manojgulati/Harmonic-Analyser/Harmonic Analyser/Project_Report/Power Harmonic Analyser using ADE7880 and KL-34 Processor ver 1.0.pptx

## Power Harmonic Analyser using ADE7880 and KL-34 Processor

Manoj Gulati
SESDP-14
11/17/2014

## Non Intrusive Load Monitoring

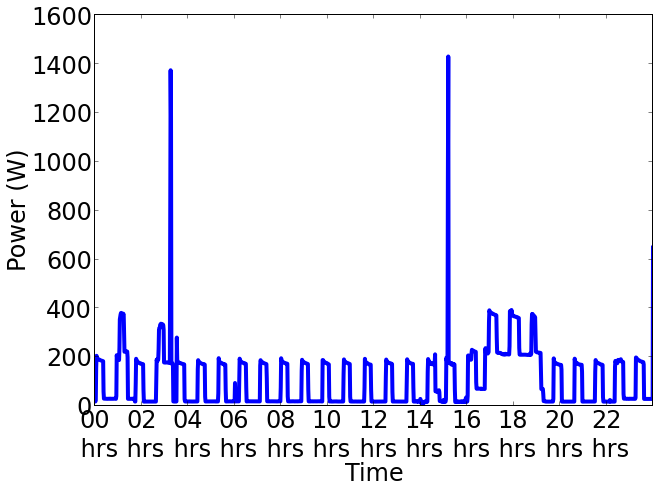
[picture p5: figure]
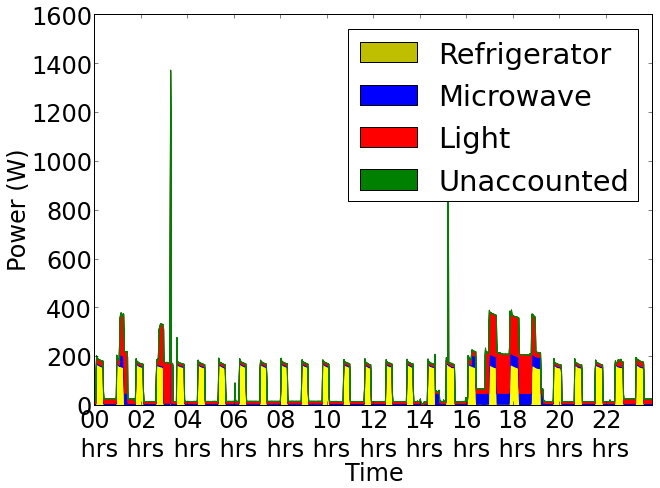
[picture p6: figure]

Image Source- http://energy.iiitd.edu.in

## Challenges with Time Domain

Time varying power consumption [Barker, 2013]

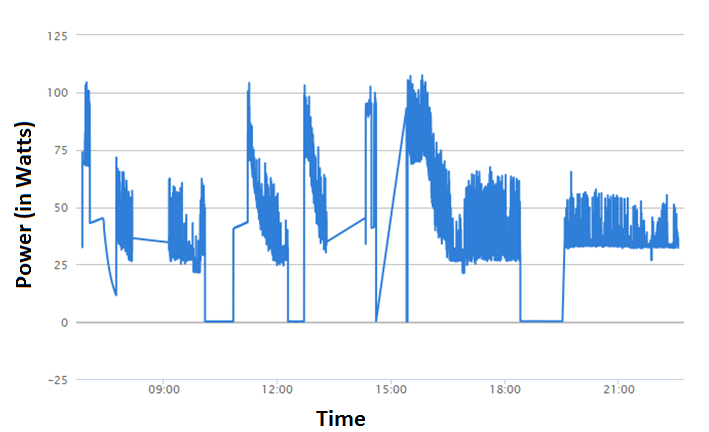
[picture p7: figure]

Figure: Time varying power consumption of a laptop charger.

100 W

Image: Batra, 2013

Notes: Why single point sensing is complex?

Answer to this question lies in this plot. As we know most of the time series modelling approaches are based on a assumption that appliances show time-invariant power consumption.

But in practice most of the present day appliances don’t follow this. Now question comes why ? I will try to answer this in coming slides.

Few more challenges include appliances with similar power signatures and low power appliances which get overlapped and make disaggregation a complex task.

## Slide 4

Time varying power consumption of a laptop charger

100 W

Notes: Why single point sensing is complex?

Answer to this question lies in this plot. As we know most of the time series modelling approaches are based on a assumption that appliances show time-invariant power consumption.

But in practice most of the present day appliances don’t follow this. Now question comes why ? I will try to answer this in coming slides.

Few more challenges include appliances with similar power signatures and low power appliances which get overlapped and make disaggregation a complex task.

## Possible Solution

- Frequency Domain analysis using power line harmonics.

## COTS

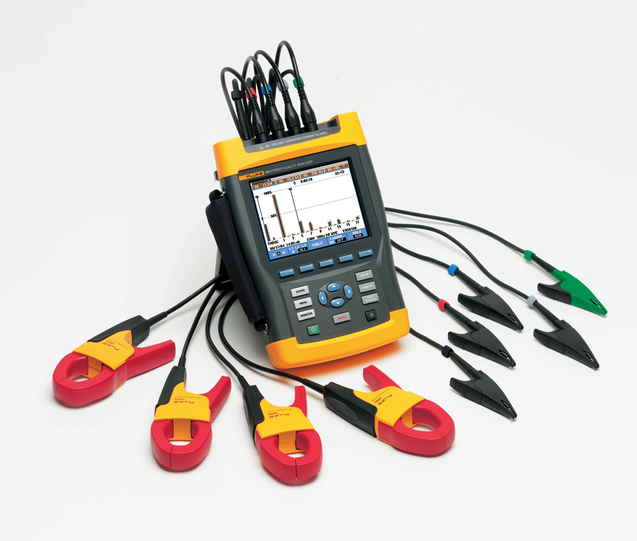
[picture p8: figure]

- Cost around 2 lakhs
- Lack of configurability
- Lack of communication interfaces

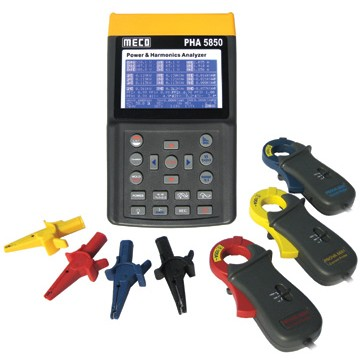
[picture p9: figure]

Challenges with COTS

## Harmonic Analyser

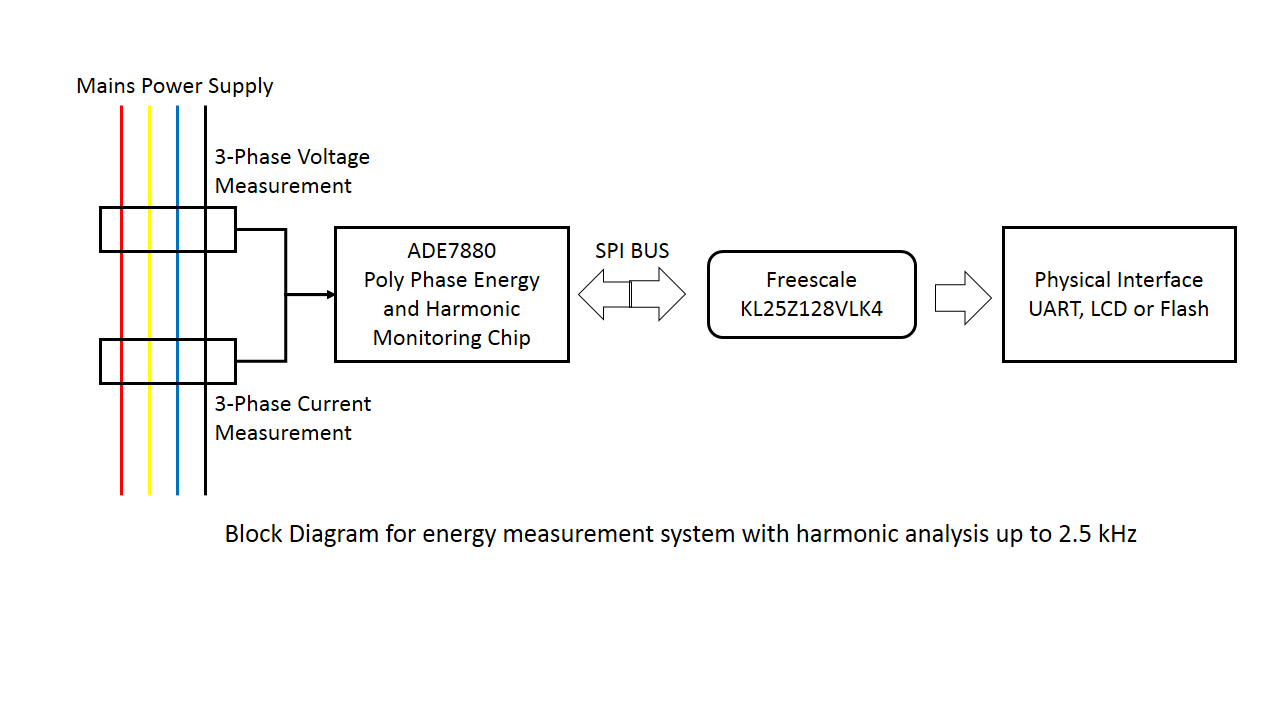
[picture p10: figure]

KL34

## Any Progress??

## Thank You

Manojg.
