manojgulati/Harmonic-Analyser/Harmonic Analyser/Project_Report/Presentation1.pptx

## Slide 2

Mains Power Supply

Serial Flash
(Local Storage)

3-Phase Voltage Measurement

ADE7880
Poly Phase Energy and Harmonic Monitoring Chip

SPI BUS

Serial Communication Interface
UART, RS-485

3-Phase Current Measurement

Freescale MKM34Z128CLL5

Graphic Display

Block Diagram For Energy Measurement System With Harmonic Analysis Up To 2.5 Khz

## Slide 3

VOLTAGE
CONDITIONING

## Slide 4

Block Diagram of proposed energy measurement system with harmonic analysis up to 2.5 kHz

Mains Power Supply

3-Phase Voltage Measurement

Signal Conditioning Circuit

Voltage Conditioning Circuit

Current Conditioning Circuit

3-Phase Current Measurement

Local Storage

Analog Data Acquisition System

Signal Processing and Harmonic Computation System

Controller Circuit

Graphical Display

Communication Interface
