manojgulati/Harmonic-Analyser/Harmonic Analyser/Proposals/Presentation1.pptx

## Slide 2

Mains Power Supply

3-Phase Voltage Measurement

ADE7880
Poly Phase Energy and Harmonic Monitoring Chip

SPI BUS

Physical Interface
UART, LCD or Flash

3-Phase Current Measurement

Freescale MKM34Z128CLL5

Block Diagram for energy measurement system with harmonic analysis up to 2.5 kHz
