manojgulati/Harmonic-Analyser/Harmonic Analyser/Orcad_Capture_SESDP/ver2.10/Project_Layout_Outline.docx

HEADER-3

HEADER-1

LED – CF2

LED – CF3

LED - CF1

I (Phase-A)

I (Phase-N)

I (Phase-C)

I (Phase-B)

Analog Devices

ADE-7880

V (Phase-N)

V (Phase-C)

V (Phase-A)

HEADER-2

V (Phase-B)

Graphic LCD

Freescale

KM-34

100 TQFP

SPI-0 BUS SPI-1 BUS

USB

BUS

FT232-RL

SPI Flash

SW-5

SW-4

SW-3

SW-2

SW-1
