manojgulati/Harmonic-Analyser/Harmonic Analyser/Orcad_Capture_SESDP/ver2.12/HA-EDITEDnet.rep.docx

NET LIST REPORT -- HARMONICS ANALYSER-A.pcb -- Fri Jan 30 11:49:36 2015

*SIG +3.3V

C101.1.U C102.1.U U17.10.U C52.1.U

C73.1.U J81.1.U C74.1.U J83.1.U

C77.1.U C78.1.U C79.1.U C85.1.U

R85.1.U R92.1.U C89.1.U R89.2.U

C96.2.U U17.62.U C99.1.U D1.1.U

D4.2.U D2.2.U J17.3.U D3.2.U

D5.2.U D6.2.U J14.10.S J94.4.U

J25.1.U R12.1.U J95.2.U U17.61.U

L13.1.U LCD1.14.U LCD1.28.U U13.8.U

R13.1.U R14.2.U U12.2.U R15.1.U

R23.1.U R25.2.U U1.26.U R93.1.U

U1.5.U U19.8.U U23.8.U

*SIG /RD

LCD1.5.U U17.6.U

*SIG /WR

LCD1.4.U U17.4.U

*SIG 5V

C95.2.U C92.1.U J13.1.U U12.1.U

K1.5.U D12.1.U

*SIG A0

LCD1.3.U U17.3.U

*SIG AGND

C107.2.U C108.2.U C109.2.U C110.2.U

C87.2.U C55.2.U C53.2.U C56.1.U

C54.1.U R113.1.U C69.2.U C60.2.U

C58.2.U C61.1.U C59.1.U R58.2.U

R59.1.U C70.1.U C64.2.U R71.1.U

C65.1.U C66.2.U C67.1.U R78.1.U

C68.2.U R79.2.U C72.1.U C71.2.U

R80.1.U C75.2.U C76.2.U L17.1.U

C81.2.U C83.2.U C93.2.U C94.2.U

R90.1.U R107.1.U R51.2.U R52.1.U

R70.2.U TP9.1.U TP10.1.U TP7.1.U

TP6.1.U SW1.1.U TP8.1.U U1.25.U

SW1.2.U

*SIG AVDD

R89.1.U J82.1.U C76.1.U C75.1.U

U1.24.U

*SIG CF1

U17.71.U J5.3.U J1.1.U U1.33.U

D10.1.U J6.3.U

*SIG CF2

U17.70.U J6.2.U J5.4.U D7.1.U

J3.1.U U1.34.U

*SIG CF3

U17.69.U J6.1.U J5.5.U J4.1.U

D11.1.U U1.35.U

*SIG CLKIN

U1.27.U R2.1.U Y1.1.U C30.2.U

*SIG CLKOUT

U1.28.U R2.2.U Y1.2.U C29.2.U

*SIG CS1

LCD1.1.U U17.1.U

*SIG D0

LCD1.6.U U17.9.U

*SIG D1

LCD1.7.U U17.12.U

*SIG D2

LCD1.8.U U17.13.U

*SIG D3

LCD1.9.U U17.14.U

*SIG D4
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

C17.1.U LCD1.21.U

*SIG N1983147

C18.1.U LCD1.22.U

*SIG N1983151

C18.2.U C19.2.U C20.2.U C21.2.U

C22.2.U

*SIG N1983167

C20.1.U LCD1.24.U

*SIG N1983179

C19.1.U LCD1.23.U

*SIG N1983183

C21.1.U LCD1.25.U

*SIG N1983207

R14.1.U LCD1.30.U

*SIG N1983211

C22.1.U LCD1.26.U

*SIG N1983241

LCD1.27.U J2.2.U

*SIG N1983309

R16.1.U J2.3.U

*SIG N2275511

R72.2.U C66.1.U R75.1.U

*SIG N2580186

R95.1.U D7.2.U

*SIG N2586115

R96.1.U D10.2.U

*SIG N2613784

R76.1.U R98.2.U

*SIG N2618478

R98.1.U R77.2.U

*SIG N2635561

R100.2.U R78.2.U L10.2.U

*SIG N2636856

R99.1.U R76.2.U

*SIG N2691596

R103.1.U R101.2.U

*SIG N2691672

R105.1.U R106.2.U

*SIG N2691700

R106.1.U R103.2.U

*SIG N2721847

R108.1.U R102.2.U

*SIG N2721891

L15.2.U R107.2.U R109.2.U

*SIG N2721927

R110.1.U R111.2.U

*SIG N2721955

R111.1.U R108.2.U

*SIG N2759148

L16.2.U R113.2.U R115.2.U

*SIG N2759210

R114.1.U R112.2.U

*SIG N2759258

L16.1.U R116.2.U

*SIG N2759290

R116.1.U R117.2.U

*SIG N2759318

R117.1.U R114.2.U

*SIG N3004104

R97.1.U D11.2.U

*SIG N3274451

L10.1.U R99.2.U

*SIG N3328925

L15.1.U R110.2.U

*SIG N3437331

R50.1.U D1.2.U

*SIG N19748480

R86.1.U D9.1.U

*SIG N19749300

R87.1.U D8.1.U

*SIG N19829790

R15.2.U J2.1.U

*SIG N197275034

U17.37.U C103.2.U

*SIG NC

U1.10.U U1.11.U U1.20.U U1.21.U

U1.30.U U1.31.U U1.40.U U1.1.U

*SIG NMI_B

U17.5.U J17.2.U

*SIG PM0

J78.1.U U1.2.U U17.74.U J5.10.U

J6.6.U

*SIG PM1

J79.1.U U1.3.U U17.75.U J5.11.U

J6.7.U

*SIG REF

C83.1.U C81.1.U J98.1.U U1.17.U

*SIG RES

LCD1.2.U U17.2.U

*SIG RESETB

U1.4.U C85.2.U R85.2.U SW1.4.U

SW1.3.U

*SIG RESET_B

J95.4.U U17.56.U TS.3.U R23.2.U

C106.1.U

*SIG RTC_CLKOUT

J95.1.U U17.67.U

*SIG SCK

U1.36.U J5.6.U U17.78.U J6.10.U

*SIG SS_B

J6.9.U U17.77.U J5.9.U U1.39.U

*SIG SWD_CLK

J95.3.U U17.66.U U19.4.U

*SIG SWD_IO

U19.1.U U17.65.U J95.5.U

*SIG VAP

R109.1.U C108.1.U J49.1.U C107.1.U

U1.23.U

*SIG VAP_IN

R102.1.U J99.3.U

*SIG VBP

R115.1.U C110.1.U C109.1.U J54.1.U

U1.22.U

*SIG VBP_IN

R112.1.U J99.2.U

*SIG VCP

R100.1.U C68.1.U C87.1.U J68.1.U

U1.19.U

*SIG VCP_IN

R77.1.U J99.1.U

*SIG VDDA

U17.32.U J90.1.S J93.1.U J90.9.S

J85.1.S J85.9.S

*SIG VDD_FT232

U20.4.U U21.8.U R91.1.U D9.2.U

U20.17.U D8.2.U C90.1.U R94.1.U

C86.1.U

*SIG VN

U1.18.U J37.1.U C93.1.U C94.1.U

R9.2.U

*SIG VN_IN

R101.1.U J99.4.U

*SIG VREF

J90.8.S J85.8.S C105.2.U

*SIG VREFH

J90.6.S J85.6.S C103.1.U

*SIG VREFL

J90.7.S J85.7.S C104.2.U

*SIG ~IRQ0

U1.32.U J96.1.U J5.2.U U17.72.U

J6.4.U

*SIG ~IRQ1

U1.29.U J89.1.U J5.1.U U17.73.U

J6.5.U

*SIG $$$1

J7.1.U K1.1.U

*SIG $$$2

J93.5.U U17.31.U L13.2.U C97.1.U

C98.1.U

*SIG $$$3

J7.2.U K1.3.U

*SIG $$$4

J7.3.U K1.4.U

*SIG $$$5

K1.2.U D12.2.U Q1.C.U

*SIG $$$6

R3.2.U Q1.B.U

*SIG $$$7

R3.1.U U17.50.U

*SIG $$$8

R105.2.U L14.1.U

*SIG $$$9

R9.1.U R90.2.U L14.2.U
