manojgulati/Harmonic-Analyser/Harmonic Analyser/EVAL-ADE7880EBZ_2.PNG

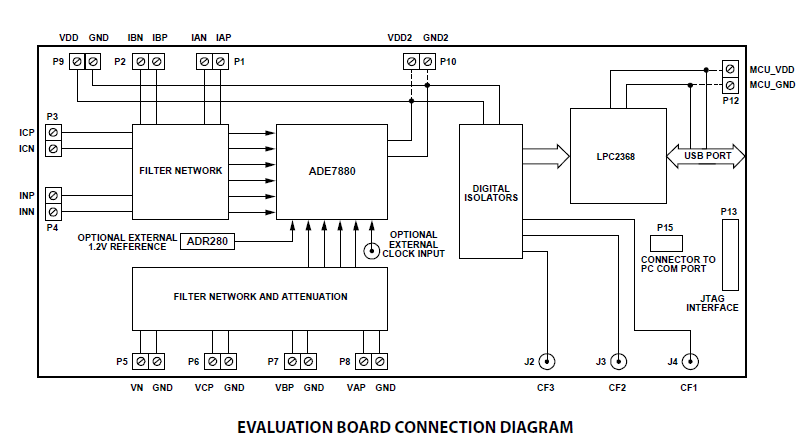
Harmonic Analyser/EVAL-ADE7880EBZ_2.PNG
