manojgulati/Harmonic-Analyser/Harmonic Analyser/Project_Report/Power Harmonic Analyser using ADE7880 and KL-34 Processor ver 1.0.png

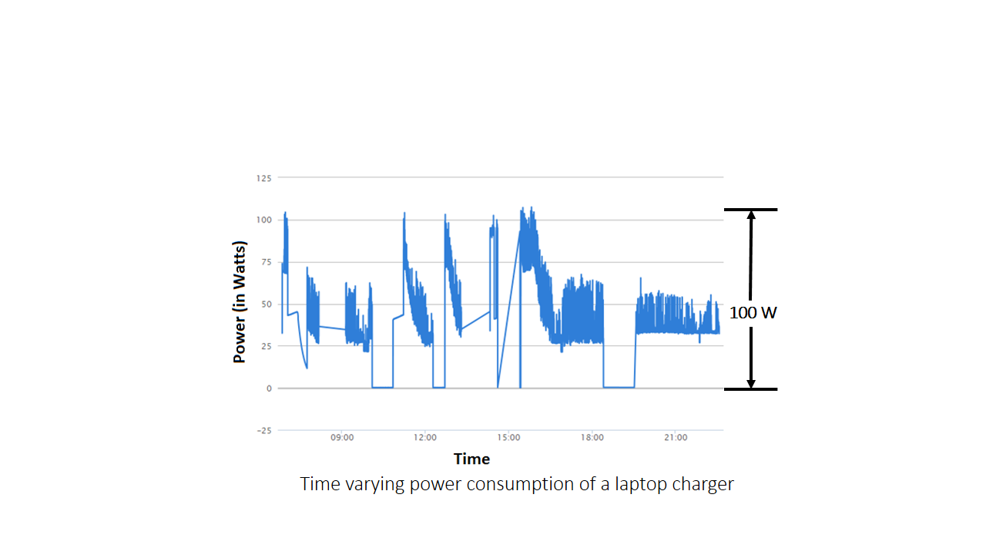
Harmonic Analyser/Project_Report/Power Harmonic Analyser using ADE7880 and KL-34 Processor ver 1.0.png
