manojgulati/Harmonic-Analyser/Harmonic Analyser/Project_Report/Presentation3.jpg

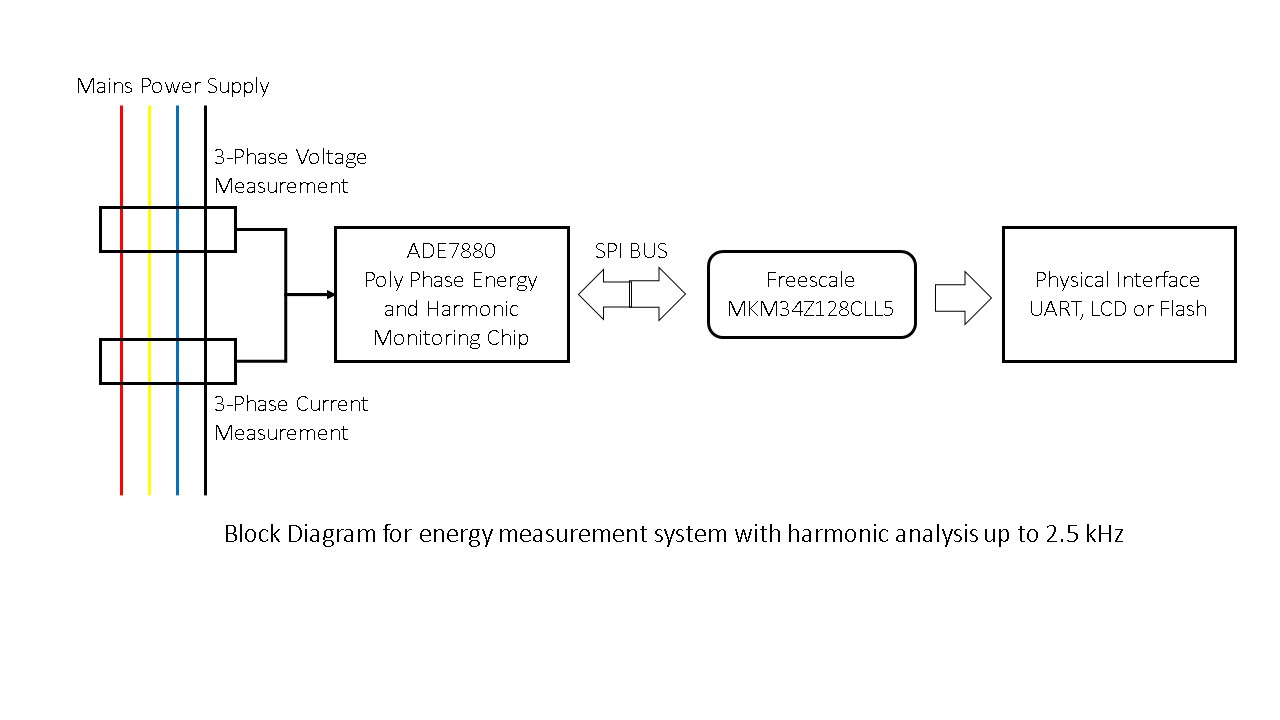
Harmonic Analyser/Project_Report/Presentation3.jpg
