manojgulati/Harmonic-Analyser/Harmonic Analyser/Orcad_Capture_SESDP/ver2.0/PAGE1_SCHEMATIC1_PAGE6.dxf

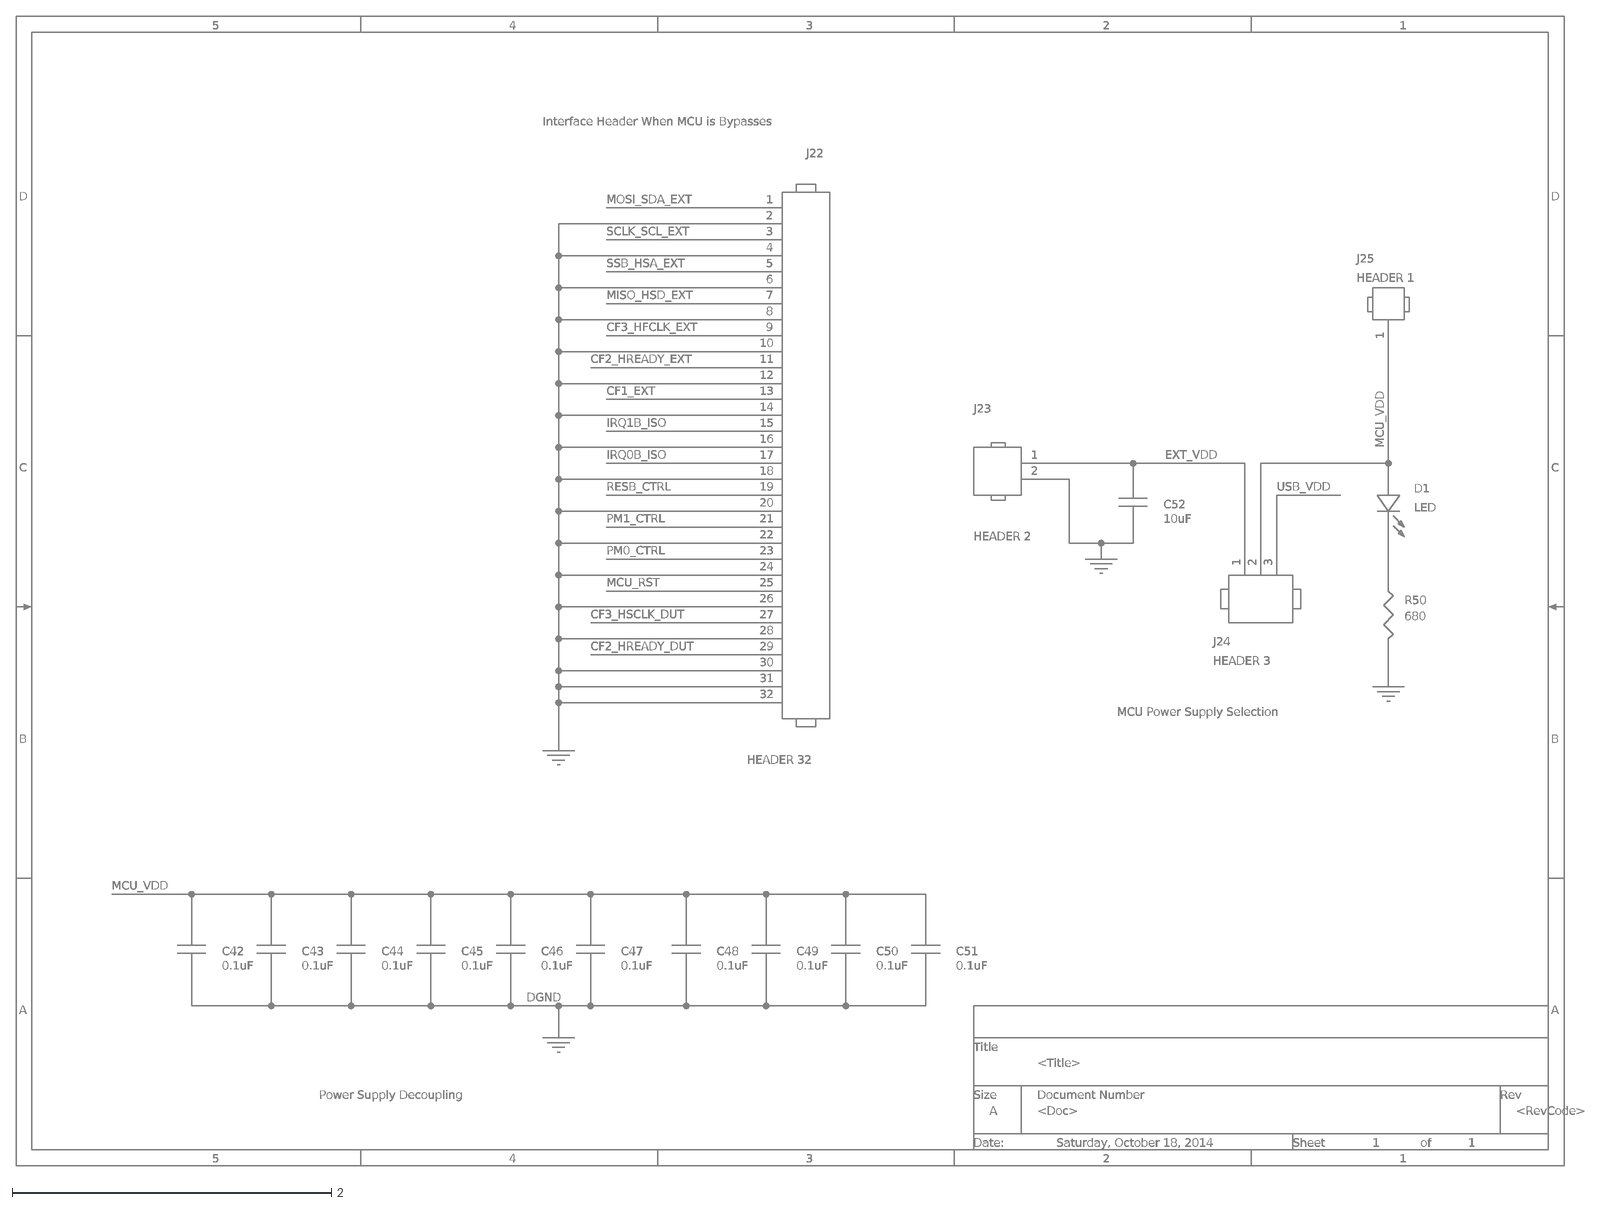
[picture p47: CAD file, 2014-12-17, an earlier design]
Harmonic Analyser/Orcad_Capture_SESDP/ver2.0/PAGE1_SCHEMATIC1_PAGE6.dxf
5
4
3
2
1
D
C
B
A
<Doc>
<RevCode>
<Title>
Saturday, October 18, 2014
Title
Size
Document Number
Rev
Date:
Sheet
of
C42
0.1uF
C44
C52
10uF
C48
C43
C47
D1
LED
J25
HEADER 1
C51
C46
R50
680
J23
HEADER 2
C50
J22
HEADER 32
6
7
8
9
10
11
12
13
14
15
16
17
18
19
20
21
22
23
24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
