manojgulati/Harmonic-Analyser/Harmonic Analyser/Orcad_Capture_SESDP/ver2.1/PAGE1_SCHEMATIC1_PAGE8.dxf

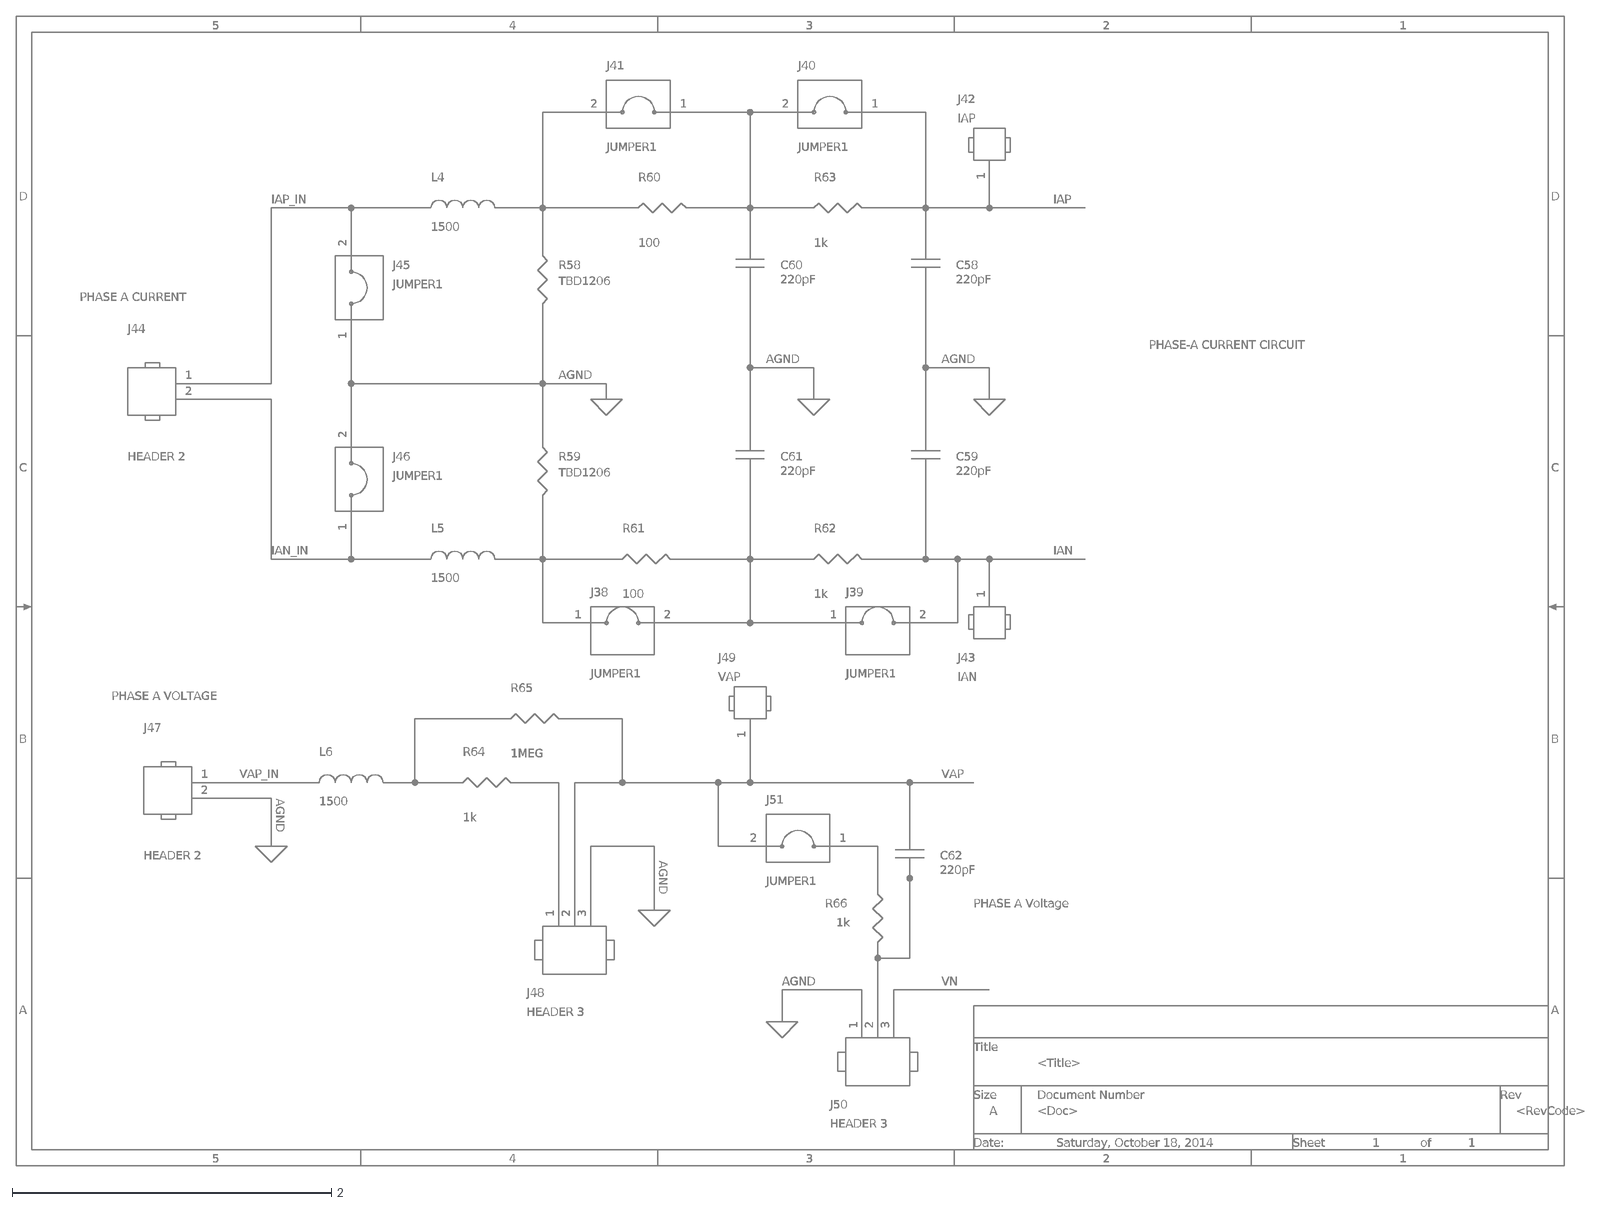
[picture p48: CAD file, 2014-12-17, an earlier design]
Harmonic Analyser/Orcad_Capture_SESDP/ver2.1/PAGE1_SCHEMATIC1_PAGE8.dxf
5
4
3
2
1
D
C
B
A
<Doc>
<RevCode>
<Title>
Saturday, October 18, 2014
Title
Size
Document Number
Rev
Date:
Sheet
of
R60
100
J45
JUMPER1
J47
HEADER 2
C61
220pF
J50
HEADER 3
R61
J46
J42
IAP
L6
1500
R62
1k
J43
IAN
R66
R64
R63
L4
J48
C58
J40
R58
TBD1206
L5
J38
C62
J51
C59
R65
1MEG
J41
R59
J44
J49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
