manojgulati/Harmonic-Analyser/Harmonic Analyser/Orcad_Capture_SESDP/ver2.2/PAGE1_SCHEMATIC1_PAGE10.dxf

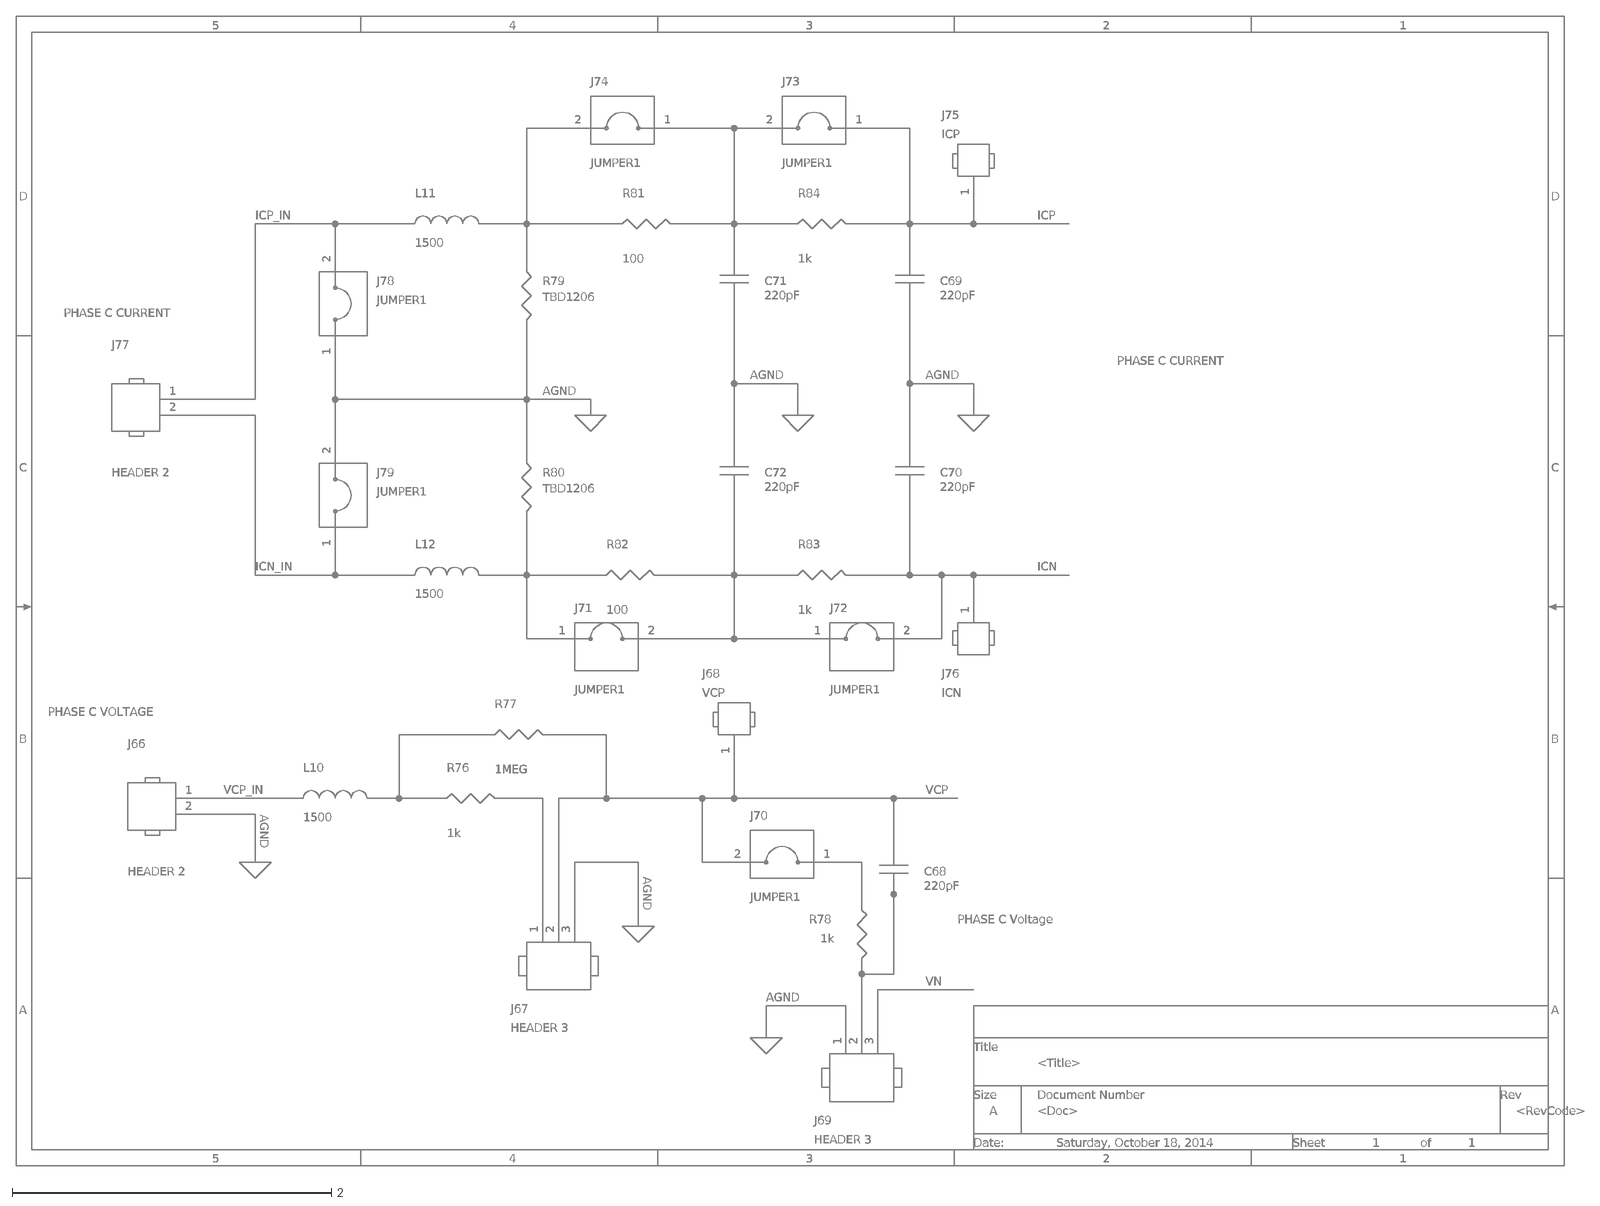
[picture p49: CAD file, 2014-12-17, an earlier design]
Harmonic Analyser/Orcad_Capture_SESDP/ver2.2/PAGE1_SCHEMATIC1_PAGE10.dxf
5
4
3
2
1
D
C
B
A
<Doc>
<RevCode>
<Title>
Saturday, October 18, 2014
Title
Size
Document Number
Rev
Date:
Sheet
of
R77
1MEG
J73
JUMPER1
C69
220pF
R79
TBD1206
L12
1500
J71
J66
HEADER 2
J74
C70
R80
J77
L10
J72
C71
J69
HEADER 3
R81
100
J78
R76
1k
J75
ICP
C72
R82
J79
J67
R78
R83
J76
ICN
C68
R84
J68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
