manojgulati/Harmonic-Analyser/Harmonic Analyser/Orcad_Capture_SESDP/ver1.8/Manoj_SCHEMATIC1_PAGE9.dxf

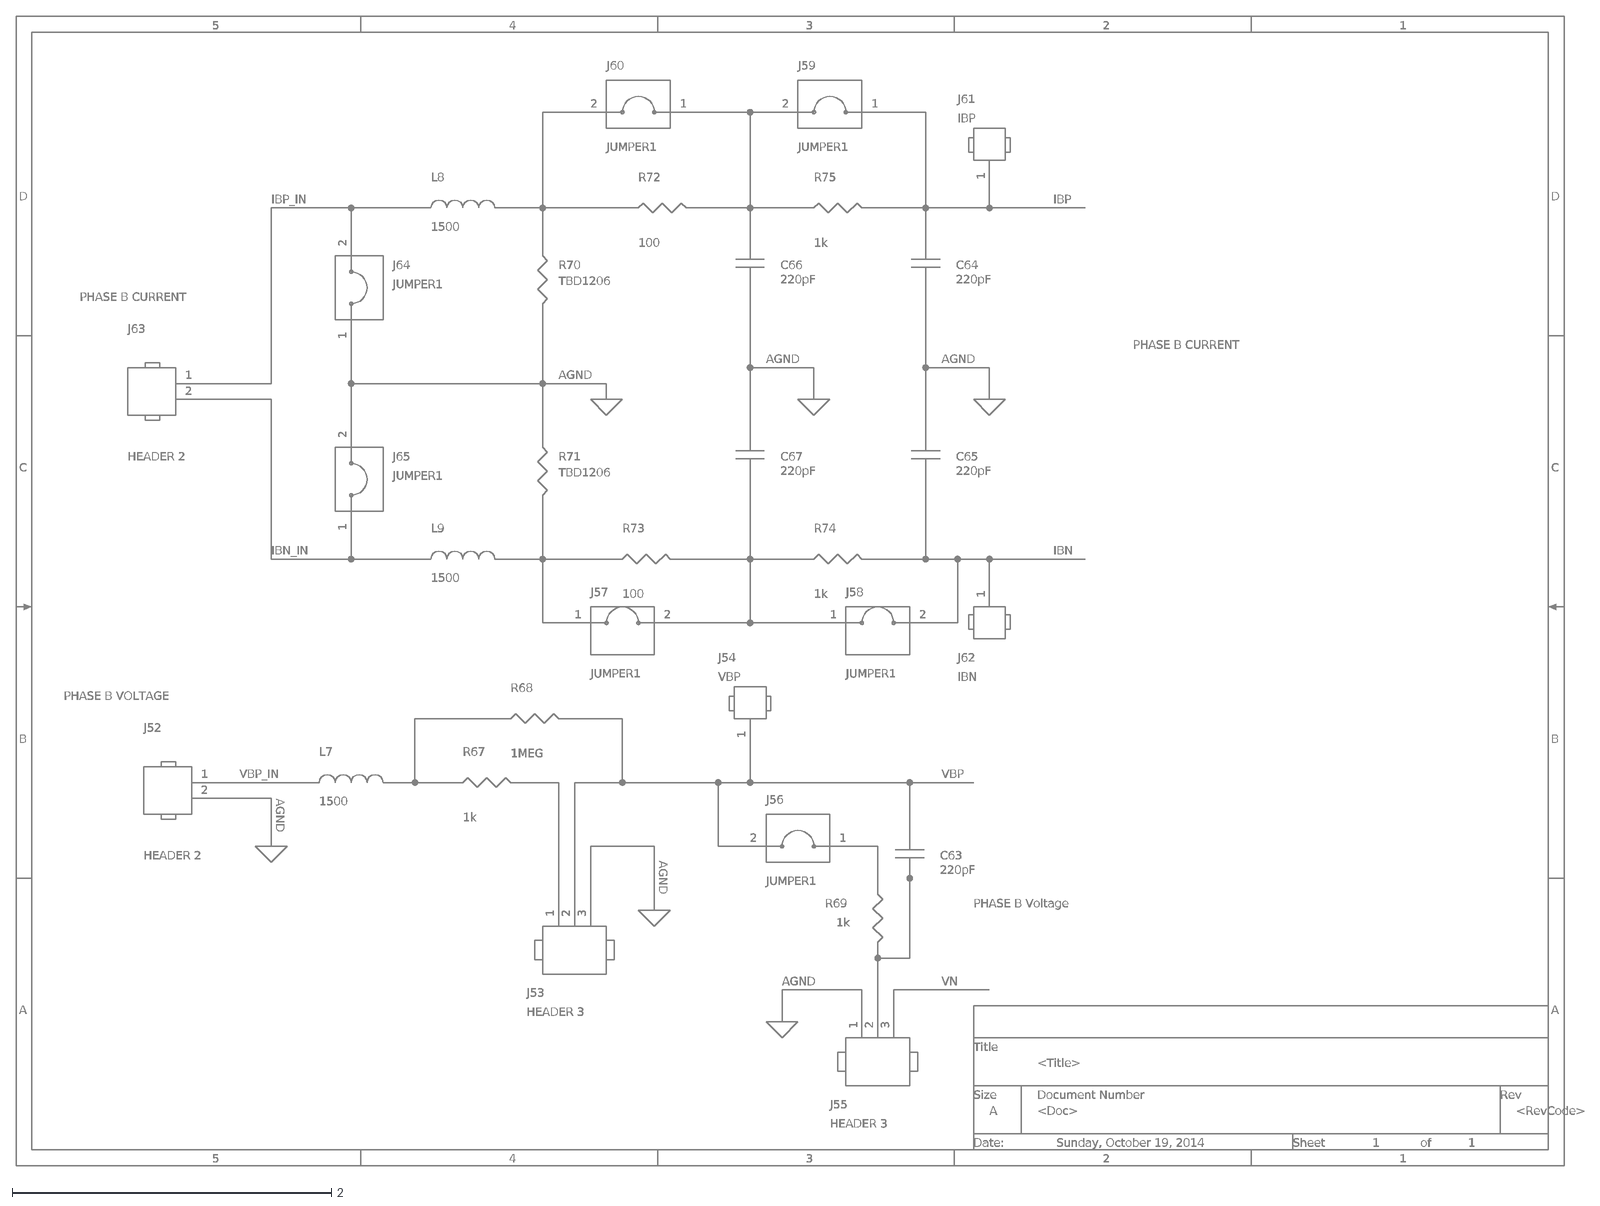
[picture p50: CAD file, 2014-12-17, an earlier design]
Harmonic Analyser/Orcad_Capture_SESDP/ver1.8/Manoj_SCHEMATIC1_PAGE9.dxf
5
4
3
2
1
D
C
B
A
<Doc>
<RevCode>
<Title>
Sunday, October 19, 2014
Title
Size
Document Number
Rev
Date:
Sheet
of
J54
VBP
J56
JUMPER1
J61
IBP
R69
1k
C66
220pF
C63
J57
C65
R67
J53
HEADER 3
C64
L7
1500
C67
R75
J52
HEADER 2
J60
R74
J59
J58
R73
100
R68
1MEG
R72
J65
R71
TBD1206
R70
J64
J63
L9
J55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
