manojgulati/Harmonic-Analyser/Harmonic Analyser/Orcad_Capture_SESDP/ver1.8/Manoj_SCHEMATIC1_PAGE2.dxf

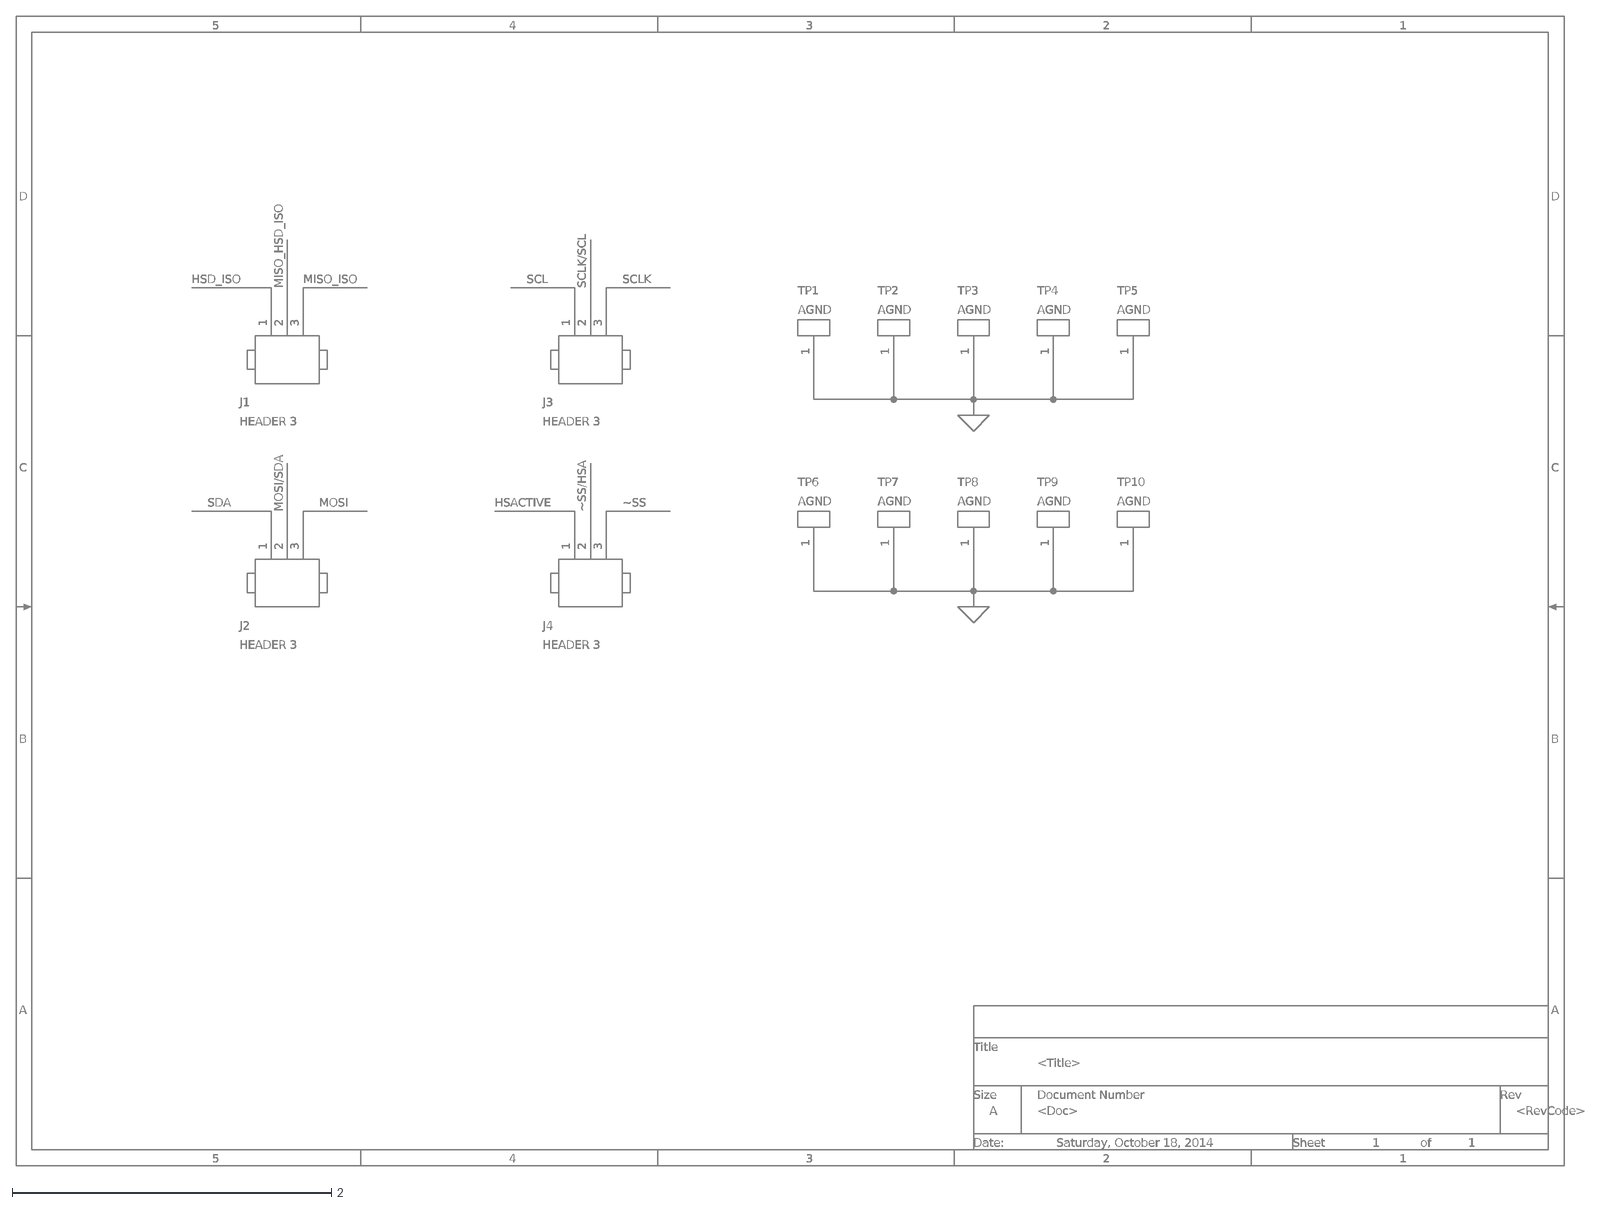
[picture p51: CAD file, 2014-12-17, an earlier design]
Harmonic Analyser/Orcad_Capture_SESDP/ver1.8/Manoj_SCHEMATIC1_PAGE2.dxf
5
4
3
2
1
D
C
B
A
<Doc>
<RevCode>
<Title>
Saturday, October 18, 2014
Title
Size
Document Number
Rev
Date:
Sheet
of
TP1
AGND
TP5
J2
HEADER 3
J3
TP2
TP6
J4
TP7
TP3
TP8
TP9
TP4
J1
TP10
MISO_ISO
MISO_HSD_ISO
HSD_ISO
SCLK
SCLK/SCL
SCL
~SS
~SS/HSA
HSACTIVE
MOSI
MOSI/SDA
SDA
