manojgulati/Harmonic-Analyser/Harmonic Analyser/Orcad_Capture_SESDP/ver2.1/PAGE1_SCHEMATIC1_PAGE1.dxf

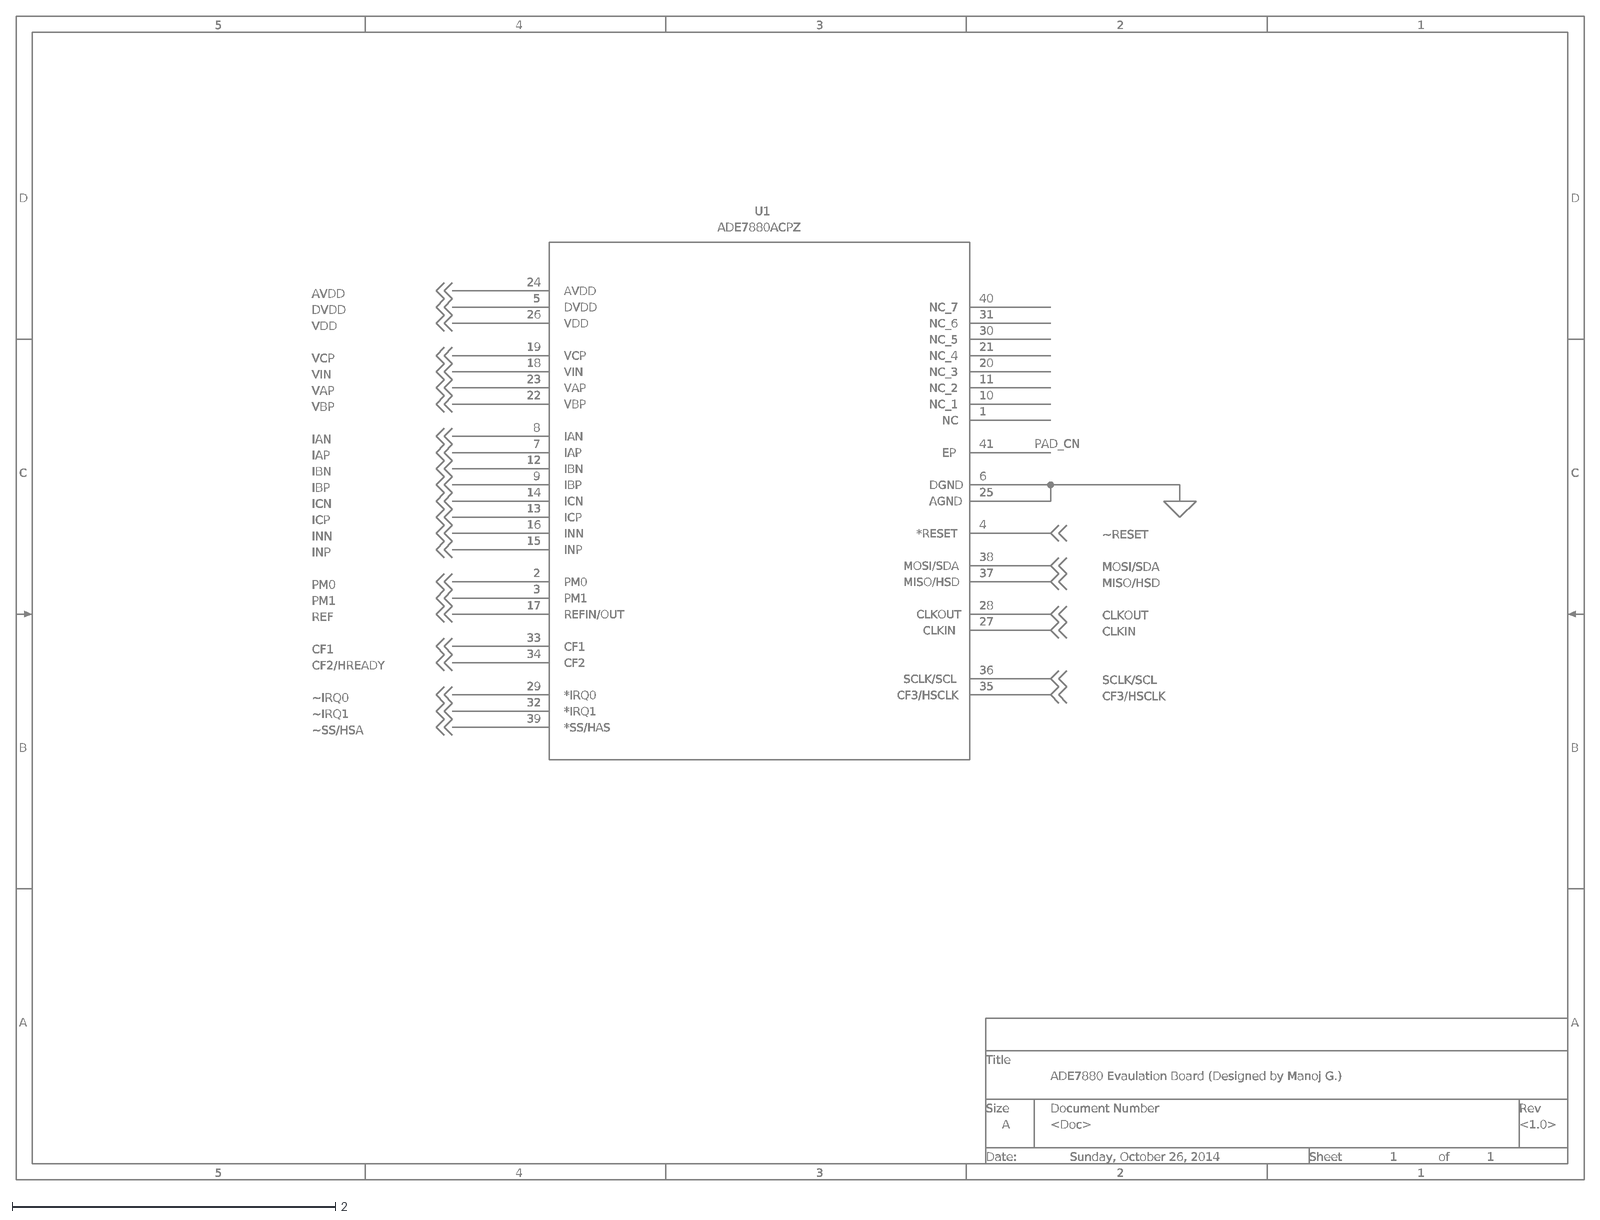
[picture p52: CAD file, 2014-12-17, an earlier design]
Harmonic Analyser/Orcad_Capture_SESDP/ver2.1/PAGE1_SCHEMATIC1_PAGE1.dxf
5
4
3
2
1
D
C
B
A
<Doc>
<1.0>
ADE7880 Evaulation Board (Designed by Manoj G.)
Sunday, October 26, 2014
Title
Size
Document Number
Rev
Date:
Sheet
of
U1
ADE7880ACPZ
NC
PM0
PM1
*RESET
DVDD
DGND
6
IAP
7
IAN
8
IBP
9
NC_1
10
NC_2
11
IBN
12
ICP
13
ICN
14
INP
15
INN
16
REFIN/OUT
17
VIN
18
VCP
19
NC_3
20
NC_4
21
VBP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
