manojgulati/Harmonic-Analyser/Harmonic Analyser/Orcad_Capture_SESDP/ver2.3/PAGE1_SCHEMATIC1_PAGE7.dxf

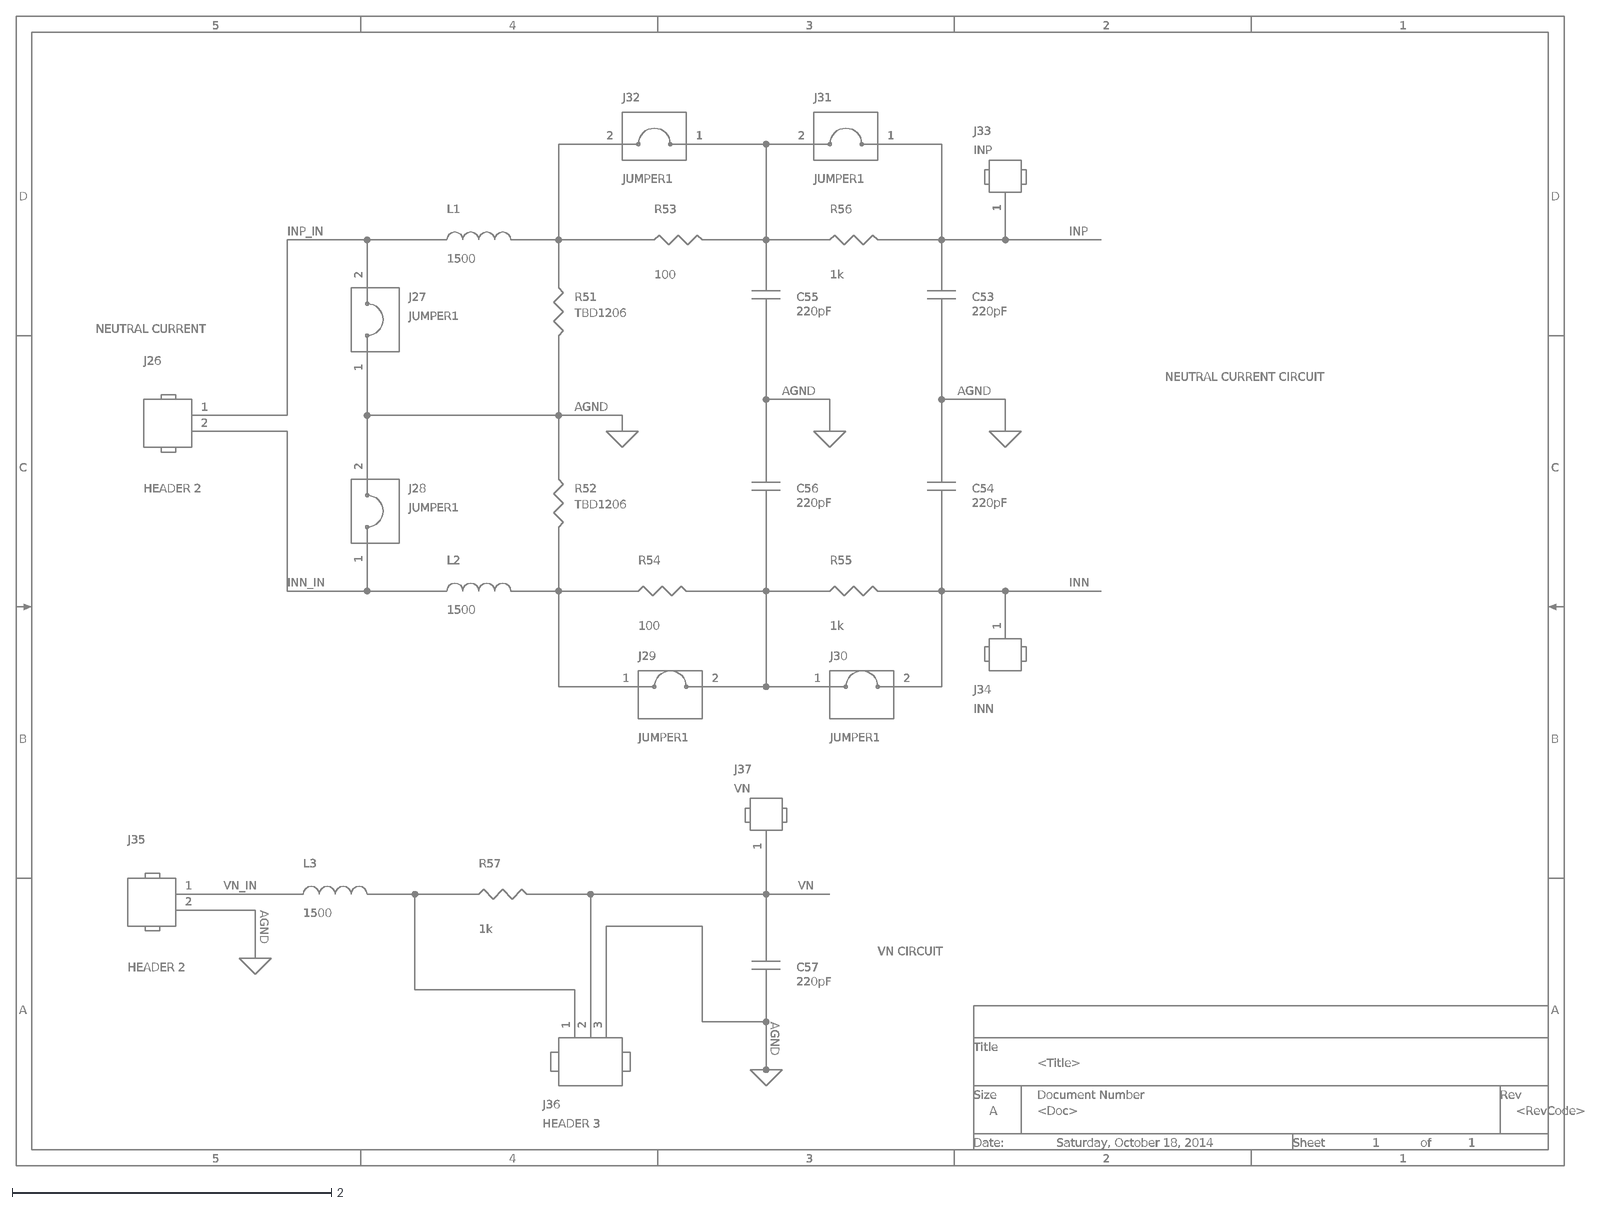
[picture p53: CAD file, 2014-12-17, an earlier design]
Harmonic Analyser/Orcad_Capture_SESDP/ver2.3/PAGE1_SCHEMATIC1_PAGE7.dxf
5
4
3
2
1
D
C
B
A
<Doc>
<RevCode>
<Title>
Saturday, October 18, 2014
Title
Size
Document Number
Rev
Date:
Sheet
of
R54
100
J26
HEADER 2
C53
220pF
J30
JUMPER1
J31
J35
J37
VN
R55
1k
J27
R51
TBD1206
C54
J32
J28
C57
R56
R52
C55
L1
1500
J34
INN
J36
HEADER 3
L2
R53
C56
R57
J29
J33
INP
L3
INP_IN
INN_IN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
