manojgulati/Harmonic-Analyser/Harmonic Analyser/Orcad_Capture_SESDP/ver2.1/PAGE1_SCHEMATIC1_PAGE3.dxf

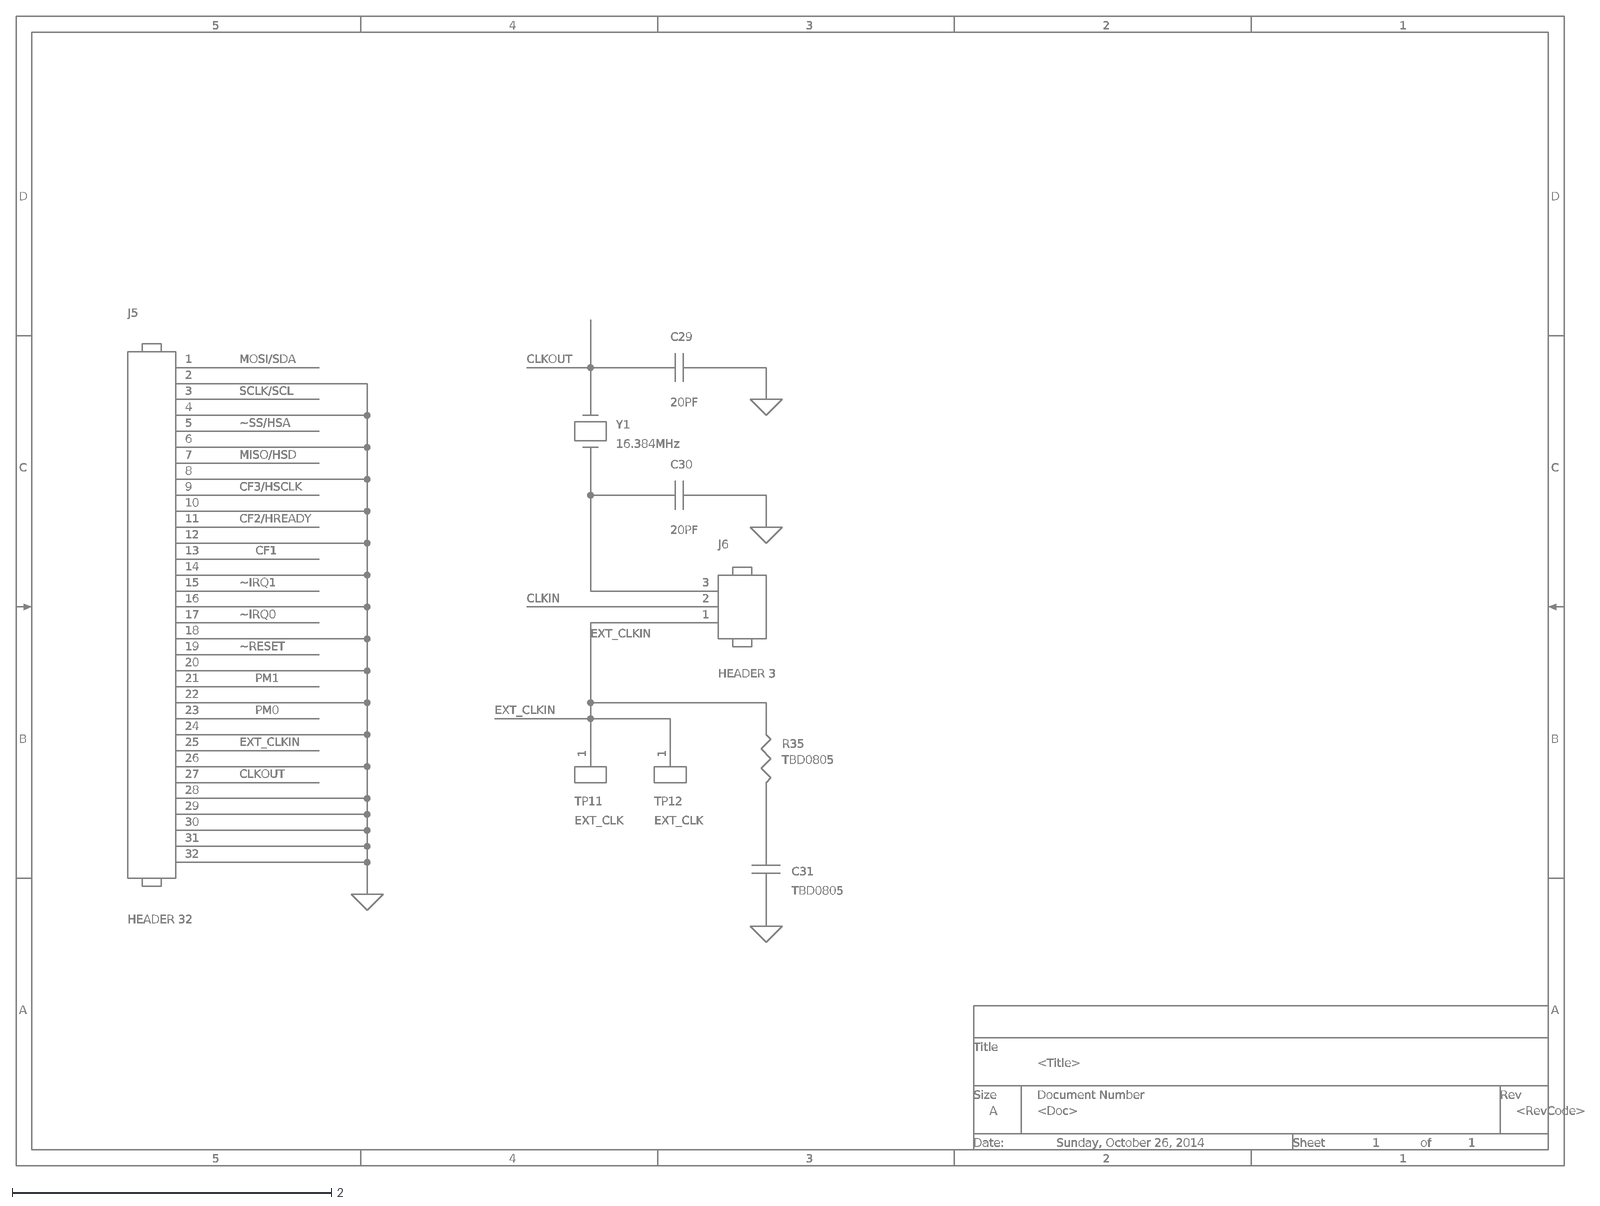
[picture p54: CAD file, 2014-12-17, an earlier design]
Harmonic Analyser/Orcad_Capture_SESDP/ver2.1/PAGE1_SCHEMATIC1_PAGE3.dxf
5
4
3
2
1
D
C
B
A
<Doc>
<RevCode>
<Title>
Sunday, October 26, 2014
Title
Size
Document Number
Rev
Date:
Sheet
of
J5
HEADER 32
6
7
8
9
10
11
12
13
14
15
16
17
18
19
20
21
22
23
24
25
26
27
28
29
30
31
32
TP11
EXT_CLK
C29
20PF
J6
HEADER 3
C31
TBD0805
R35
Y1
16.384MHz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
