manojgulati/Harmonic-Analyser/(list of files, cad)

Other CAD files:
Harmonic Analyser/Orcad_Capture_SESDP/ver2.0/PAGE1_SCHEMATIC1_PAGE9.dxf
Harmonic Analyser/Orcad_Capture_SESDP/ver2.2/PAGE1_SCHEMATIC1_PAGE9.dxf
Harmonic Analyser/Orcad_Capture_SESDP/ver2.3/PAGE1_SCHEMATIC1_PAGE9.dxf
Harmonic Analyser/Orcad_Capture_SESDP/ver1.8/Manoj_SCHEMATIC1_PAGE11.dxf
Harmonic Analyser/Orcad_Capture_SESDP/ver1.8/Manoj_SCHEMATIC1_PAGE3.dxf
Harmonic Analyser/Orcad_Capture_SESDP/ver1.8/Manoj_SCHEMATIC1_PAGE4.dxf
Harmonic Analyser/Orcad_Capture_SESDP/ver1.8/Manoj_SCHEMATIC1_PAGE5.dxf
Harmonic Analyser/Orcad_Capture_SESDP/ver2.0/PAGE1_SCHEMATIC1_PAGE11.dxf
Harmonic Analyser/Orcad_Capture_SESDP/ver2.1/PAGE1_SCHEMATIC1_PAGE11.dxf
Harmonic Analyser/Orcad_Capture_SESDP/ver2.1/PAGE1_SCHEMATIC1_PAGE9.dxf
Harmonic Analyser/Orcad_Capture_SESDP/ver2.2/PAGE1_SCHEMATIC1_PAGE11.dxf
Harmonic Analyser/Orcad_Capture_SESDP/ver2.3/PAGE1_SCHEMATIC1_PAGE11.dxf
