manojgulati/Harmonic-Analyser/Harmonic Analyser/ADE7880 Test Circuit Datasheet.png

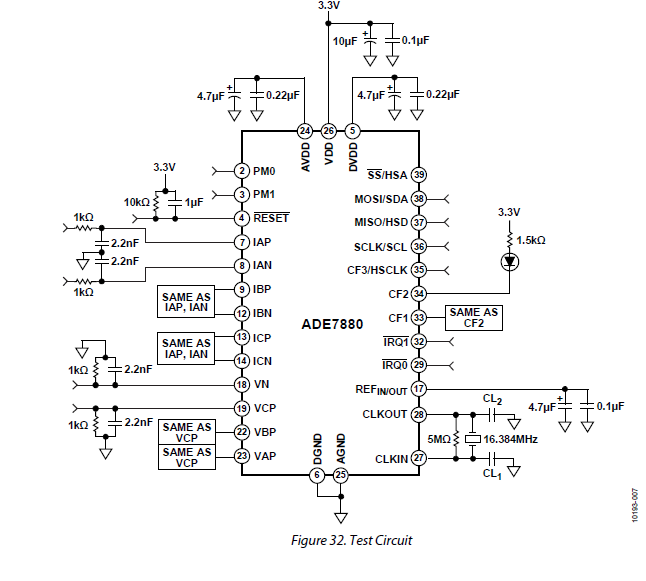
Harmonic Analyser/ADE7880 Test Circuit Datasheet.png
