manojgulati/Harmonic-Analyser/Harmonic Analyser/Orcad_Capture_SESDP/ver2.11/changes made.docx

Harmonic Analyser v2.11

- Extra decoupling capacitors removed (C42 – C51)
- REF in/out pin of ADE7880 decoupled to AGND instead of DGND
- 5Mohm resistor (0805) added between CLKIN and CLKOUT pin of ADE7880
- A pull down resistor of 4.7Kohm (0603) added to RE pin of MAX485
- Package detail of each passive element added
