manojgulati/Harmonic-Analyser/Harmonic Analyser/Project_Report/SCHEMATIC1 _ Split_Design.pdf

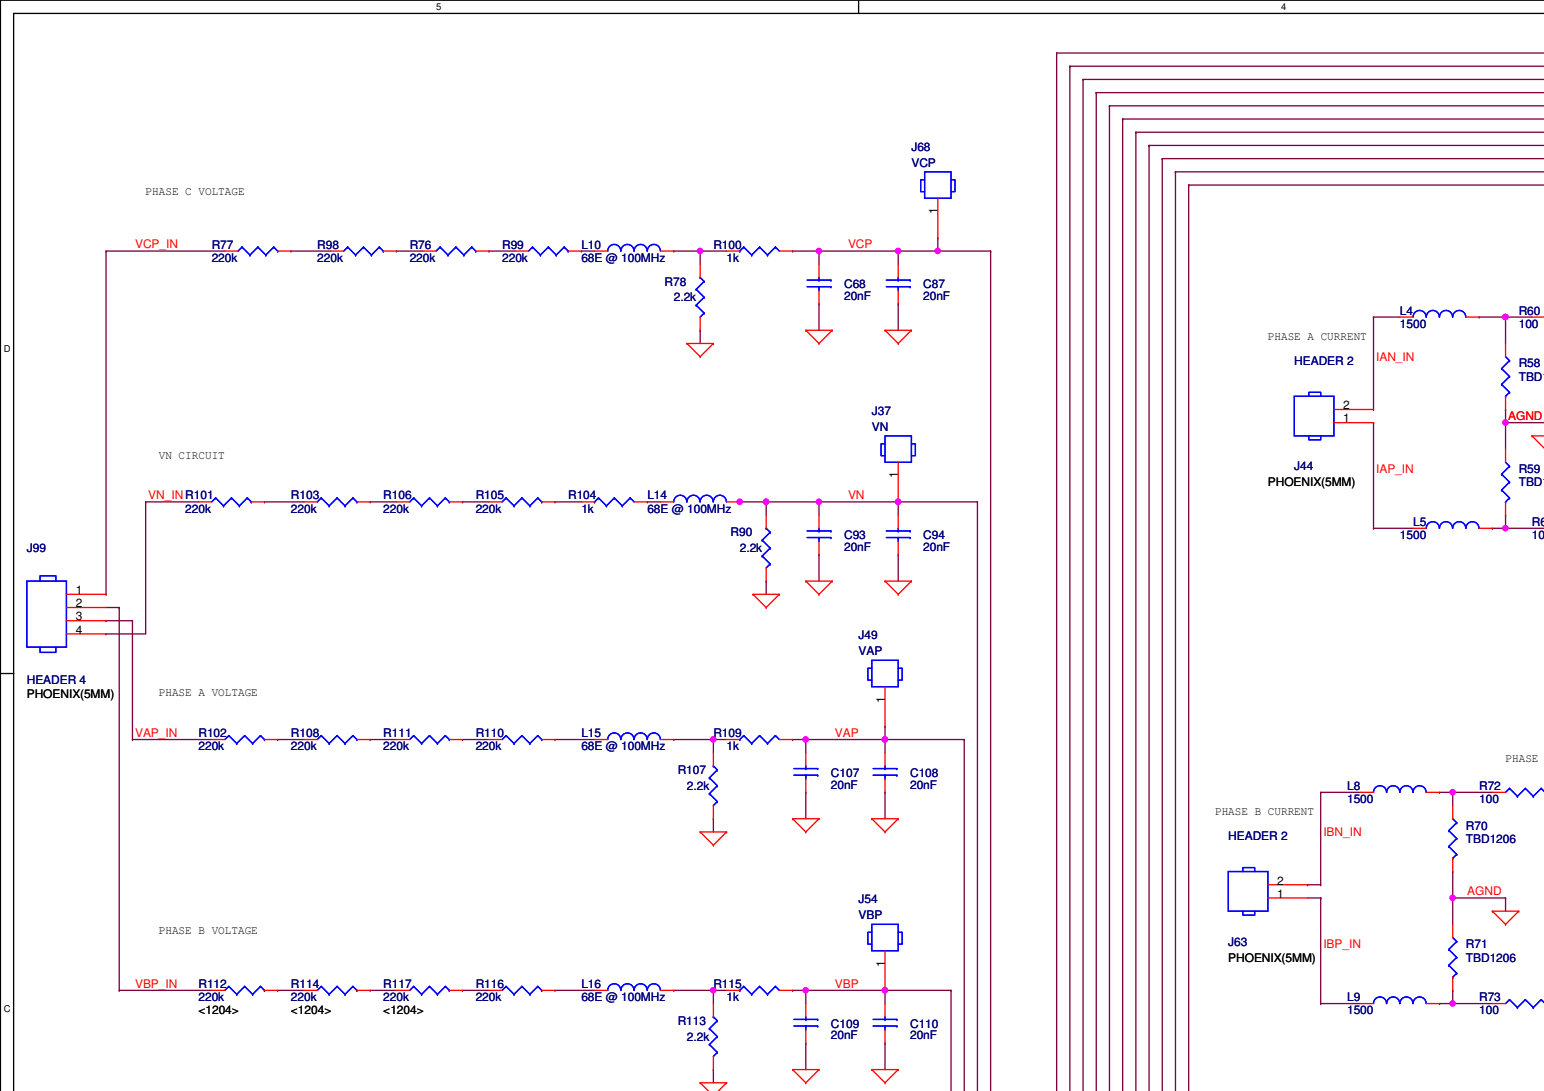
[picture p56: page 1]

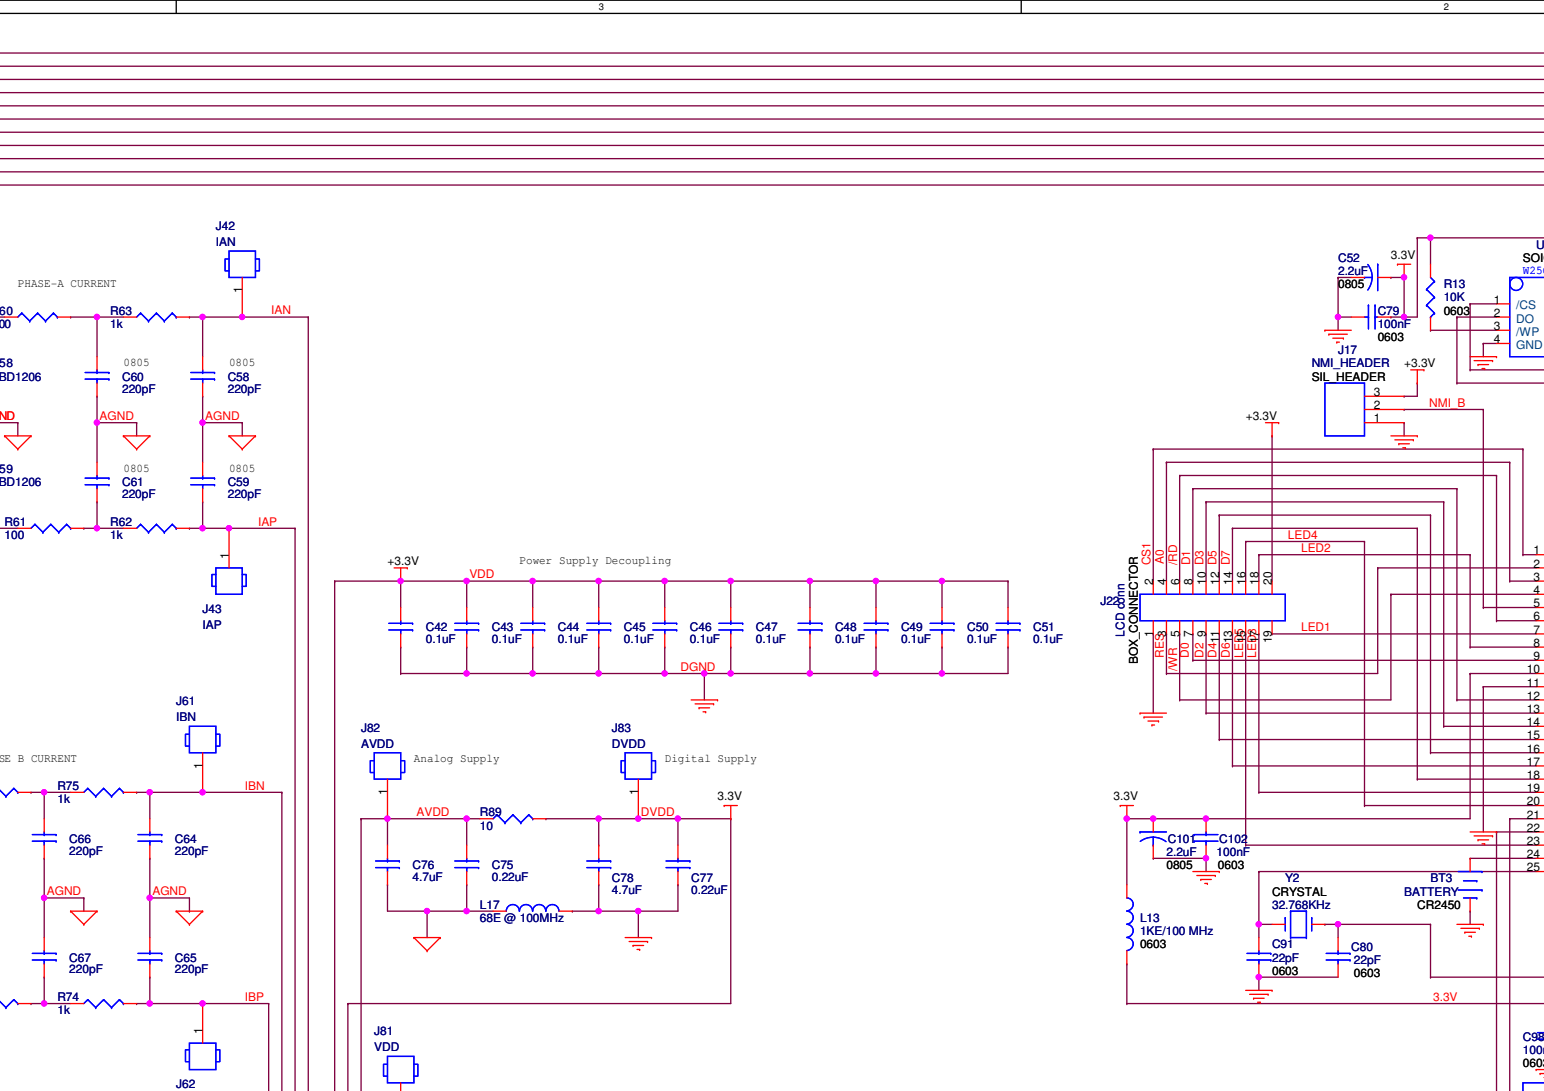
[picture p57: page 2]

LED4
LED2

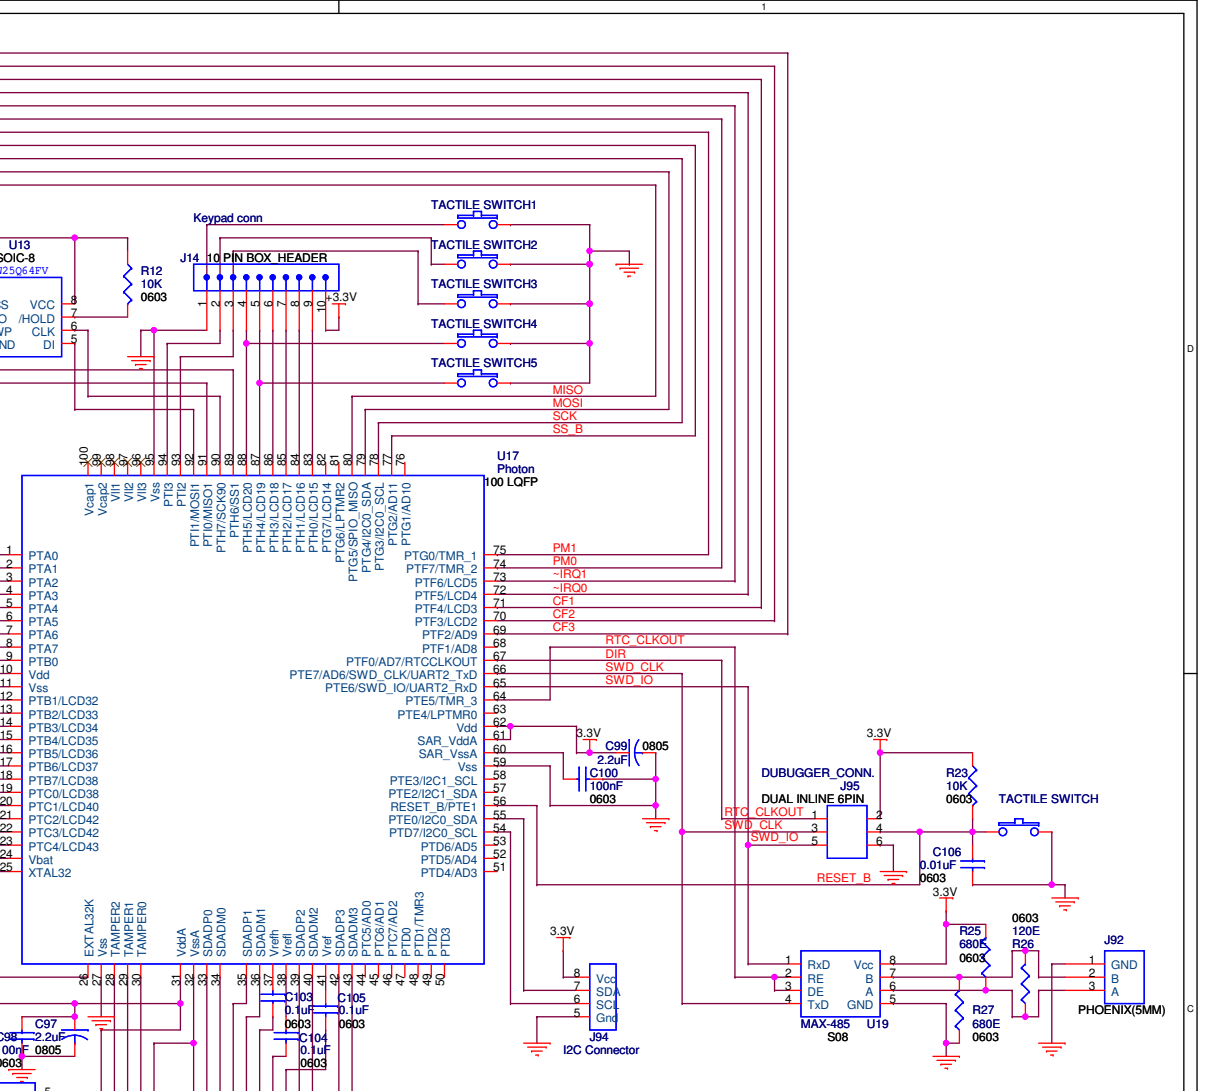
[picture p58: page 3]

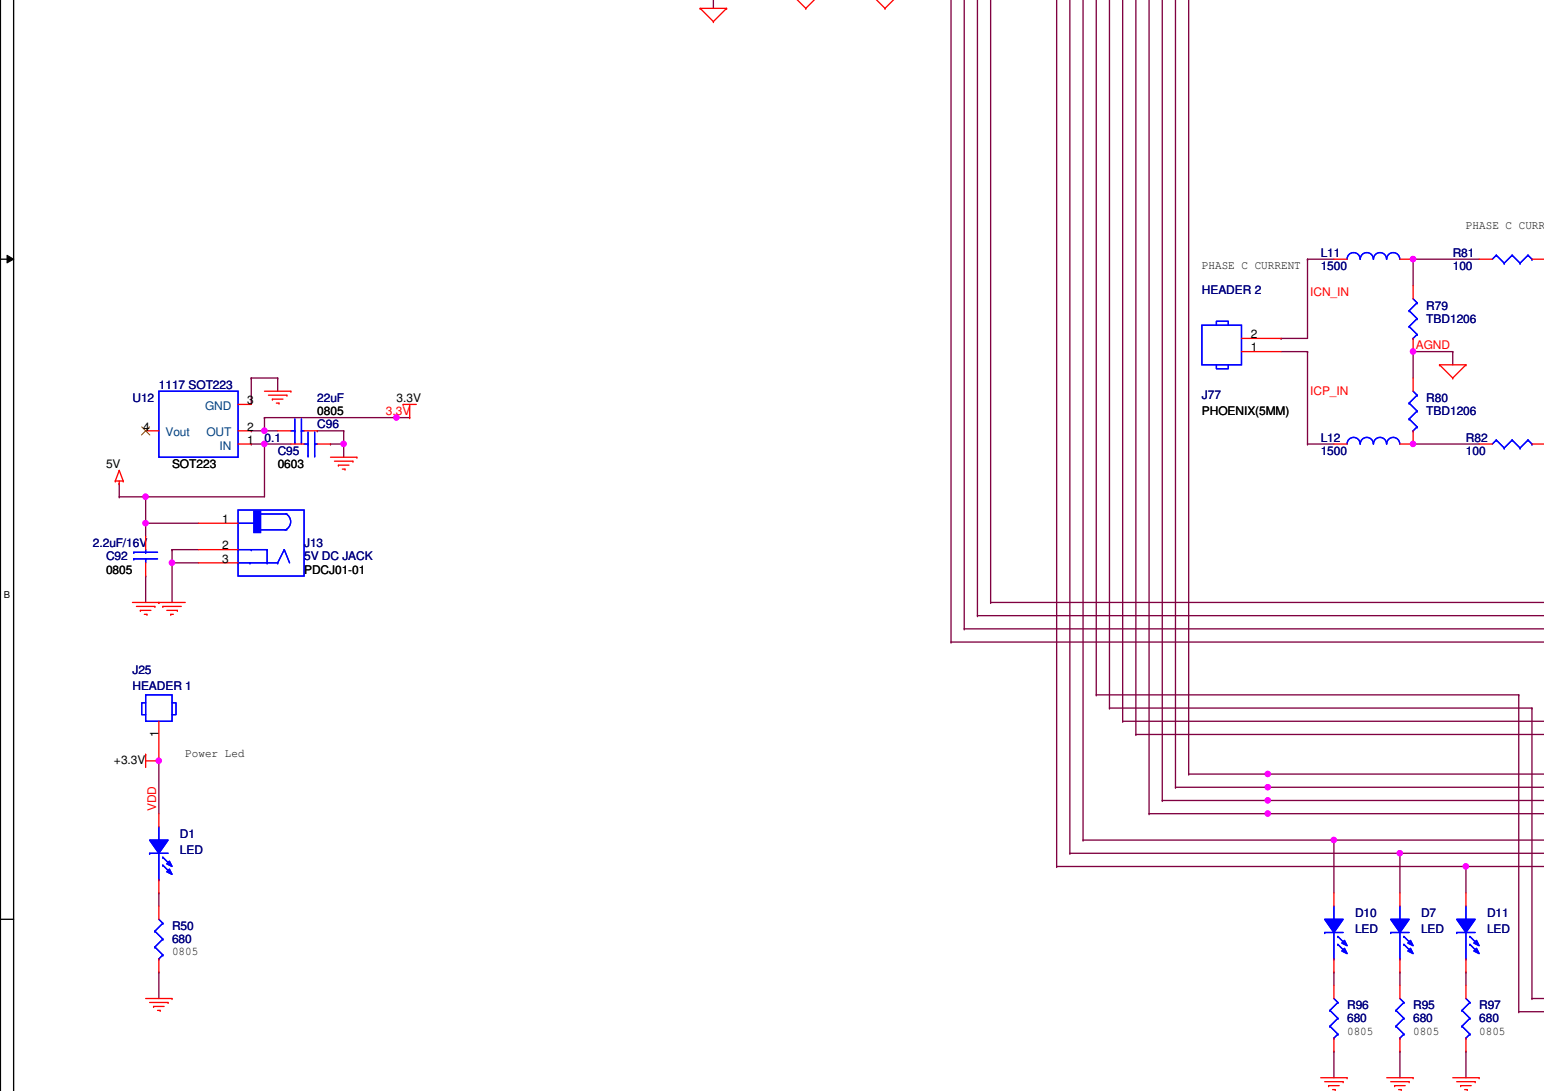
[picture p59: page 4]

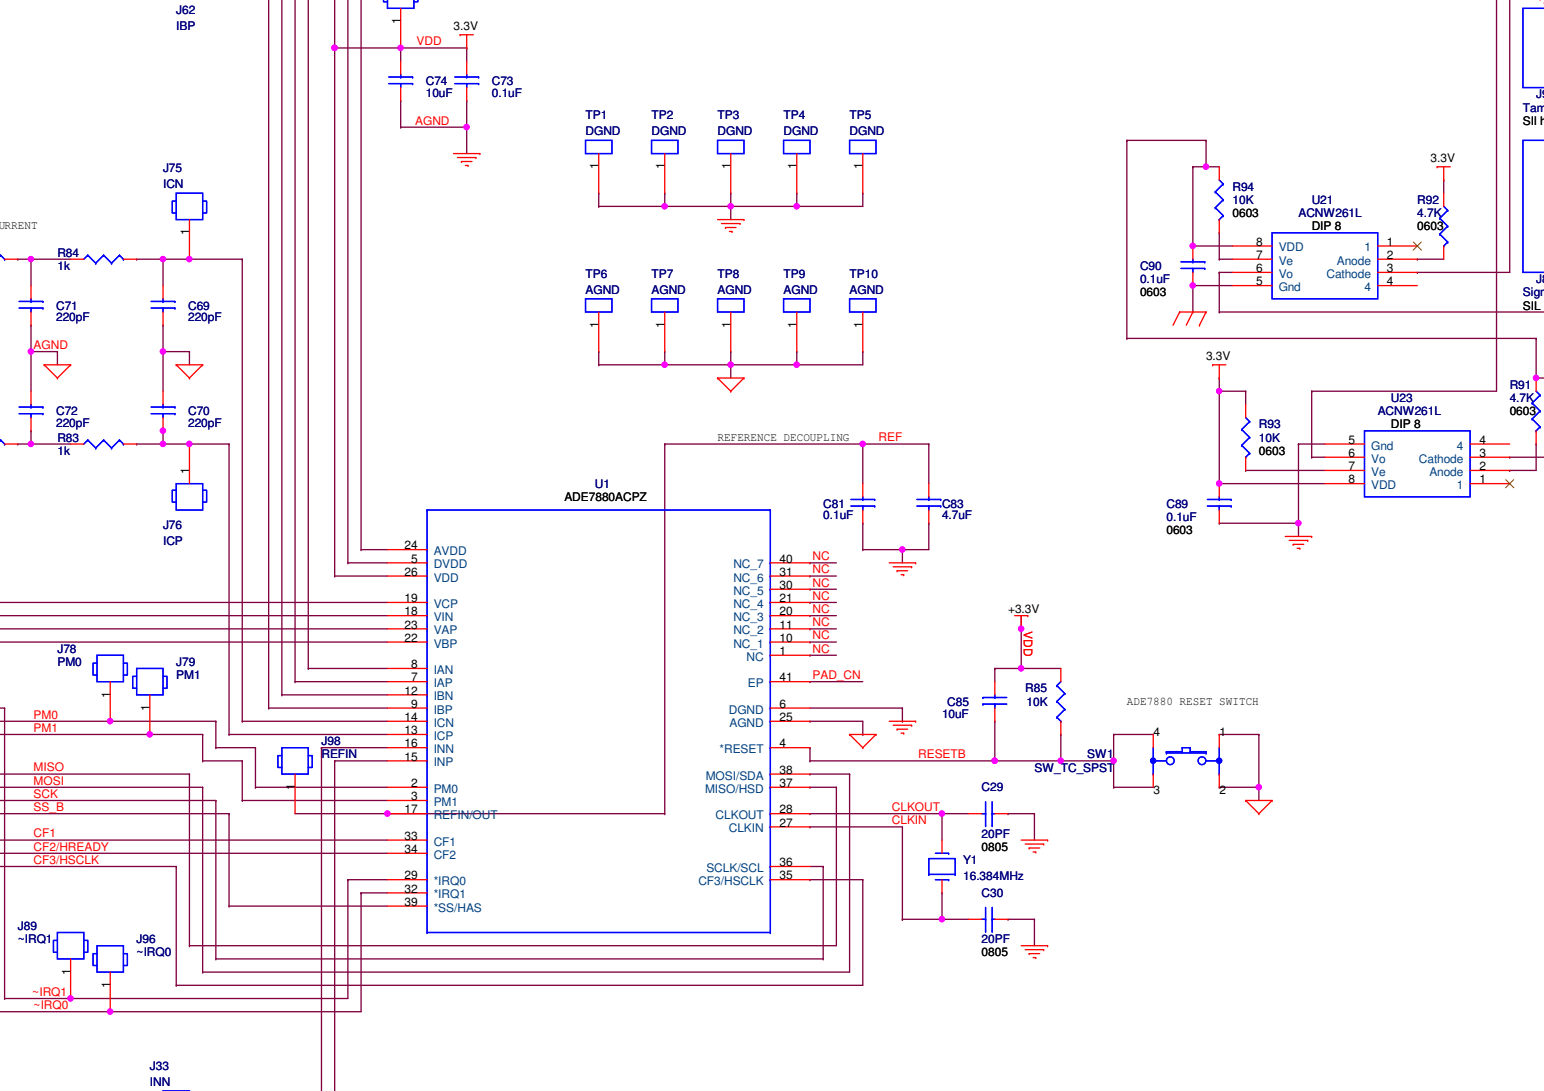
[picture p60: page 5]

CF2/HREADY | CF2 34
CF3/HSCLK | *IRQ0 29

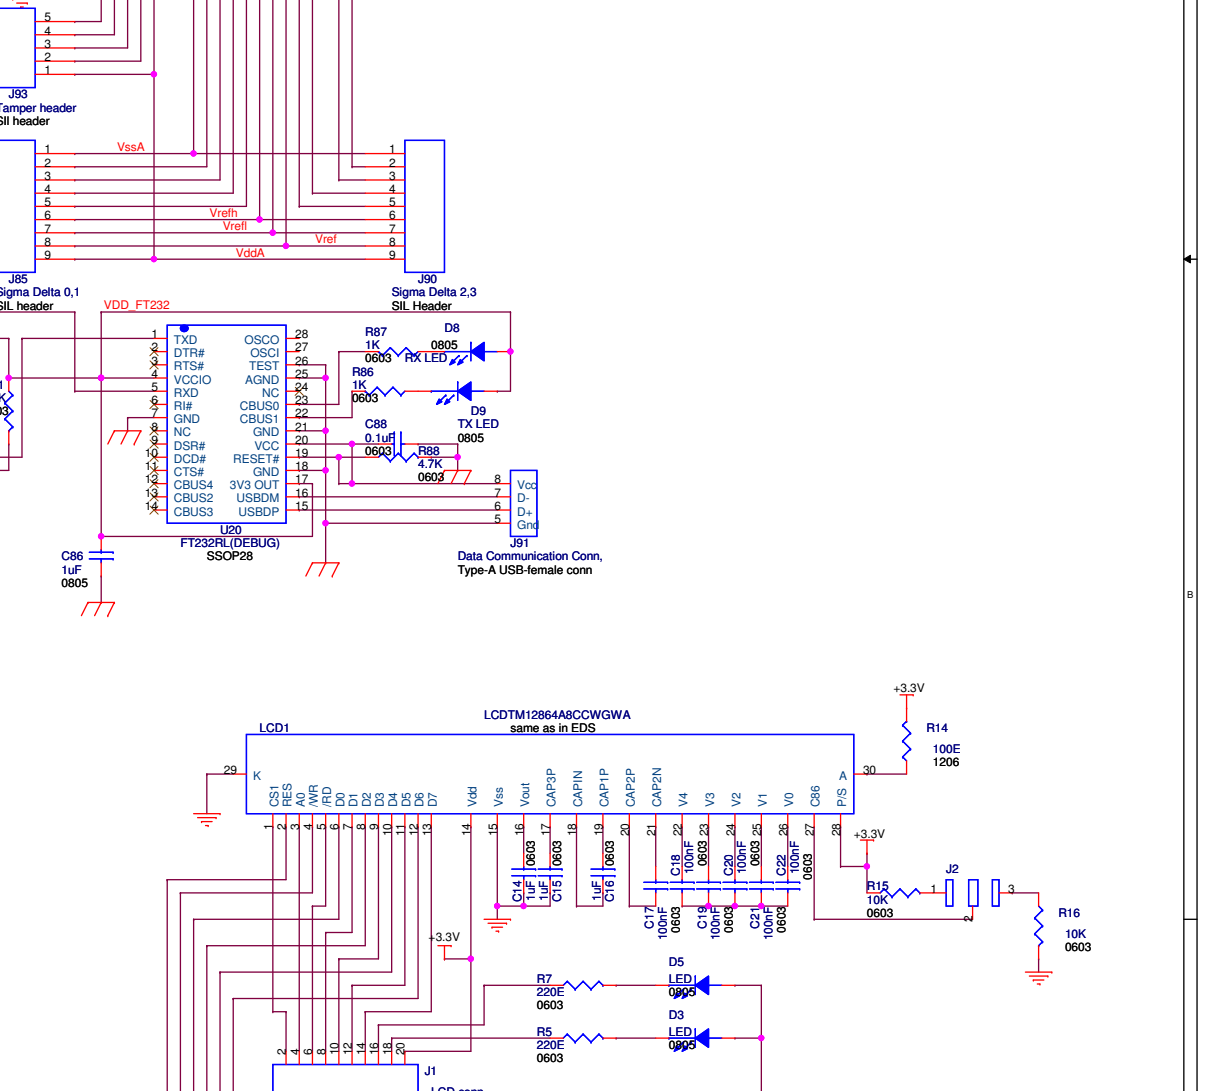
[picture p61: page 6]

Data Communication Conn,
Type-A USB-female conn

LCDTM12864A8CCWGWA
same as in EDS

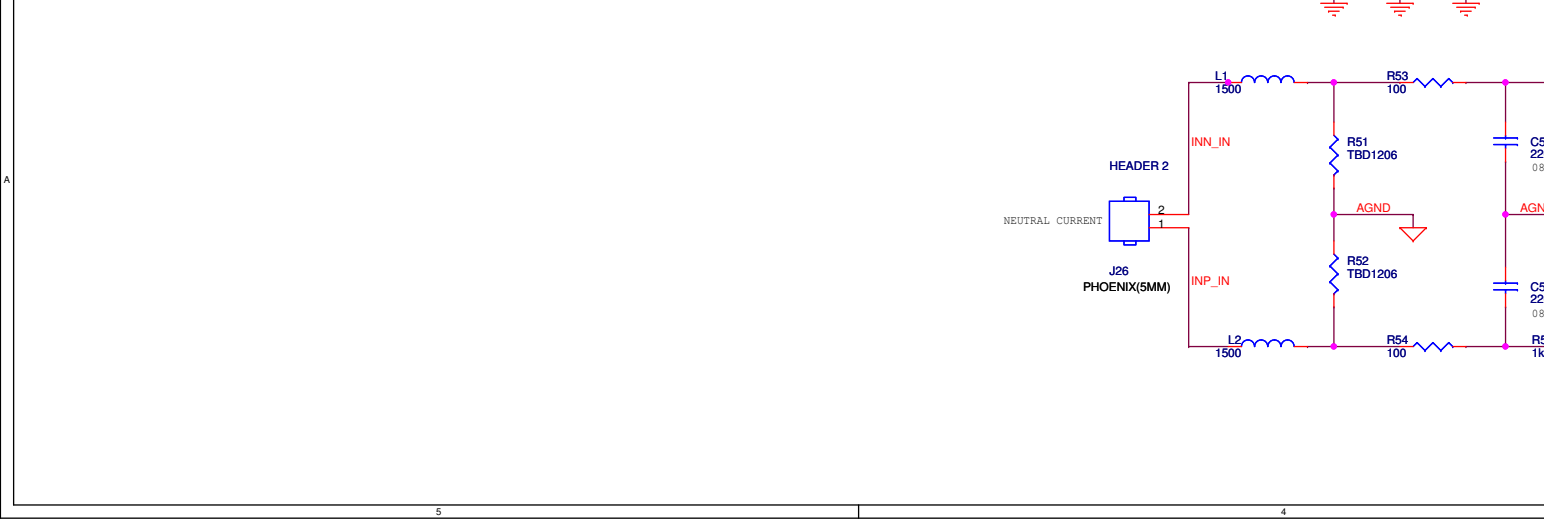
[picture p62: page 7]

3 | 2

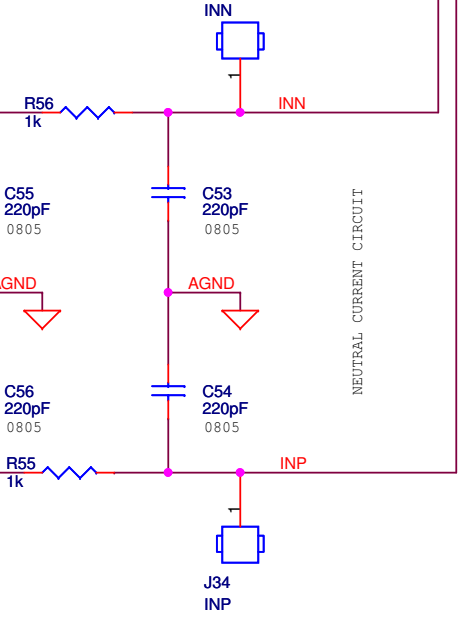
[picture p63: figure]
INP; AGND; INN; NEUTRAL CURRENT CIRCUIT 0805 0805; J34 INP
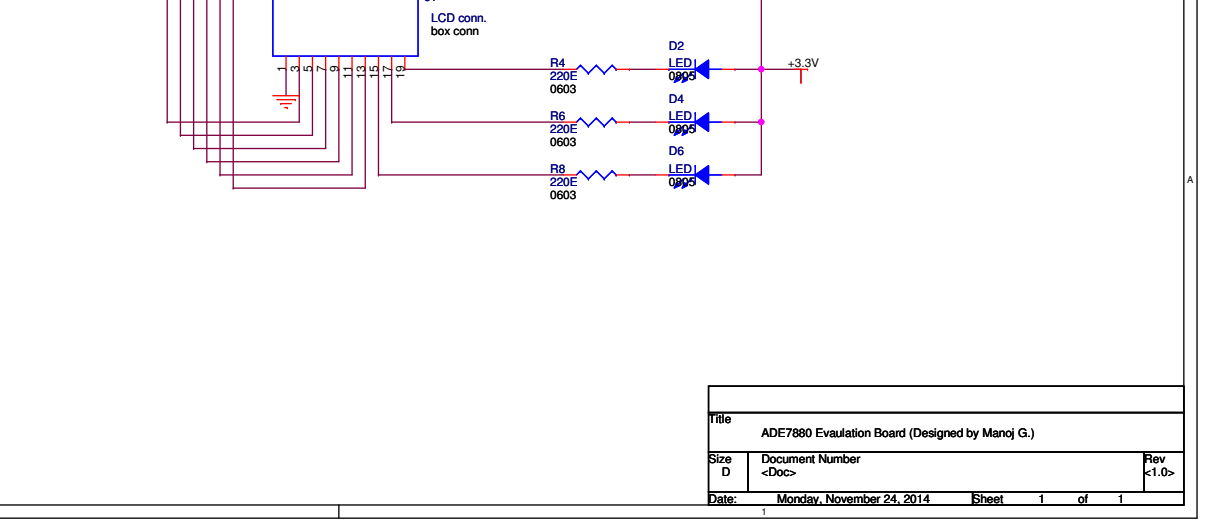
[picture p64: page 9]
Title; Size; Document Number; Rev; Date:; Sheet; <Doc>; Monday, November 24, 2014; LED 0805; LCD conn. box conn; LED

ADE7880 Evaulation Board (Designed by Manoj G.)
