manojgulati/Harmonic-Analyser/Harmonic Analyser/Orcad_Capture_SESDP/ver2.15/HA_SCHEMATIC_ver2.14.pdf

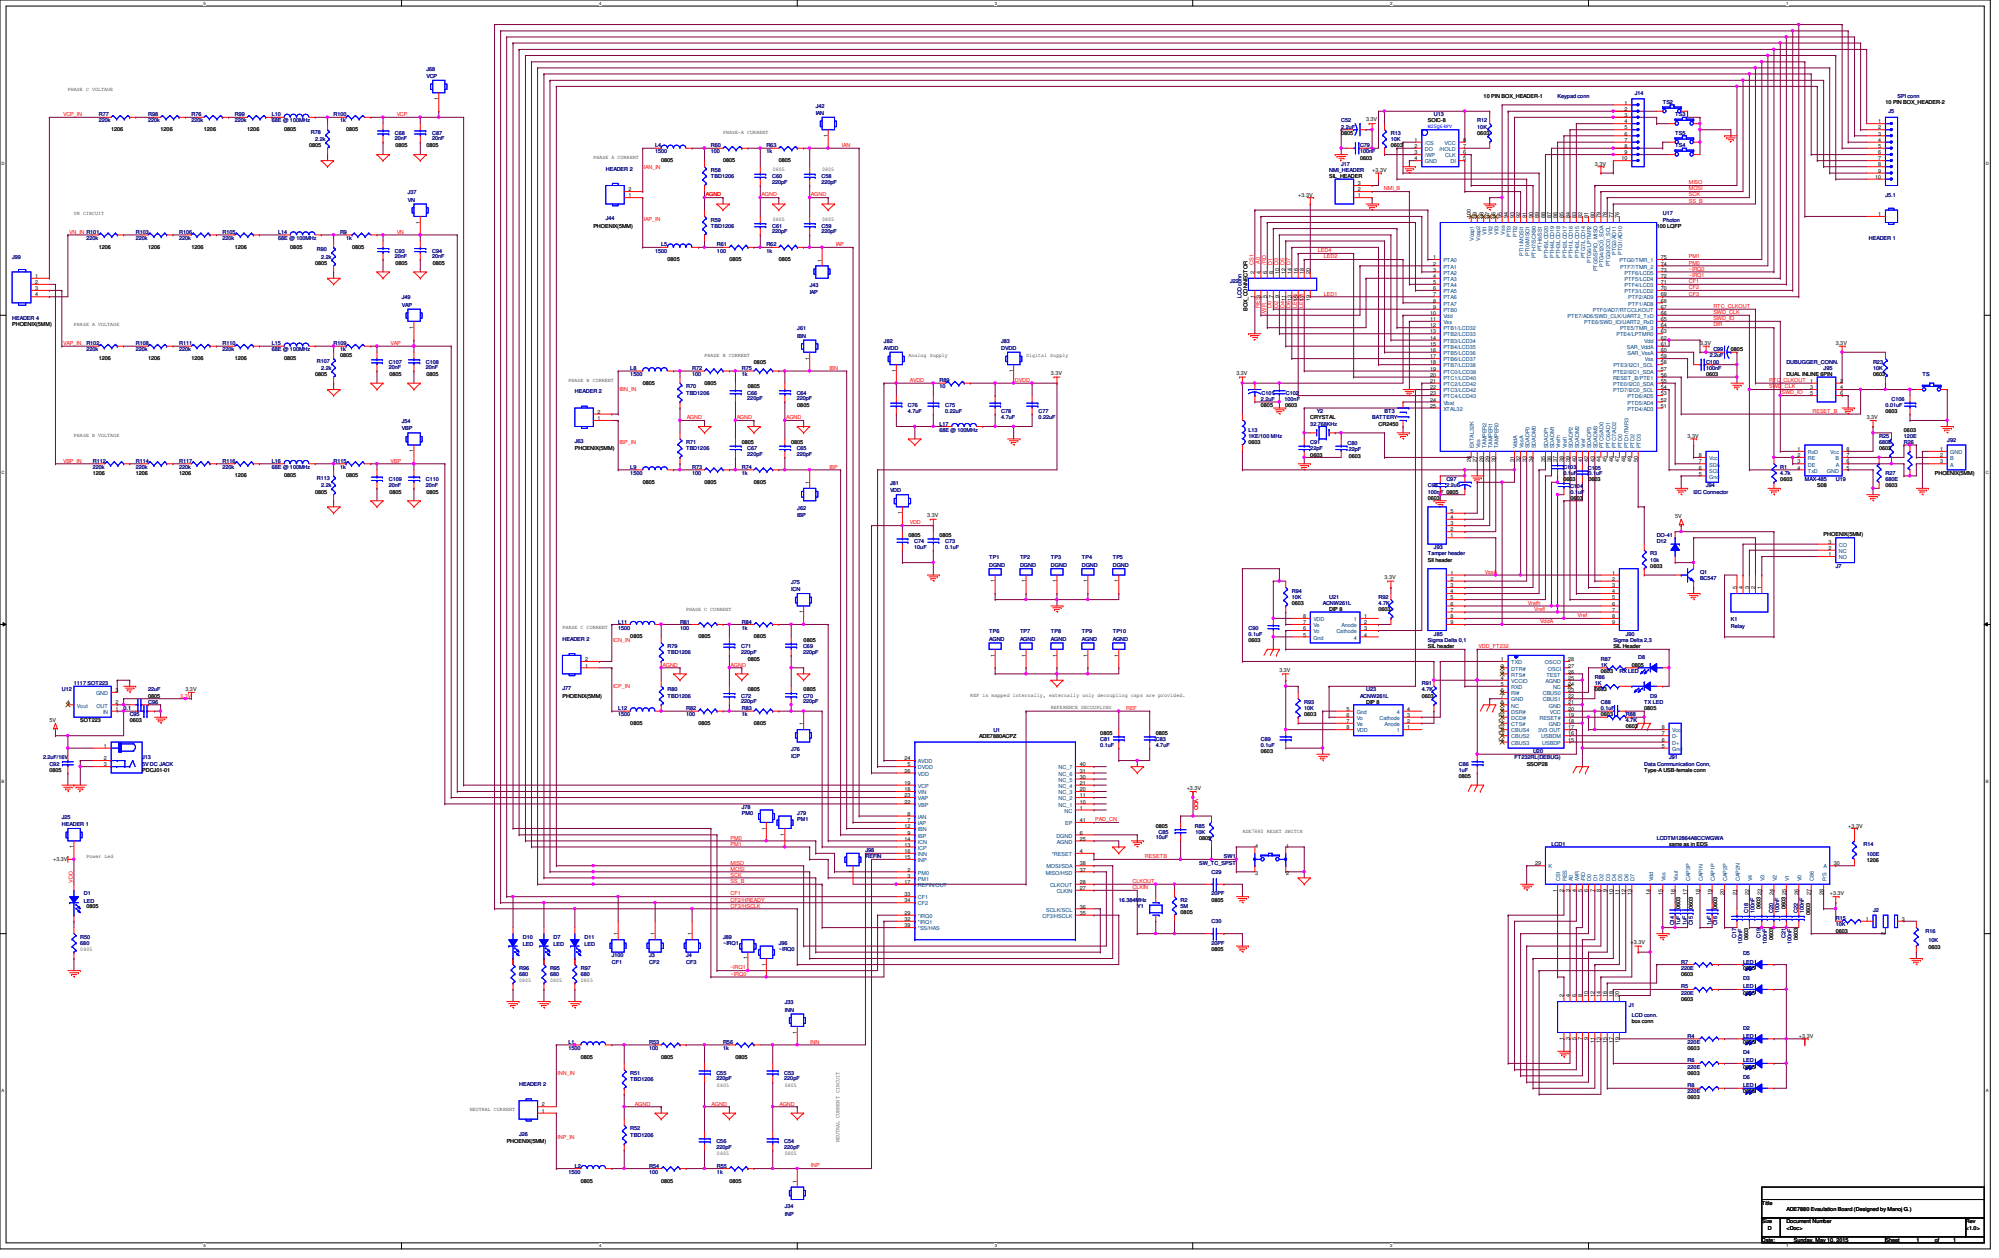
[picture p65: page 1]

REF is mapped internally, externally only decoupling caps are provided.

Data Communication Conn,
Type-A USB-female conn

VIN 18 VCP 19 VBP 22 VAP 23

IAP 7 IAN 8 | PAD_CN R85 10K

PM1 | J98 | ICP 13 ICN 14 INP 15 INN 16

LCDTM12864A8CCWGWA
same as in EDS

MOSI SCK | PM1 3

CF2/HREADY CF3/HSCLK | CF2 34 *IRQ0 29

ADE7880 Evaulation Board (Designed by Manoj G.)
