manojgulati/Harmonic-Analyser/Harmonic Analyser/Orcad_Capture_SESDP/SCH/Manoj_SCHEMATIC1_PAGE1.pdf

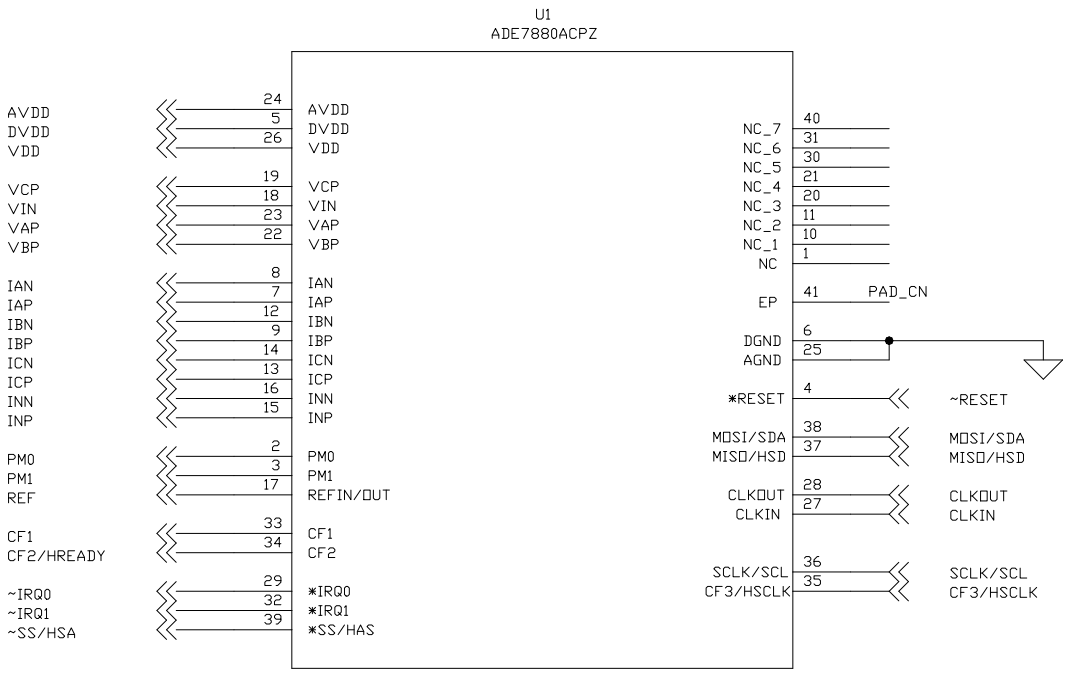
[picture p66: page 1]
