manojgulati/Harmonic-Analyser/Harmonic Analyser/Orcad_Capture_SESDP/SCH/Manoj_SCHEMATIC1_PAGE10.pdf

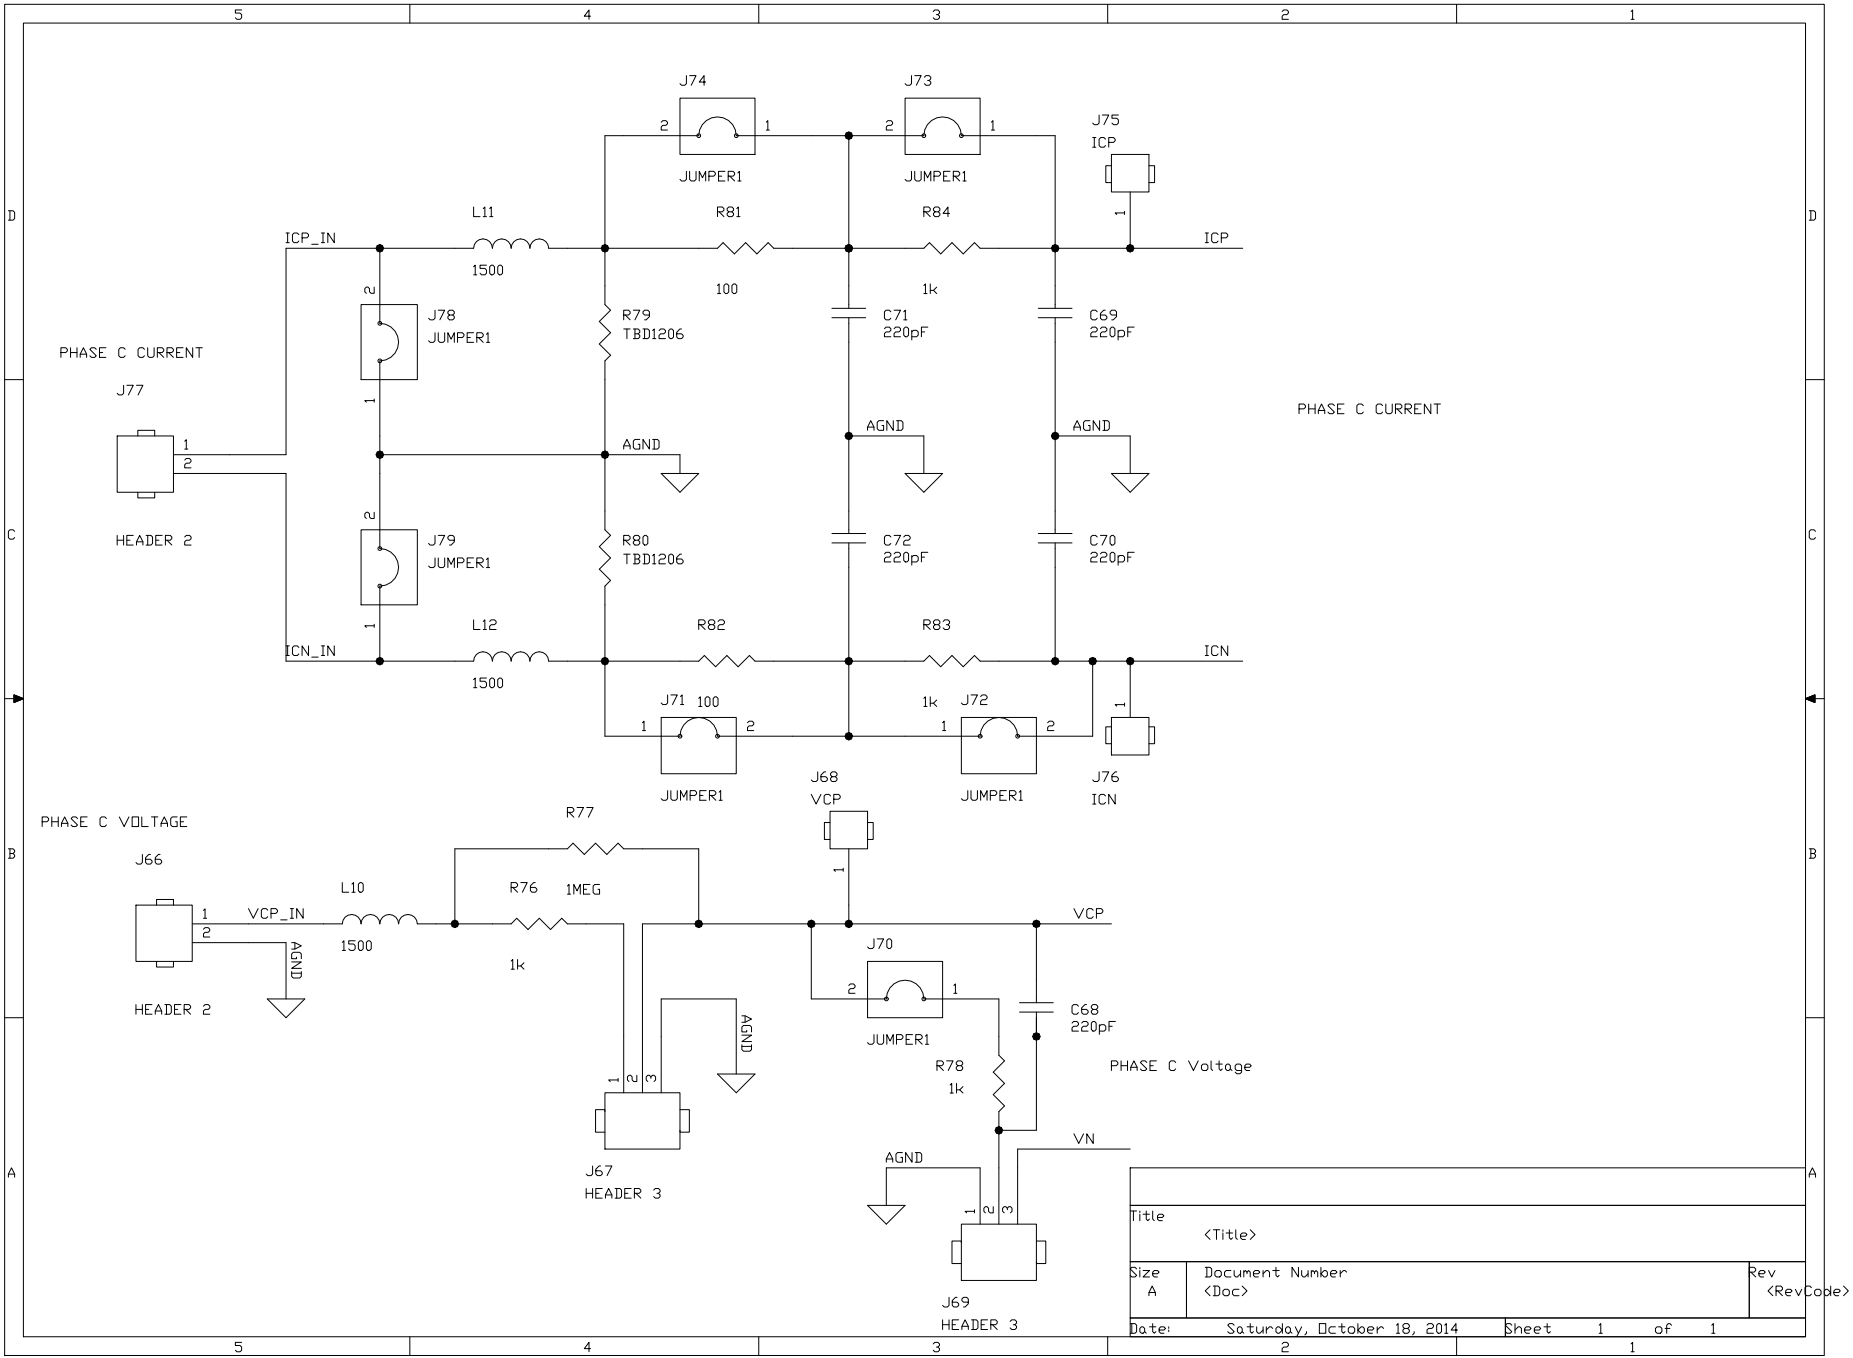
[picture p67: page 1]
