manojgulati/Harmonic-Analyser/Harmonic Analyser/Orcad_Capture_SESDP/SCH/Manoj_SCHEMATIC1_PAGE11.pdf

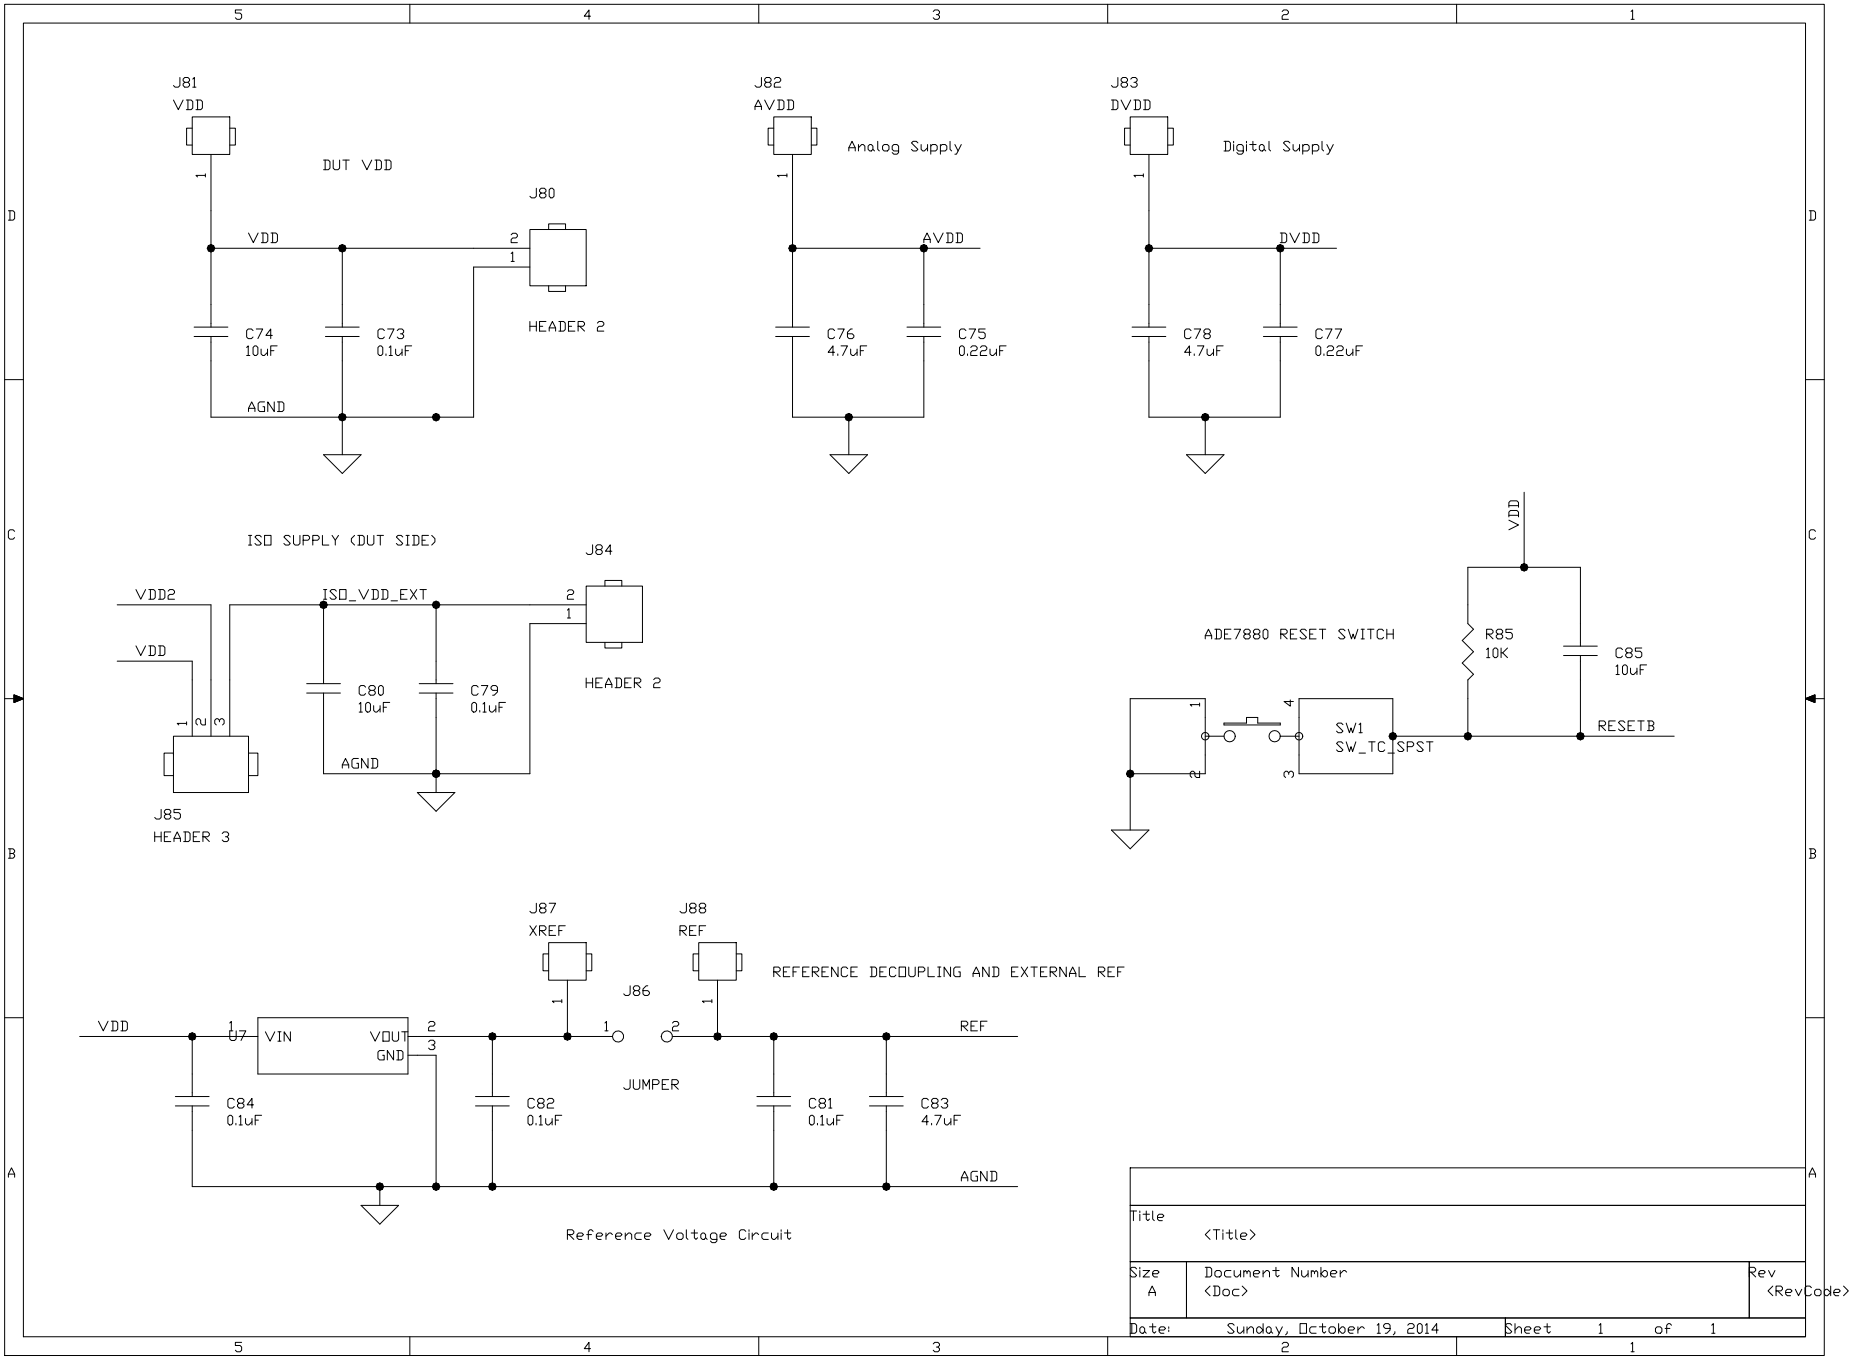
[picture p68: page 1]
