manojgulati/Harmonic-Analyser/Harmonic Analyser/Orcad_Capture_SESDP/SCH/Manoj_SCHEMATIC1_PAGE2.pdf

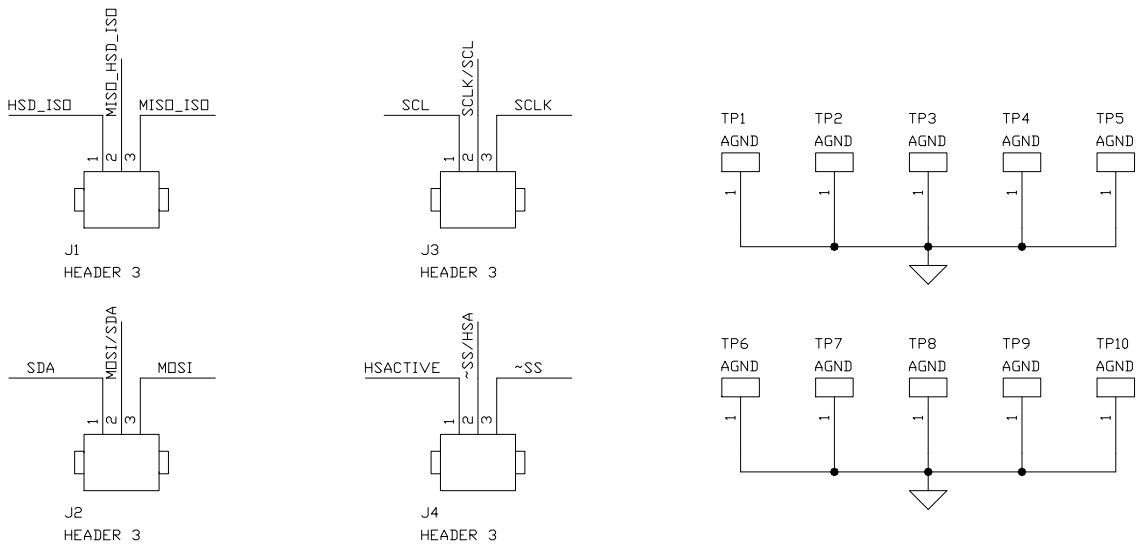
[picture p69: page 1]
