manojgulati/Harmonic-Analyser/Harmonic Analyser/Orcad_Capture_SESDP/SCH/Manoj_SCHEMATIC1_PAGE3.pdf

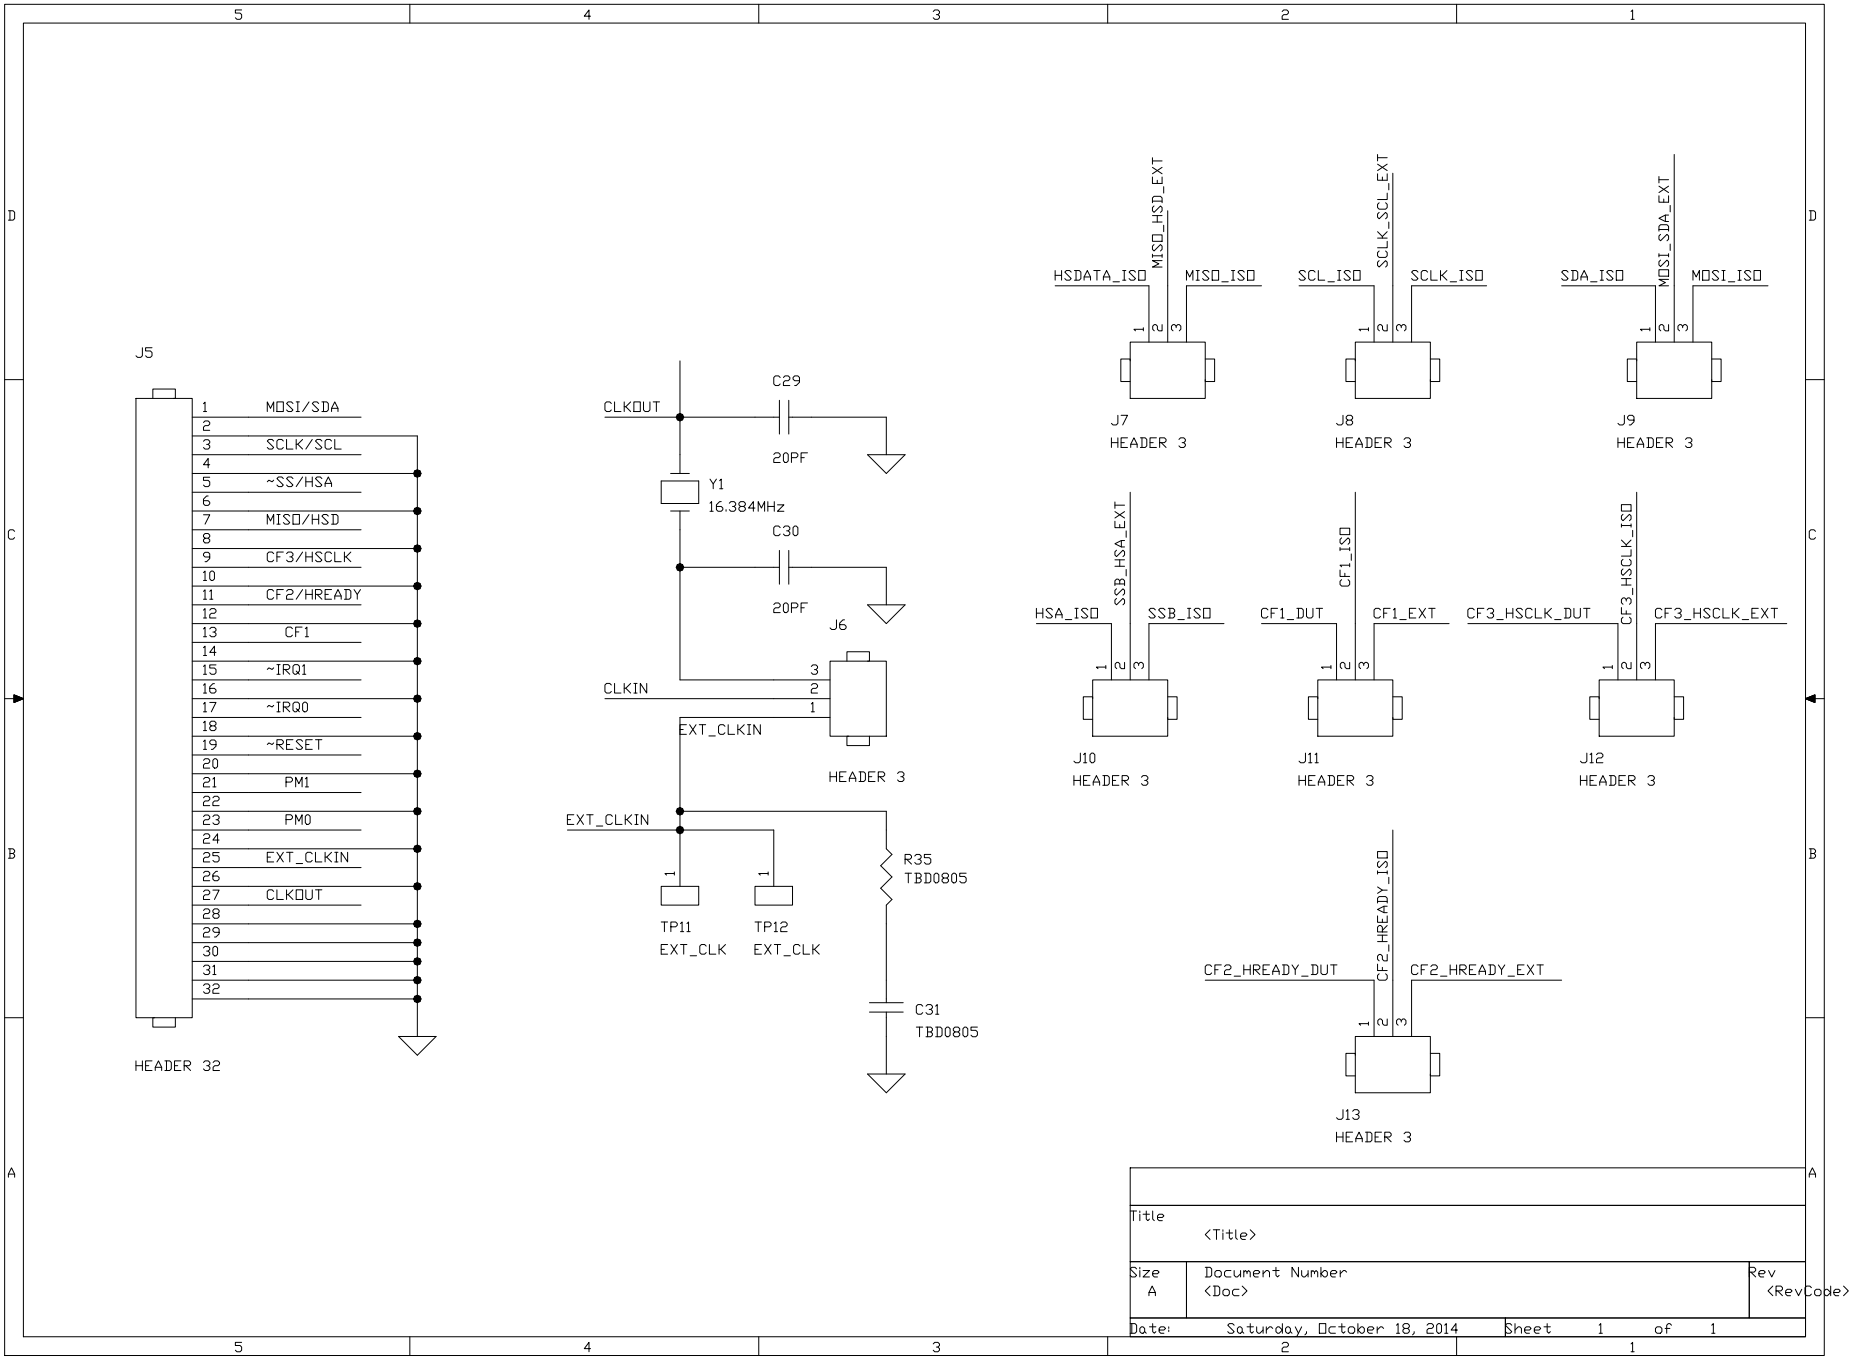
[picture p70: page 1]
