manojgulati/Harmonic-Analyser/Harmonic Analyser/Orcad_Capture_SESDP/ver2.15/HARMONICS ANALYSER.pdf

J91J91x4 J91x3 J91x2 J91x1J91x6 | J91x5

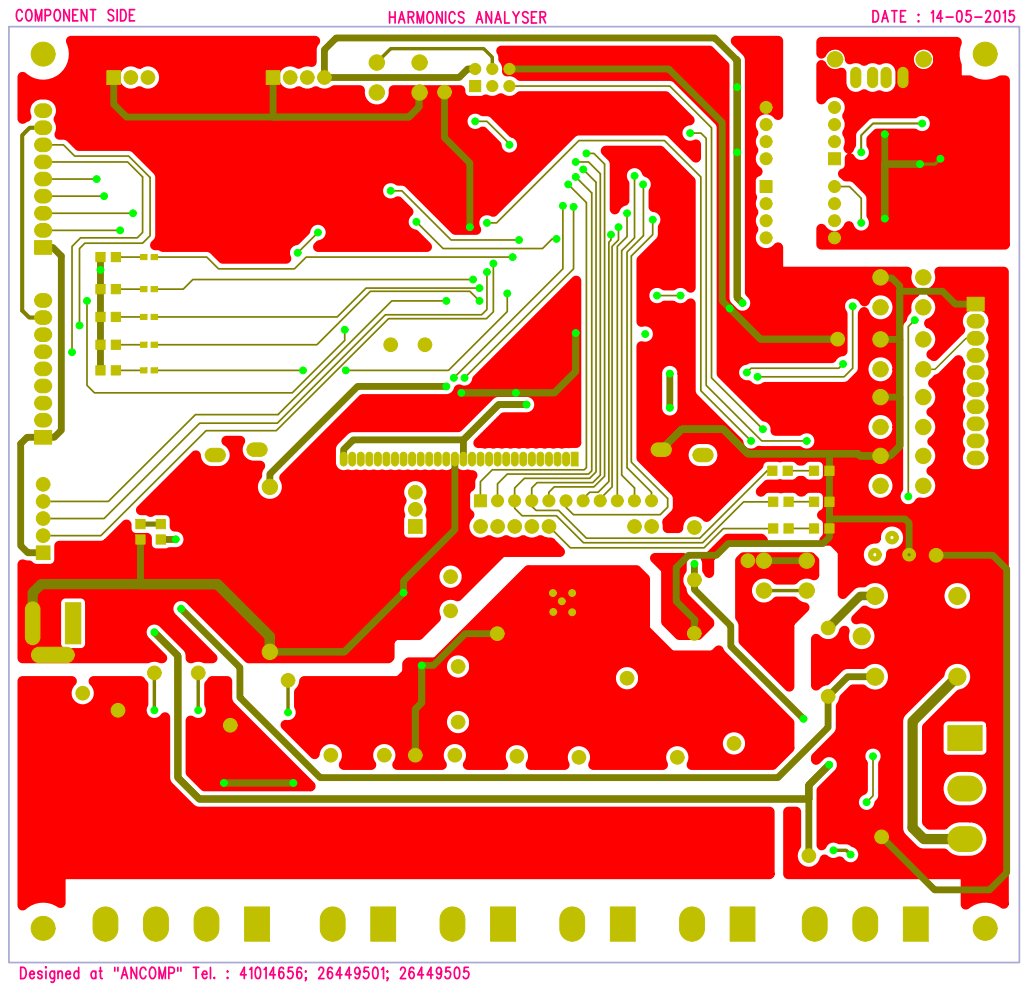
[picture p77: page 1]
COMPONENT SIDE; HARMONICS ANALYSER; DATE : 14-05-2015; D1D¹x1 D¹x2; D10D¹⁰x1; D¹⁰x2; D11D¹¹x1; D¹¹x2; D2D²x2; D²x1; D3D³x2; D³x1; D4D⁴x2; D⁴x1; D5D⁵x2; D⁵x1; D6D⁶x2; D⁶x1; D7D⁷x1; D⁷x2; LCD1 LCD¹x28 LCD¹x27 LCD¹x26 LCD¹x25 LCD¹x24 LCD¹x23 LCD¹x22 LCD¹x21 LCD¹x20 LCD¹x19 LCD¹x18 LCD¹x17 LCD¹x16 LCD¹x15 LCD¹x14 LCD¹x13 LCD¹x12 LCD¹x11 LCD¹x10 LCD¹x9 LCD¹x8 LCD¹x7 LCD¹x6 LCD¹x5 LCD¹x4 LCD¹x3 LCD¹x2 LCD¹x1LCD¹x30; LCD¹x29 LCD¹x32; LCD1x31; R4R⁴x2; R⁴x1; R5R⁵x2; R⁵x1; R50R⁵⁰x1 R⁵⁰x2 R6R⁶x2; R⁶x1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

Designed at "ANCOMP" Tel. : 41014656; 26449501; 26449505

J91J91x4 J91x3 J91x2 J91x1J91x6 | J91x5

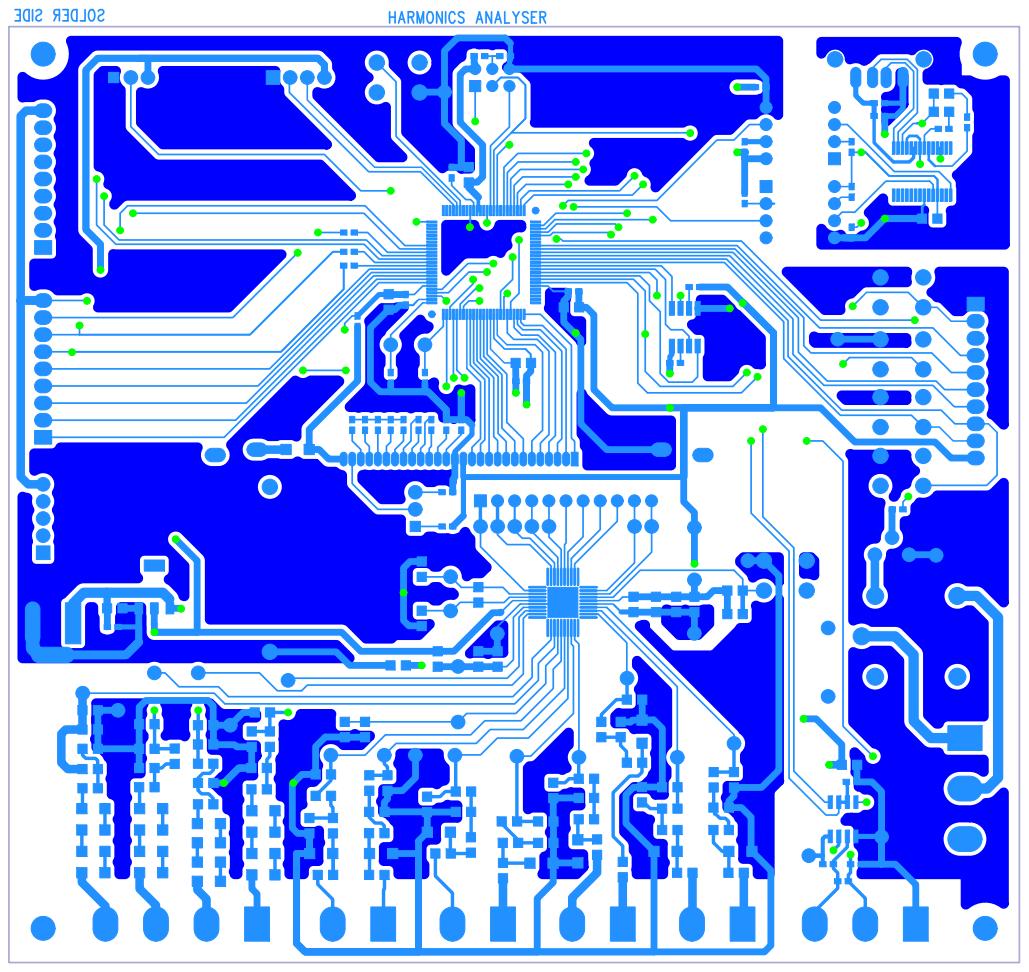
[picture p78: page 2]

J91J91x4 J91x3 J91x2 J91x1J91x6 | J91x5
J91J91x4 J91x3 J91x2 J91x1J91x6 | J91x5

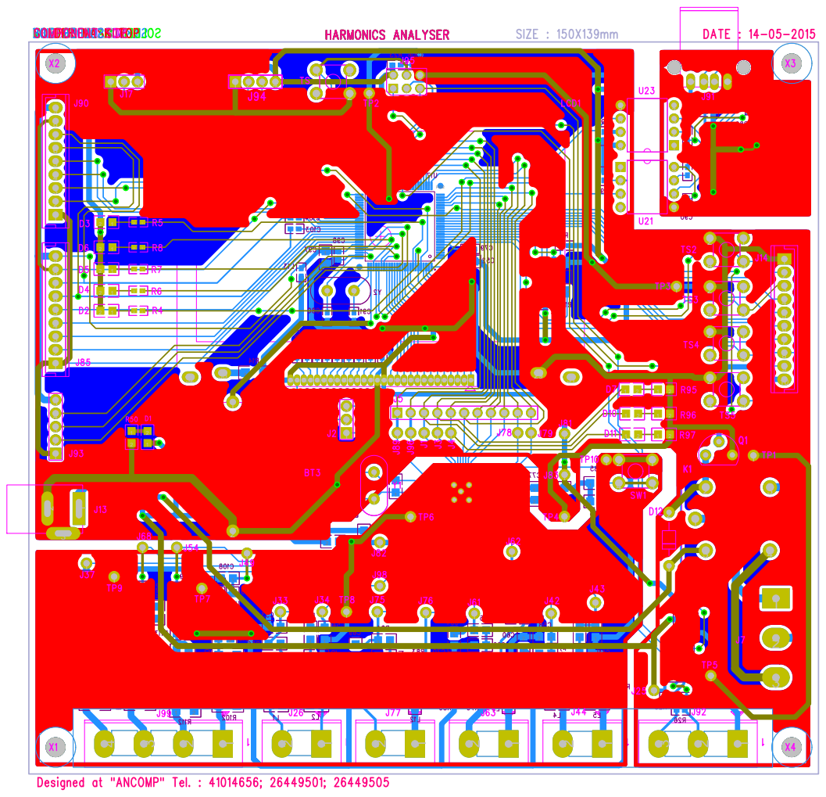
[picture p79: page 3]

Designed at "ANCOMP" Tel. : 41014656; 26449501; 26449505

J91

J91J91x4 J91x3 J91x2 J91x1J91x6 | J91x5

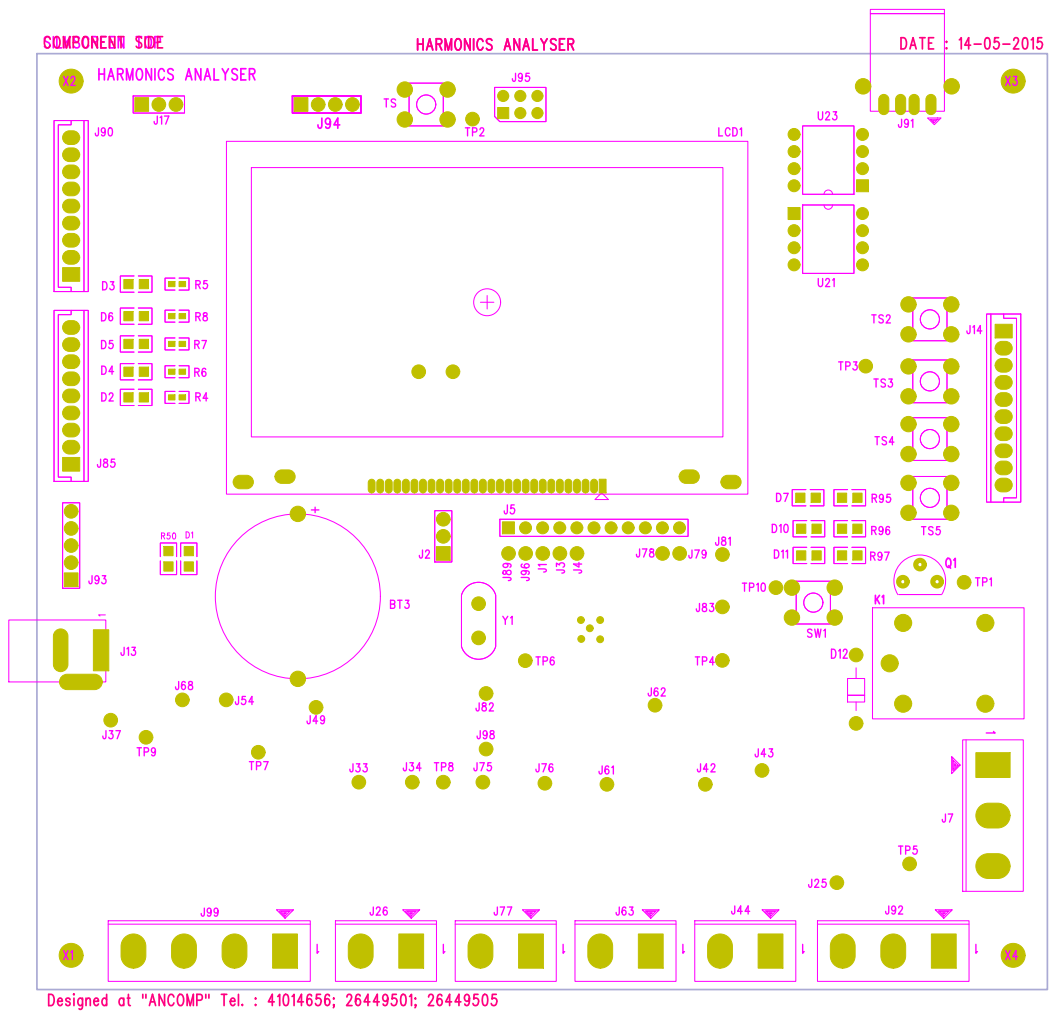
[picture p80: page 4]

Designed at "ANCOMP" Tel. : 41014656; 26449501; 26449505

J91J91x4 J91x3 J91x2 J91x1J91x6 | J91x5

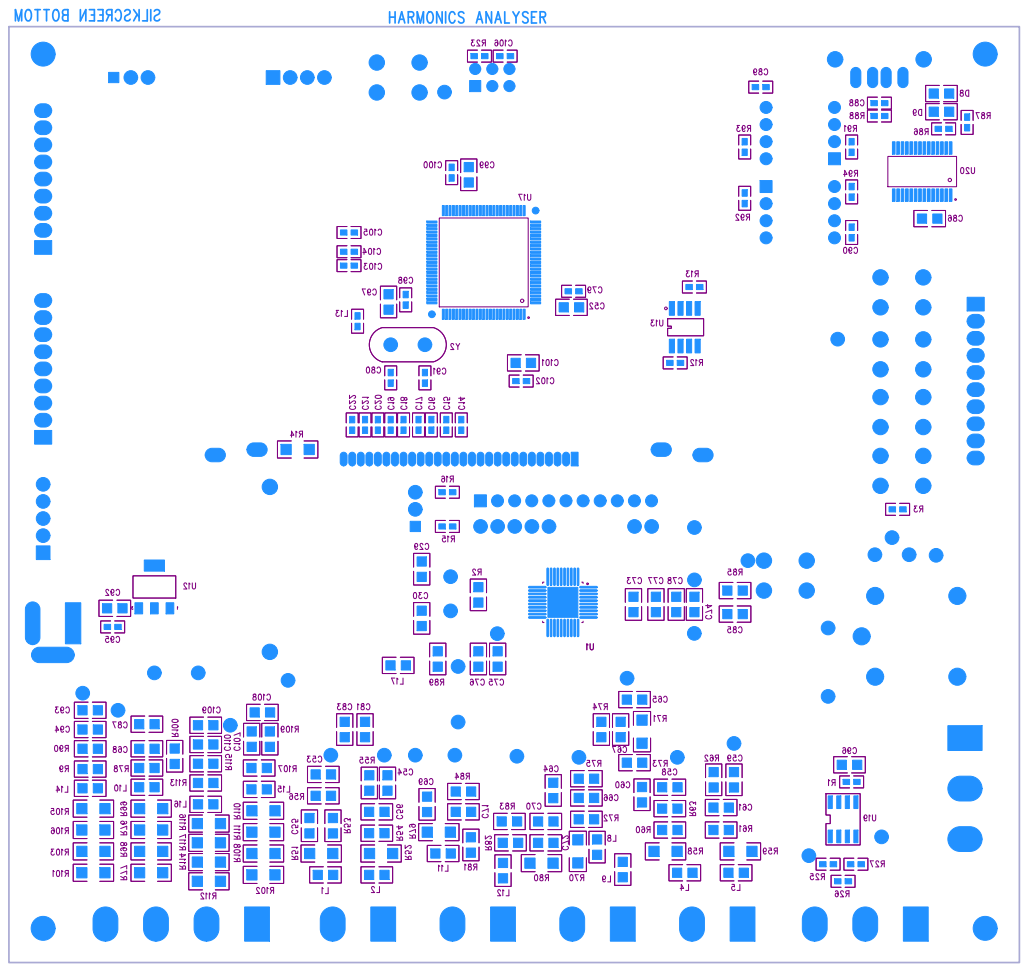
[picture p81: page 5]
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
