manojgulati/Harmonic-Analyser/Harmonic Analyser/Orcad_Capture_SESDP/ver2.5/Full_SCHEMATIC.pdf

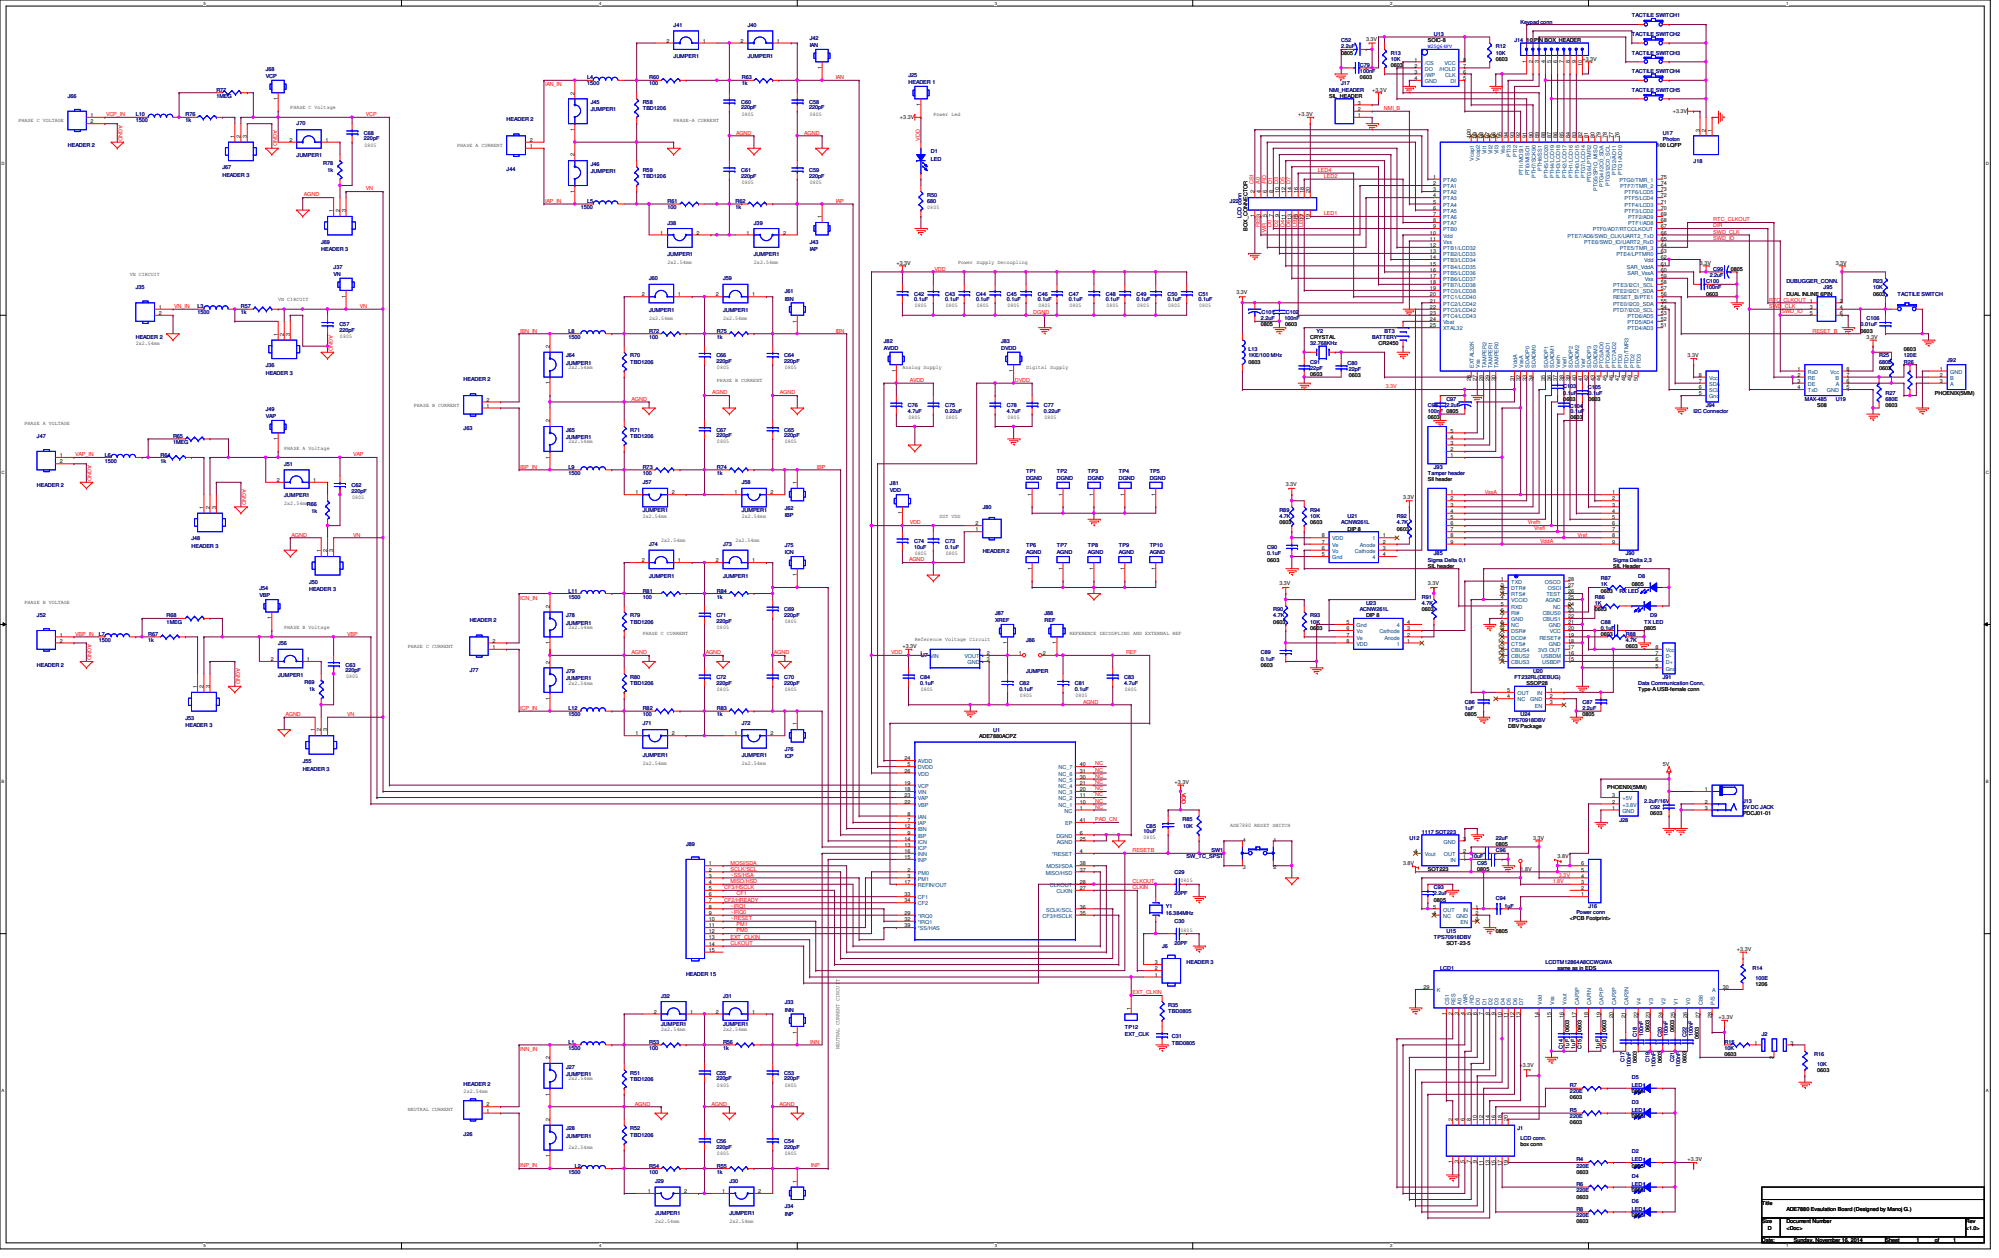
[picture p82: page 1]

LED4

C74 C73 10uF 0.1uF | Vrefh Vrefl | 6 Vref 8 7

REFERENCE DECOUPLING AND EXTERNAL REF

Data Communication Conn,
Type-A USB-female conn

5 | VDD 26 | NC

LCDTM12864A8CCWGWA
same as in EDS

ADE7880 Evaulation Board (Designed by Manoj G.)
