manojgulati/Harmonic-Analyser/Harmonic Analyser/Orcad_Capture_SESDP/ver2.7/Full_SCHEMATIC Ver 2.7.pdf

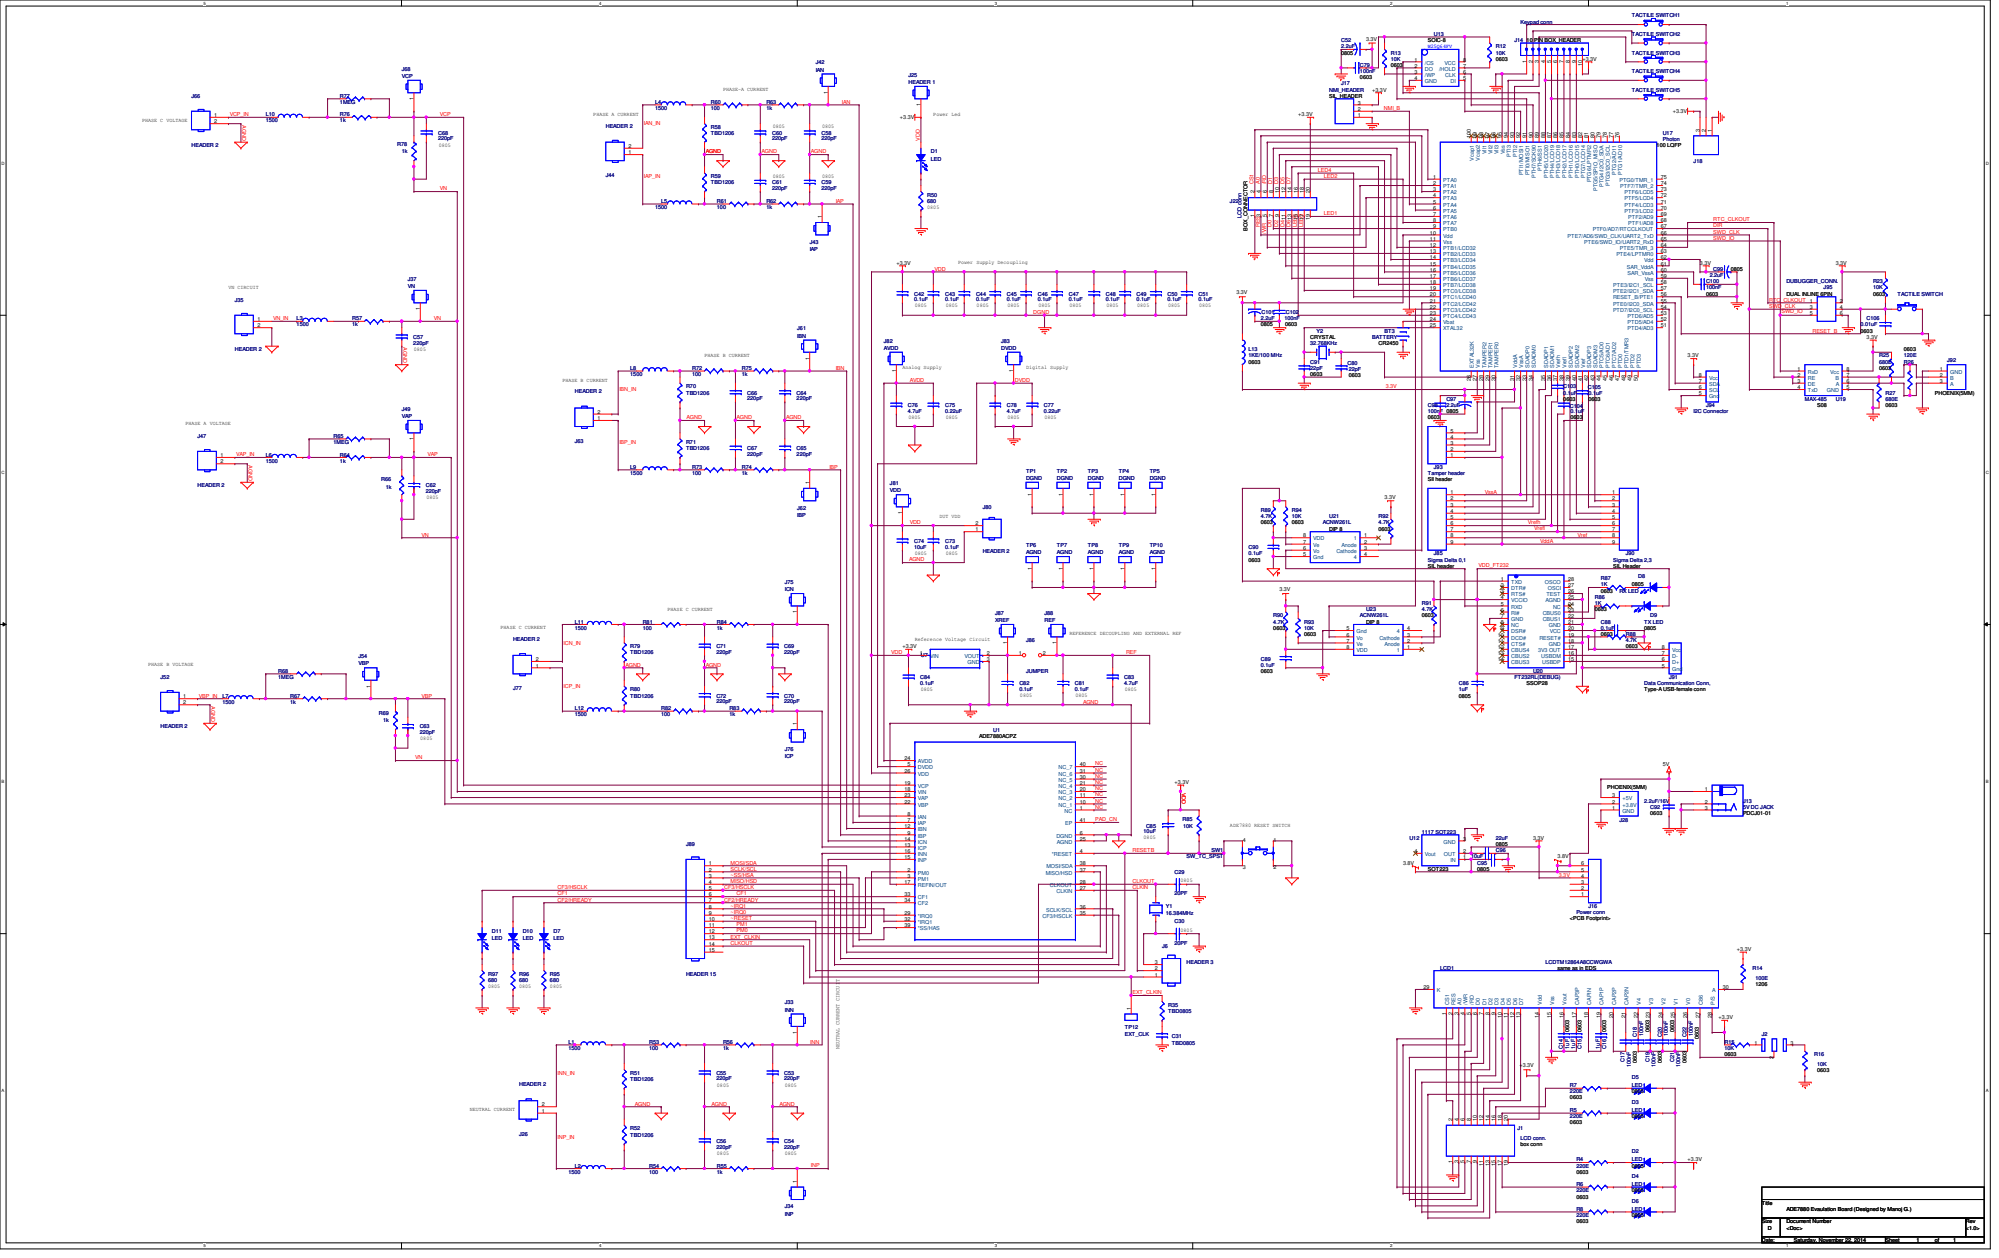
[picture p83: page 1]

LED2 LED1 | 3

SWD_IO | SWD_CLK

REFERENCE DECOUPLING AND EXTERNAL REF

Data Communication Conn,
Type-A USB-female conn

5 | VDD 26 | NC

CF2/HREADY CF2/HREADY 8 7 ~IRQ1 | CF2 34 *IRQ0 29

LCDTM12864A8CCWGWA
same as in EDS

ADE7880 Evaulation Board (Designed by Manoj G.)
