manojgulati/Harmonic-Analyser/Harmonic Analyser/Orcad_Capture_SESDP/ver2.8/Final Version 2.8.pdf

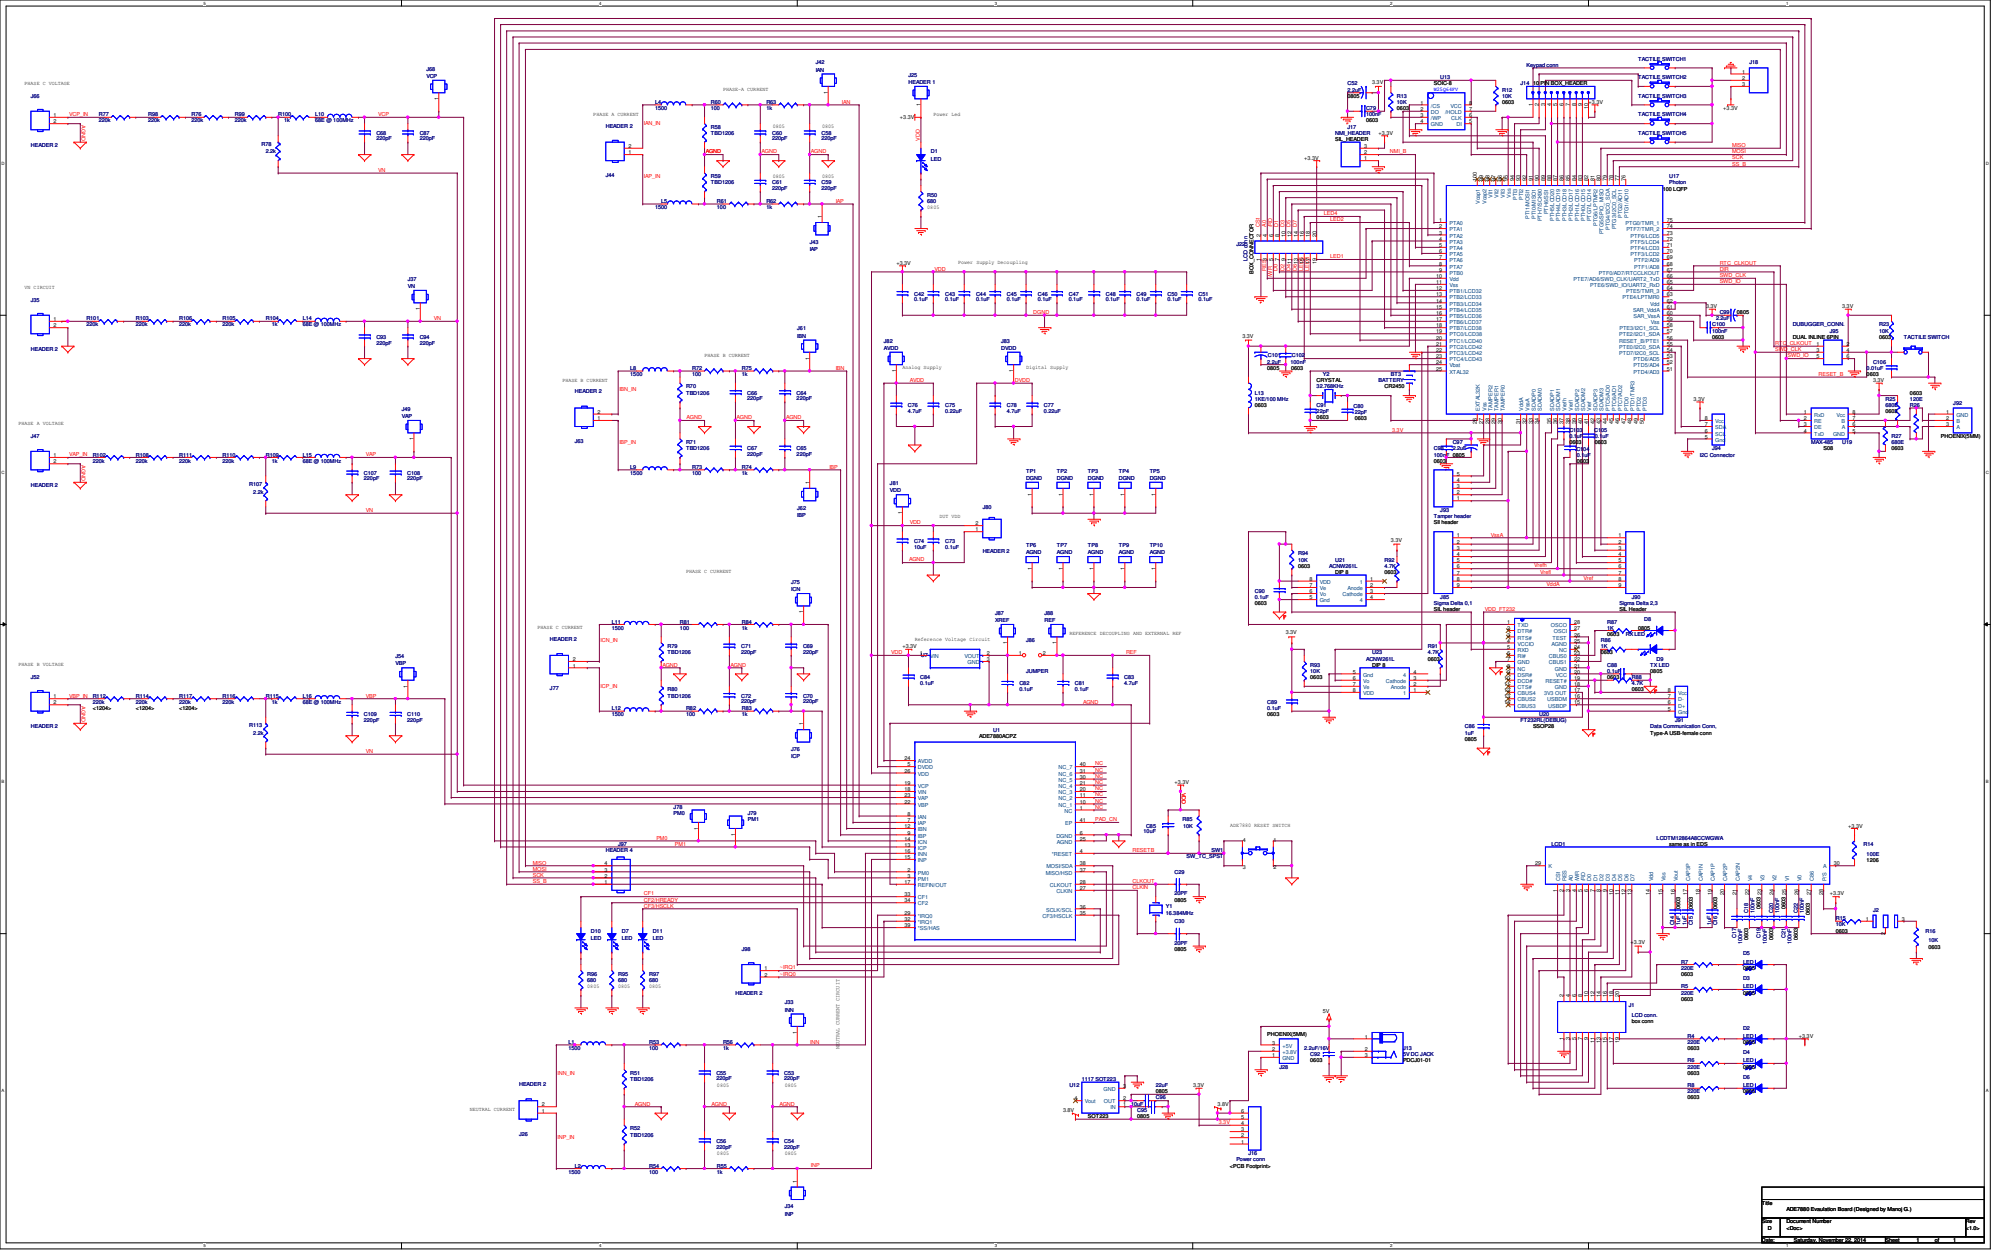
[picture p84: page 1]

REFERENCE DECOUPLING AND EXTERNAL REF

Data Communication Conn,
Type-A USB-female conn

5 | VDD 26 | NC

J97 PM1 HEADER 4 | ICP 13 ICN 14 INP 15 INN 16 | 4

LCDTM12864A8CCWGWA
same as in EDS

MOSI 3 SCK 2 | | 3

CF2/HREADY CF3/HSCLK R95 680 | CF2 34 *IRQ0 29

ADE7880 Evaulation Board (Designed by Manoj G.)
