manojgulati/Harmonic-Analyser/Harmonic Analyser/Orcad_Capture_SESDP/ver2.0/PAGE1_SCHEMATIC1_PAGE11.pdf

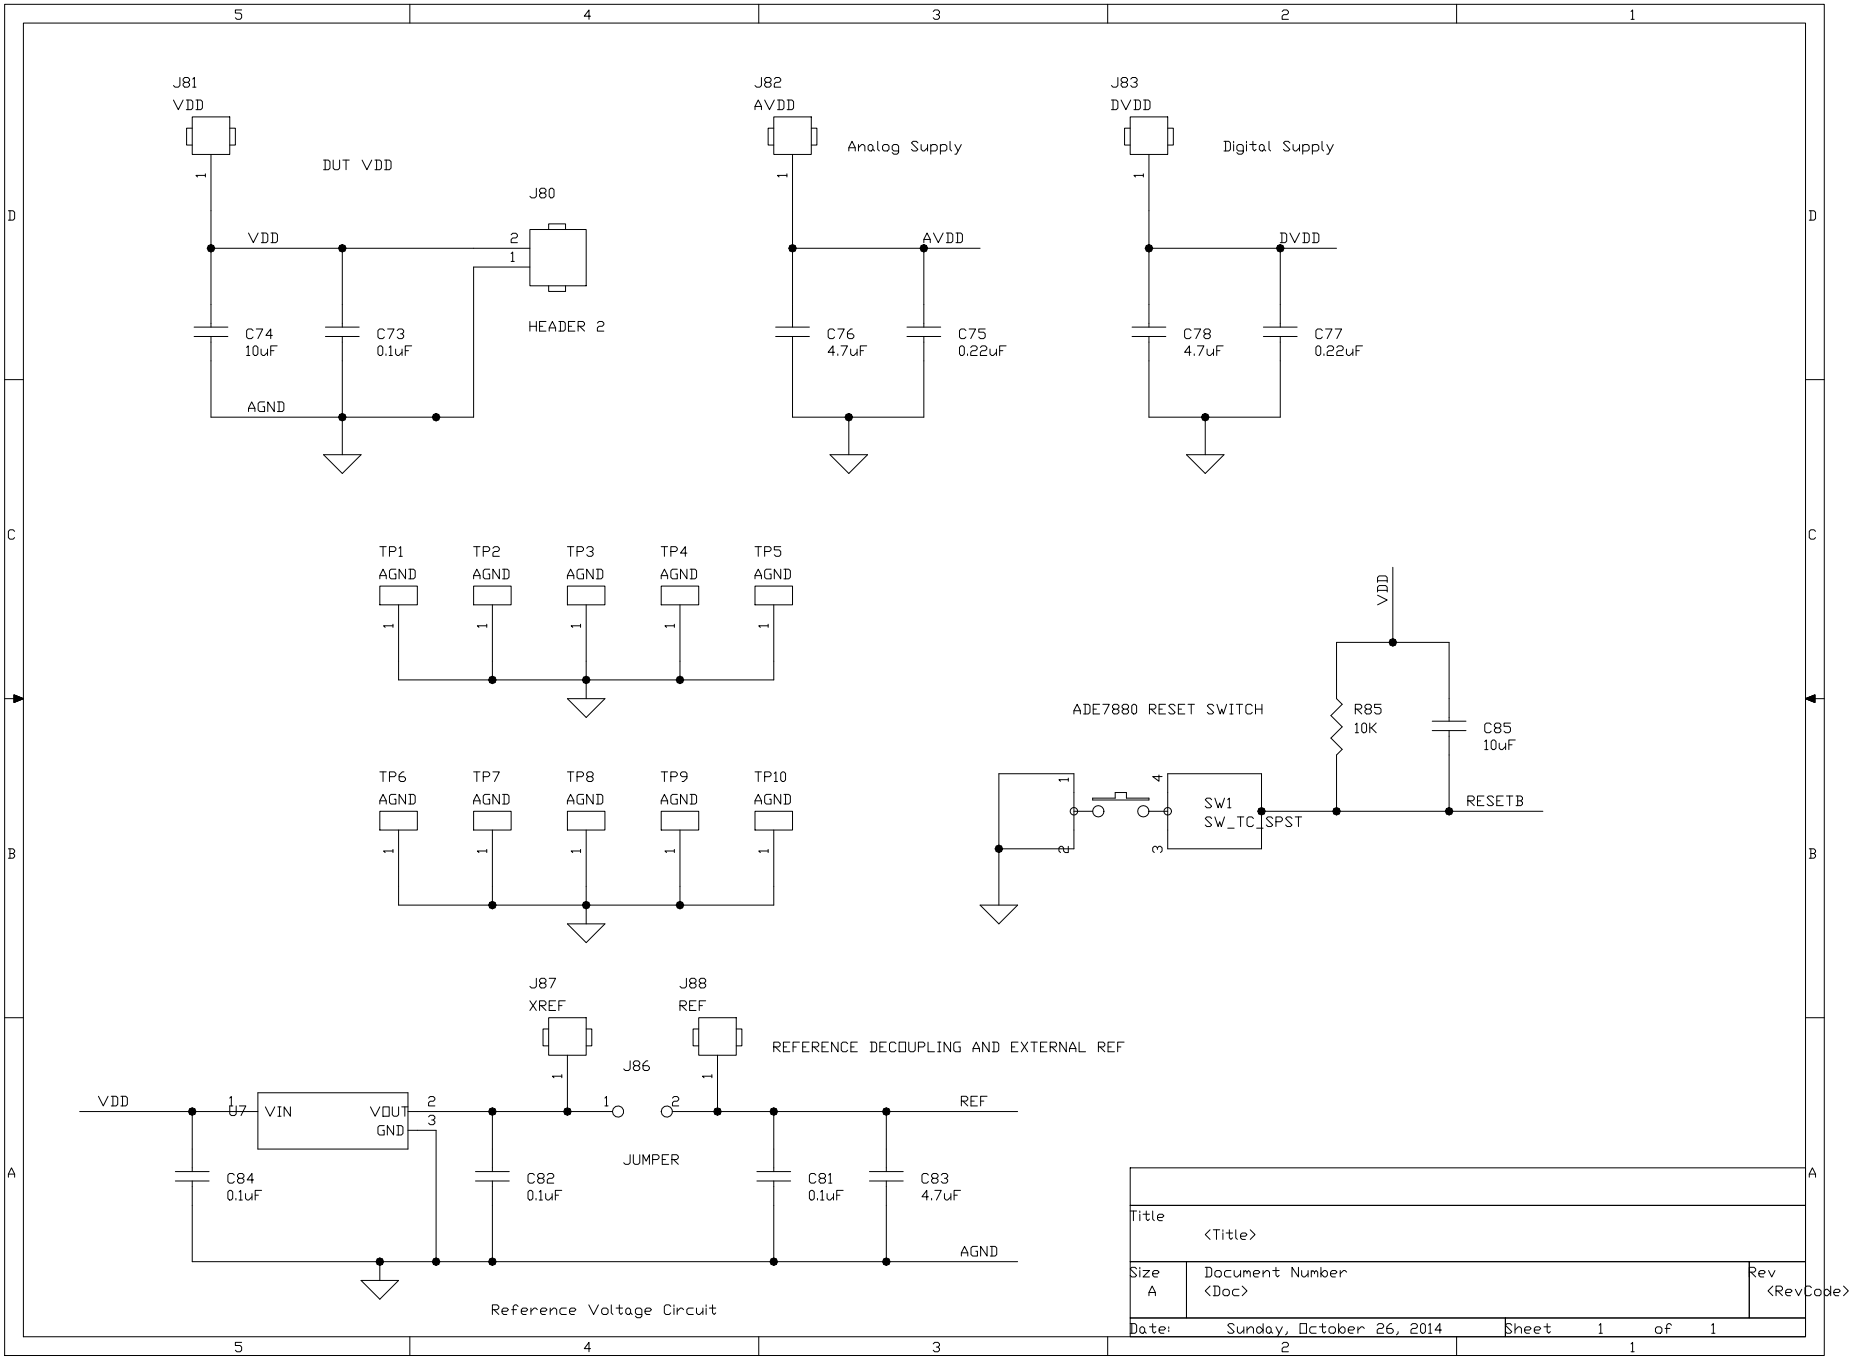
[picture p85: page 1]
