manojgulati/Harmonic-Analyser/Harmonic Analyser/Orcad_Capture_SESDP/ver2.0/PAGE1_SCHEMATIC1_PAGE3.pdf

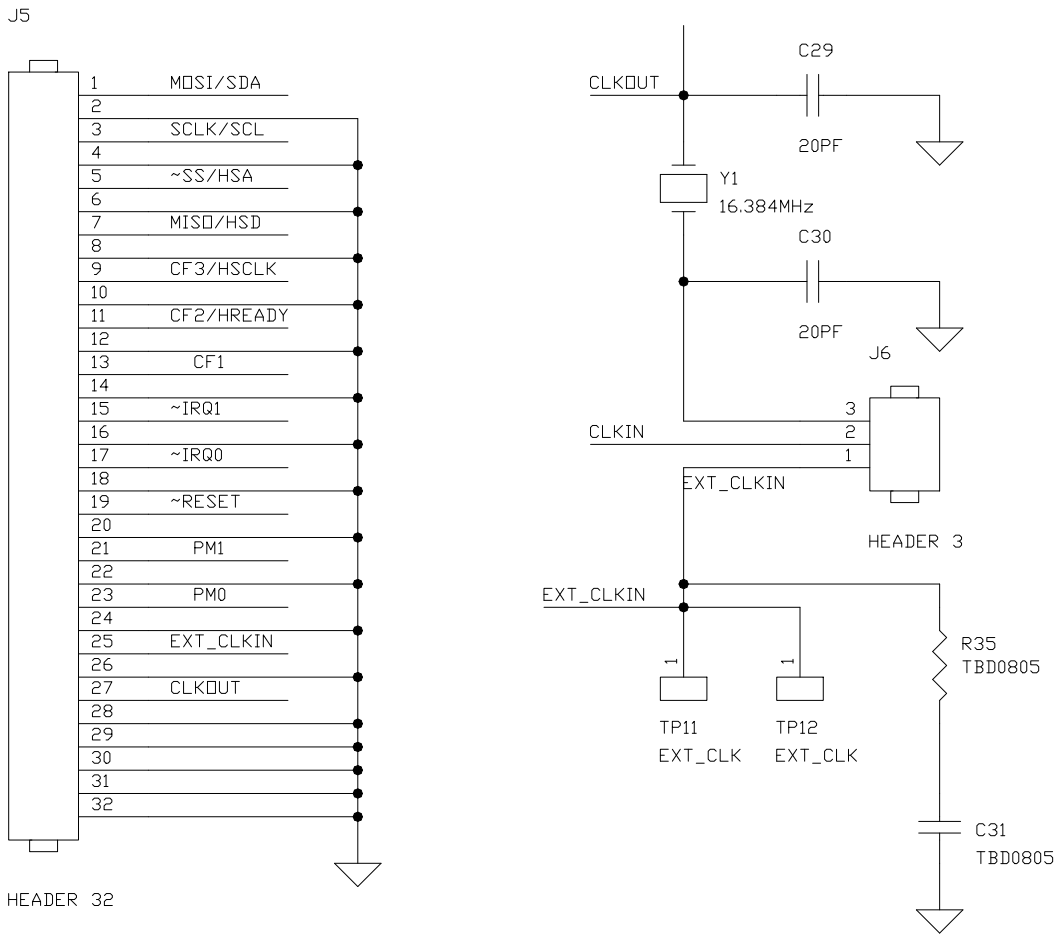
[picture p86: page 1]
