manojgulati/Harmonic-Analyser/(list of files, drawings)

Other design files:
Harmonic Analyser/Board Design Support Files/Orcad Symbol ADE7880/2014-10-17_12-35-19/2014-10-17_12-35-19.OLB
Harmonic Analyser/Board Design Support Files/Orcad Symbol ADE7880/2014-10-17_12-35-19/2014-10-17_12-35-19.opj
Harmonic Analyser/Board Design Support Files/Orcad Symbol ADR280ARTZ-R2/2014-10-18_00-19-09/2014-10-18_00-19-09.OLB
Harmonic Analyser/Board Design Support Files/Orcad Symbol ADUM1250ARZ/2014-10-18_15-26-44/2014-10-18_15-26-44.OLB
Harmonic Analyser/Board Design Support Files/Orcad Symbol ADUM3401CRWZ/2014-10-18_03-20-32/2014-10-18_03-20-32.OLB
Harmonic Analyser/Orcad_Capture_SESDP/KL34 Board Narnix - ver0.1/SAM-MAINBOARD.DSN
Harmonic Analyser/Orcad_Capture_SESDP/KL34 Board Narnix - ver0.1/sam-mainboard.opj
Harmonic Analyser/Orcad_Capture_SESDP/KL34 Board Narnix - ver0.2/SAM-MAINBOARD.DSN
Harmonic Analyser/Orcad_Capture_SESDP/KL34 Board Narnix - ver0.2/sam-mainboard.opj
Harmonic Analyser/Orcad_Capture_SESDP/KL34 Board Narnix/SAM-MAINBOARD.DSN
Harmonic Analyser/Orcad_Capture_SESDP/KL34 Board Narnix/sam-mainboard.opj
Harmonic Analyser/Orcad_Capture_SESDP/ver1.0/DESIGN2.DSN
Harmonic Analyser/Orcad_Capture_SESDP/ver1.0/Design2.opj
Harmonic Analyser/Orcad_Capture_SESDP/ver1.1/DESIGN2.DSN
Harmonic Analyser/Orcad_Capture_SESDP/ver1.1/Design2.opj
Harmonic Analyser/Orcad_Capture_SESDP/ver1.2/DESIGN2.DSN
Harmonic Analyser/Orcad_Capture_SESDP/ver1.2/Design2.opj
Harmonic Analyser/Orcad_Capture_SESDP/ver1.3/DESIGN2.DSN
Harmonic Analyser/Orcad_Capture_SESDP/ver1.3/Design2.opj
Harmonic Analyser/Orcad_Capture_SESDP/ver1.4/DESIGN2.DSN
Harmonic Analyser/Orcad_Capture_SESDP/ver1.4/Design2.opj
Harmonic Analyser/Orcad_Capture_SESDP/ver1.5/DESIGN2.DSN
Harmonic Analyser/Orcad_Capture_SESDP/ver1.5/Design2.opj
Harmonic Analyser/Orcad_Capture_SESDP/ver1.6/DESIGN2.DSN
Harmonic Analyser/Orcad_Capture_SESDP/ver1.6/Design2.opj
Harmonic Analyser/Orcad_Capture_SESDP/ver1.7/DESIGN2.DSN
Harmonic Analyser/Orcad_Capture_SESDP/ver1.7/Design2.opj
Harmonic Analyser/Orcad_Capture_SESDP/ver1.8/DESIGN2.DSN
Harmonic Analyser/Orcad_Capture_SESDP/ver1.8/Design2.opj
Harmonic Analyser/Orcad_Capture_SESDP/ver2.0/DESIGN2.DSN
Harmonic Analyser/Orcad_Capture_SESDP/ver2.0/Design2.opj
Harmonic Analyser/Orcad_Capture_SESDP/ver2.1/DESIGN2.DSN
Harmonic Analyser/Orcad_Capture_SESDP/ver2.1/Design2.opj
Harmonic Analyser/Orcad_Capture_SESDP/ver2.2/DESIGN2.DSN
Harmonic Analyser/Orcad_Capture_SESDP/ver2.2/Design2.opj
Harmonic Analyser/Orcad_Capture_SESDP/ver2.3/DESIGN2.DSN
Harmonic Analyser/Orcad_Capture_SESDP/ver2.3/Design2.opj
Harmonic Analyser/Orcad_Capture_SESDP/ver2.4/DESIGN2.DSN
Harmonic Analyser/Orcad_Capture_SESDP/ver2.4/Design2.opj
Harmonic Analyser/Orcad_Capture_SESDP/ver2.5/DESIGN2.DSN
Harmonic Analyser/Orcad_Capture_SESDP/ver2.5/Design2.opj
Harmonic Analyser/Orcad_Capture_SESDP/ver2.6/DESIGN2.DSN
Harmonic Analyser/Orcad_Capture_SESDP/ver2.6/Design2.opj
Harmonic Analyser/Orcad_Capture_SESDP/ver2.7/DESIGN2.DSN
Harmonic Analyser/Orcad_Capture_SESDP/ver2.7/Design2.opj
Harmonic Analyser/Orcad_Capture_SESDP/ver2.8/DESIGN2.DSN
Harmonic Analyser/Orcad_Capture_SESDP/ver2.8/Design2.opj
Harmonic Analyser/Orcad_Capture_SESDP/ver2.9/DESIGN2.DSN
Harmonic Analyser/Orcad_Capture_SESDP/ver2.9/Design2.opj
Harmonic Analyser/Orcad_Capture_SESDP/ver2.10/DESIGN2.DSN
Harmonic Analyser/Orcad_Capture_SESDP/ver2.10/Design2.opj
Harmonic Analyser/Orcad_Capture_SESDP/ver2.11/DESIGN2.DSN
Harmonic Analyser/Orcad_Capture_SESDP/ver2.11/Design2.opj
Harmonic Analyser/Orcad_Capture_SESDP/ver2.12/DESIGN2.DSN
Harmonic Analyser/Orcad_Capture_SESDP/ver2.12/Design2.opj
Harmonic Analyser/Orcad_Capture_SESDP/ver2.14/PCB Design/DESIGN2.DSN
Harmonic Analyser/Orcad_Capture_SESDP/ver2.14/PCB Design/Design2.opj
