manojgulati/Harmonic-Analyser/Harmonic Analyser/Board Design Support Files/Orcad Symbol ADE7880/2014-10-17_12-35-19/EDI@CAP.cfg

;>------- Configuration parameters: -------<
;>------Check EDIF2CAP.PDF for details ----<

[OrCAD Writer]

SuppressWarnings = 0	
ConvertOnlyLibs = 0
UnitMeasurement = inch
PinToPin = 0
Grid = 0
EnableOffgridObjects = 1
GenerateIniFile = 1
OrcadConventions = 1
UseDesignatorsForPackaging = 0
DesignatorsEndOnLetters = 1
DesignatorsSameInHierarchy = 1
GeneratePinNumbers = 0
GeneratePortSymbols = 0
GenerateOffPageConnectors = 0
GenerationVisible = 1
CaptureLibsWithUserPackages = ""
SystemNetNamePrefix = ""
BackgroundTextScale = 0.8
DefaultNetNameScale = 0.3
StandardPageSize = 0
EliminatePageText = 0
SmashTitleBlock = 0
PinDisplayStyle = orcad
TopView = ""
ComponentsMode = 0
ReplacePartWithNoPinsWithTitleBlock = 0
ChangeBusBaseThatEndsOnDigit = 0
ProcessBackAnnotation = 1

[Mapper]
