manojgulati/Harmonic-Analyser/(commit log)

2014-12-17 Initial commit
    Files taken from previous project
    [2014-10-17_12-35-19.OLB, 2014-10-17_12-35-19.opj, 2014-10-18_00-19-09.OLB, 2014-10-18_03-20-32.OLB, 2014-10-18_15-26-44.OLB, BOM.xlsx, DESIGN2.DSN, Design2.opj]
2015-01-07 Updated Schematic to rectify mistakes ver2.11
    [DESIGN2.DSN]
2015-01-07 Revised ver2.11
    [DESIGN2.DSN, Design2.opj]
2015-01-14 Revised J14 Header Box
    [DESIGN2.DSN, Design2.opj]
2015-01-15 Added J5 Header and Relay Circuit
    [DESIGN2.DSN, Design2.opj]
2015-01-16 Added PDF of schematic ver2.11
    [DESIGN2.DSN, Design2.opj]
2015-02-07 Updated sch
    [DESIGN2.DSN, Design2.opj]
2015-05-13 Updated Schematic for harmonic analyser
    [DESIGN2.DSN, Design2.opj]
2015-05-16 Added PDF of schematic
    [Design2.opj]
2015-06-13 added schematic
